13093053/barfmachine/products/portfolio/mail_holt.jpg

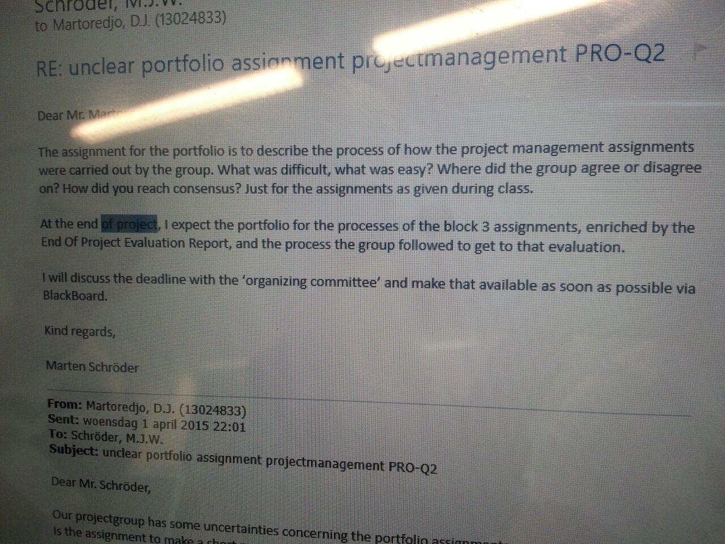
products/portfolio/mail_holt.jpg
