13093053/barfmachine/README.md

# Project PRO-Q2
Speaker amplifier system - Project HHS 2015
