13093053/barfmachine/products/final_design_report/Final Design Report PRO-Q2 team 1 (version1).pdf

## PRO-Q2 Final Design Report

Daan Conijn, 13023217
Andrew Lau, 13058339
Kevin Oei,13090062
Koen van Vliet, 13093053
Group 1

EQ2.a
EQ2.c

June 12th, 2015

## Contents

5 | 1 Summary | 4
| 2 Introduction | 5
| 3 The project problem, specifications and preconditions | 6
4 Design overview | 10
5 Preamplifier analysis | 19

2

6 Power supply design | 31
7 DCU design | 34

7.1 The DCU, related components, and its connection to the rest of

45 | 8 Test procedures and test results | 39
50 | 9 Total costs of system | 42
10 Conclusions and recommendations | 44

3

## 1 Summary

Section 2 gives an introduction of the project PRO-Q2 of team 1.

Section 3 explains the problem description regarding the design of the active
55 | loudspeaker in detail. The specifications and the preconditions are also pre-
| sented in section 3.
| Section 4 shows the design overview of the active loudspeaker. Schematics of
| the preamplifier, power supply, power amplifier and the DCU are presented in
| this section. The values of the components are also presented in the schematics.
60 | Section 5 gives an in-depth analysis of the preamplifiers regarding the calcula-
| tions, simulations and measurements.
| Section 6 explains the design of the power supply in detail. It explains what
| choices were made in the design of the power supply
| Section 7 explains what choices were made in designing the DCU, what code
65 | the DCU consists of and how the DCU functions.
| Section 8 gives the results of the test procedure and how the tests were done.
| Section 9 gives the total cost of the system. The prices and the types of the
| components are presentend in this section.
| Section 10 gives the conclusion and recommendations of the project as a whole.

4

70 | 2 | Introduction

In the second year of the Electrical Engineering course at The Hague University of Applied Science, project PRO-Q2 marks the end of the primary programme. All the specific knowledge and skills needed in previous projects come together in this one project with a duration of one semester. Students are presented with
75 | the challenge of designing a complete speaker system with digital enhancements.
| This report will offer the reader a detailed look into all of the design aspects
| realized by team 1 of PRO-Q2, as well as test results and an overview of the
| total costs of the required materials. After reading this report, one should be
| able to assemble the functional product as described in the report.

5

80 | 3 | The project problem, specifications and pre- conditions

The project problem introduces the fictional company BARK, a small yet wellknown manufacturer of loudspeakers [1]. For some time, BARK has contemplated the development of a series of active speakers using built-in power am-85 plifiers. The market price of these types of speakers have shown a significant reduction in the recent years, thus making it an interesting move for the company. Speakers with this setup offer a range of great advantages, including the avoidance of large speaker cables, the possibility of using cheaper electronic crossover circuits and a straight-forward design of the circuits.

90 It is likely that buyers of these active speakers also have the intention of buying a high-end stereo preamplifier. These types of preamplifiers are known to be expensive and uncommon. For this reason, BARK developed a new preamplifier to be built into the speaker system. The specifications of the preamplifier have already been established by a previous team.

95 | 3.1 | The problem

In light of the recent digitization of every electronic product, BARK decided that it also wants the speaker and its electronics to be controlled by a digital system of some sorts. However, being a loudspeaker manufacturer, their knowledge of analogue and digital electronic systems is somewhat limited. A series of 100 researches are to be conducted in order to gain the required knowledge and skills in these fields. The project team is to design an active loudspeaker system and realise a demonstration model according to the specifications and preconditions given. By the end of the project, the live demonstration should prove the correct operation. Documentation and a cost calculation are also to be provided.

105 | 3.2 | Specifications and preconditions

The specifications and preconditions given by BARK encompass both the analogue as well as the digital part of the to-be-designed system. The following components are described:

- Preamplifier

110 • Power amplifier

- Power supply
- Digital part

6

### 3.2.1 Preamplifier

The configuration of the preamplifier has already been partially determined.
115 | The values of the components have to be calculated and additional components
| have to be implemented in order to make the design of the preamplifier meet
| the required specifications.
| The specifications are as follows:

Overall specifications preamplifier Balance control in flat position, tone 120 (bass and treble) control switched off, volume control at maximum.

1. Input impedance: minimum 100 kΩ
2. Output impedance: maximum 100 Ω
3. Sensitivity : 2 V output voltage in RL = 20 kΩ at 200 mV input
4. Frequency range: 2 Hz to 400 kHz (-3 dB) at Vout = 500 mV, RL = 20
125 | kΩ
5. Output voltage: at least 7 V sinusoidal with RL = 20 kΩ , f = 1 kHz

Balance control specifications

1. Range ±6 dB (within ±0.5 dB) difference between right and left channels
2. In flat position +2 dB (within ±0.5 dB)

130 3. Approximate logarithmic control function

4. No DC current through the potentiometer nor the wiper

Bass and treble control specifications

1. Treble: Cut-off frequency adjustable between 2.5 and 10 kHz. Maximum boost or attenuation 10 dB (±1 dB) at 2.5 kHz. From 100 kHz and up
135 | the transfer function must approach value 1 (0 dB).
2. Bass: Cut-off frequency adjustable between 100 Hz and 400 Hz. Maximum
| boost or attenuation 10 dB (±1 dB) at 400 Hz. From 10 Hz and below
| the transfer function must approach value 1 (0 dB).

7

3. Approximate logarithmic control functions for cut-off frequencies and boost
140 | / attenuation adjustments
4. No DC currents through potentiometers nor wipers
5. Option: tone controls are switched on and off without any clicking noises
| from the speakers

Volume control specifications

145 1. Approximately logarithmic control function

2. No DC current through the potentiometer nor the wiper

The preconditions are as follows:

1. The potentiometers for balance, bass, treble and volume control are 10 kΩ linear.

150 2. The potentiometers for the adjustment of the bass / treble cut-off frequen- cies are 10 kΩ logarithmic.

3. All the preamplifier’s opamps are low noise NE5532 type. The NE5532 is
| a dual opamp version of the NE5534. Both Multisim and Pspice contain suitable models for the NE5532 and the NE5534.
155 | 4. The simulation results of the sub circuits and the preamplifier are rep- resented by the transfer function (amplitude and phase characteristics). These simulation results must be compared with the transfer function gained by measurement. Draw your conclusions.

### 3.2.2 Power amplifier specifications

160 1. Input impedance of at least 50 kΩ

2. Output power: 15 W sine in Rload = 8 Ω at 1 kHz
3. Frequency range: 10 Hz to 100 kHz (−3 dB) at Pload = 0.5 W in 8 Ω

For simplicity of design, the power amplifier should be a monolithic component.

8

### 3.2.3 Power supply

165 The power supply must supply all rated voltages and current in the system as to be determined by the project team. The power supply should be constructed using linear regulators. The projected efficiency should be 80% or better.

### 3.2.4 Digital part

The project team is to determine and develop the functionality of the digital part
170 | of the system. BARK mainly deals with analogue electronics, and so the project
| team is asked to help develop attractive features that are to be implemented
| within the project’s duration. The features should be discussed with the project
| coach beforehand. The system will consist of at least:
- An ATmega32 microcontroller or similar;

175 • Some kind of interaction with the analogue part of the system.

9

## 4 Design overview

As already hinted, the system primarily consists of four subsystems. They are the preamplifier, power amplfier, power supply and the digital component (referred to as ’DCU’ from here on, short for ’Digital Control Unit’). While the
180 | design for the preamplifier is already predetermined for the most part, all other parts have to be designed from scratch. An overview of the system’s design will be presented in this section, with minor to no additional clarifications on the design itself. The sections that follow will offer a detailed look into the analysis/design of the parts.
185 | 4.1 | Preamplifier

The design of the preamplifier can be divided in the following parts:

- Balance control
- Tone (bass and treble) control
- Volume control

190 These parts will be looked at in greater detail separately, figure 1 shows a schematic overview of the entire preamplifier to show the connection between the different parts.

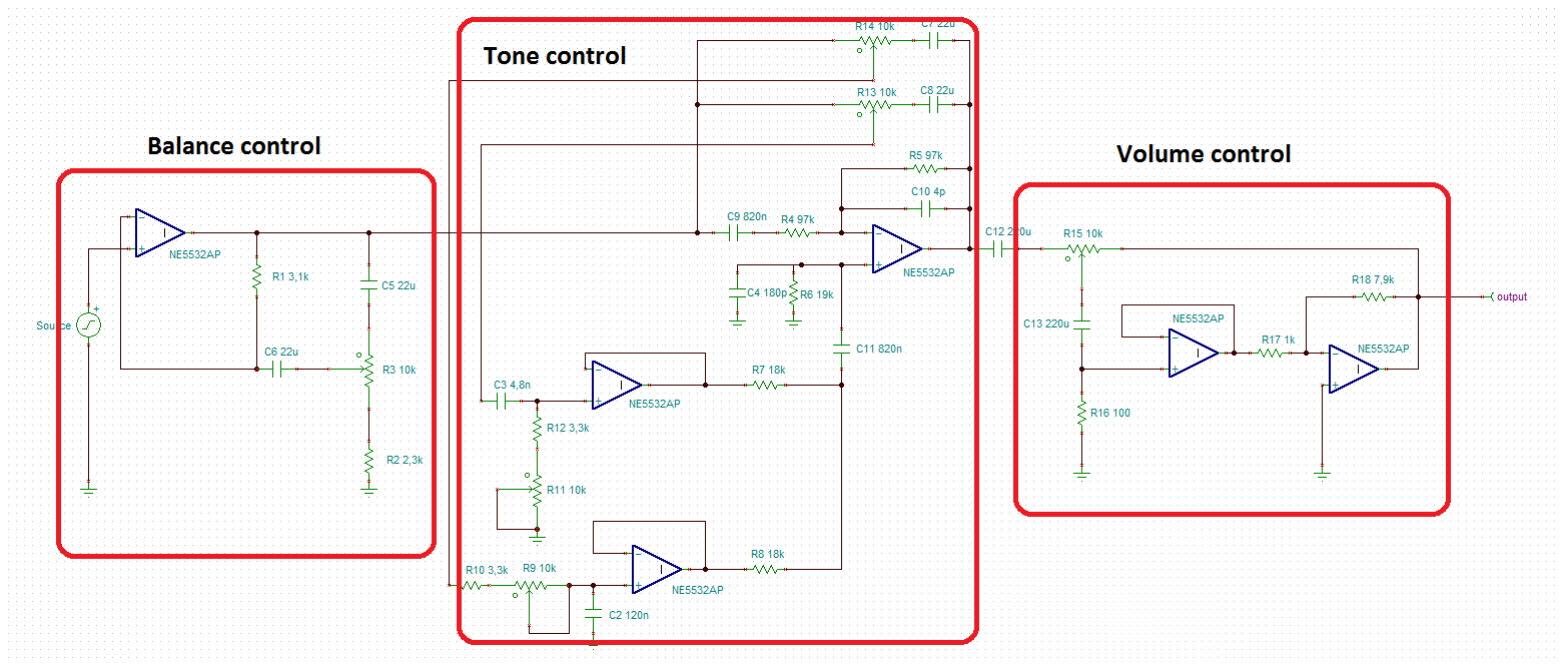
[picture p3: figure]

Figure 1: Schematic preamplifier

All parts of the preamplifier have been realized on prototyping boards.

10

A capacitor that filters out the AC signal removing the noise and provides a
195 | DC signal is known as a bypass capacitor. The capacitors connected at Vcc and
| Vee in figure 2 is a bypass capacitor bypassing AC noise and allowing pure DC
| signal to pass through the component.

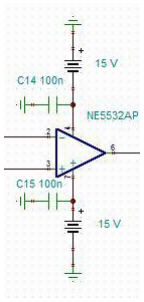
[picture p4: figure]

Figure 2: Schematic preamplifier

### 4.1.1 Balance control

The schematic of the balance control is as shown in figure 3. It function is to be
200 | able change the difference between the right an left channels. Thus if a stereo
| configuration is used then the balance of the output can be adjusted. Since
| there is only one channel in our configuration the balance control will function
| as an volume control with a range of 0 to 6dB. The digital potentiometer on the
| balance control is adjustable by using the DCU.

11

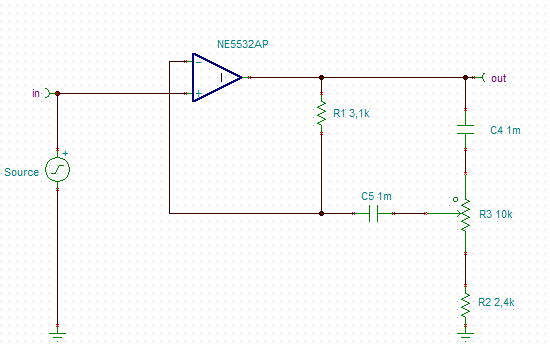
[picture p5: figure]

Figure 3: Schematic of balance control

205 | 4.1.2 | Tone control

The schematic of the Tone control is as shown in figure 4. The tone control will filter out the frequencies who are not in a 2Hz-400kHz range. Between this range there are two potentiometers who are used to adjust the Bandwidth of the Bass and Treble. Bass has a range from 10Hz through an adjustable Cut-off 210 frequency between 100Hz-400Hz. Treble has a range from an adjustable Cut-off frequency between 2.5kHz-10kHz through 100kHz. Within these ranges the signal can be boosted or attenuated by 10dB. All the potentiometers can be controlled using the DCU.

12

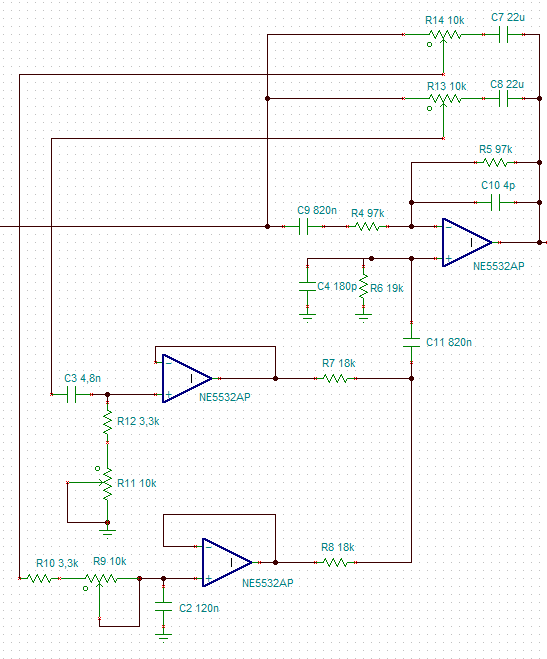
[picture p6: figure]

Figure 4: Schematic of tone control

### 4.1.3 Volume control

215 The schematic of the Volume control is as shown in figure 5. The volume control is used to boost or attenuat the signal as a whole. By adjusting the digital potetiometer the signal can be boosted or attenuated within an range of -24dB through 18dB.

13

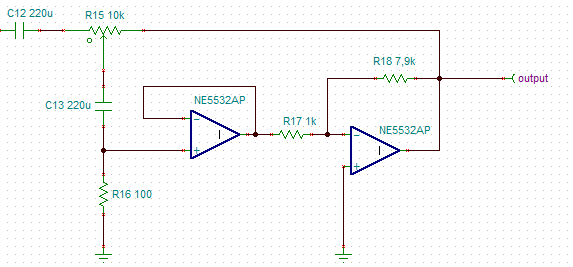
[picture p7: figure]

Figure 5: Schematic of volume control

### 4.2 Power amplifier

220 The schematic of the power amplifier design is as shown in figure 6.

14

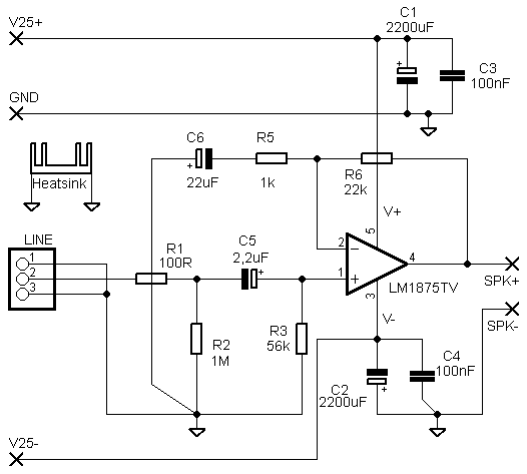
[picture p8: figure]

Figure 6: Schematic of power amplifier

Note that pins 1 and 3 of the line-in (named ’LINE’ in the schematic) are both connected to ground. This allows for plugging of the mating connector without having to worry about the connector being plugged in the wrong way around. It is also worth noting that a 100 Ω resistance is connected in series with the
225 | input to protect the amplifier against overvoltage. The added resistance allows
| the clamping diodes inside the amplifier to deal with any excess voltage.
| The PCB design of the power amplifier is as shown in figure 7.

15

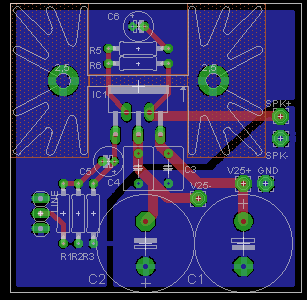
[picture p9: figure]

Figure 7: PCB board design of power amplifier

### 4.3 Power supply

The schematic of the power supply is as shown in figure 8.

16

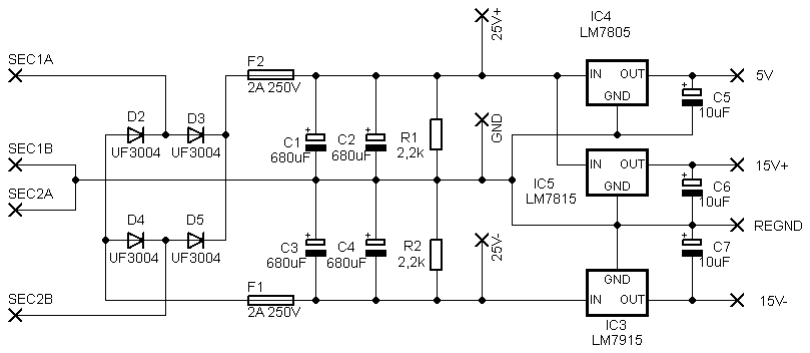
[picture p10: figure]

Figure 8: Schematic of power supply

230 The PCB design of the power supply is as shown in figure 9.

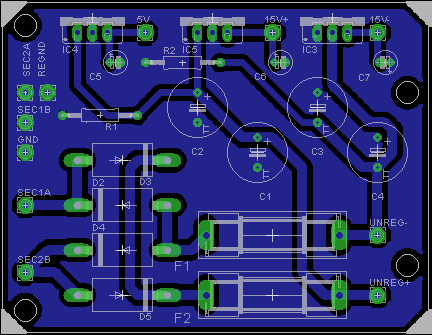
[picture p11: figure]

Figure 9: PCB board design of power supply

17

### 4.4 DCU

The following features and choices have been chosen/made for the implementation of the DCU:

- For the microcontroller, an ATmega328 will be used since it bears a lot of
235 | similarity with the ATmega32 which the team is most familiar with.
| • The DCU will allow digital control of the balance, tone, bass, treble and
| volume controls through the use of digital potentiometers.
| • MIDI messages will be used to pass commands to the DCU

Figure 10 shows a very basic schematic of the DCU’s place within the speaker 240 system.

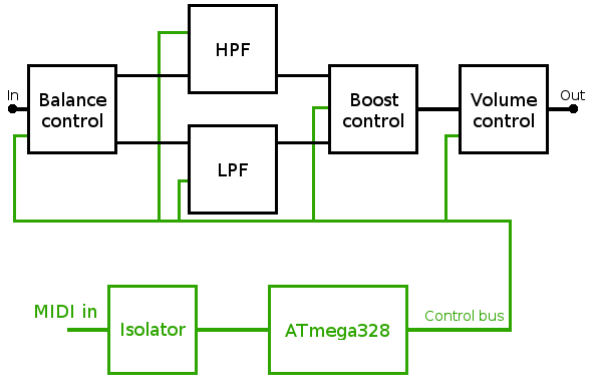
[picture p12: figure]

Figure 10: Block diagram of DCU

18

## 5 Preamplifier analysis

The in-depth analysis of the preamplifier consists of calculations, simulations and measurements. The calculations of the balance control, tone control and the volume control were already calculated in the measurement reports but the 245 calculations will again be discussed in this chapter.

### 5.1 Calculations

### 5.1.1 Balance control

In this section, the calculations of the components of the balance control are presented.

250 Figure11 shows the position of RH and RL.

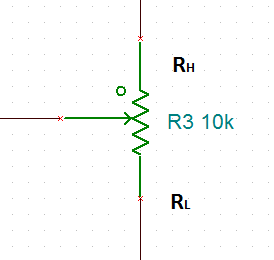
[picture p13: figure]

Figure 11: Positions of RH and RL of the potentiometer in the balance control

The formula for the gain of the balance control is equal to:

Gain =

R1//RH + RL + R2
RL + R2

= 1 +

R1//RH
RL + R2

(1)

In the manual it is stated that the gain must be +2 dB in flat position. Therefore the gain can be derived:

20 · log(Af lat−position) = 2 dB

19

log(Af lat−position) = 1
10

Af lat−position = 10

1
10 ≈ 1, 26 | (2)

In the manual it is stated that the gain must be +6 dB if the balance control is 255 in maximum position. Therefore the gain can be derived with the potentiometer in maximum position:

20 · log(Ahigh) = 6 dB

log(Ahigh) = 3
10

Ahigh = 10

3
10 ≈ 2 | (3)

equation (2) can be substituted in equation (1) and RH and RL are 5,000 Ω.

1, 26 =

5, 000 · R1
(R1 + 5, 000) · (R2 + 5, 000)

R2 + 5000 =

5, 000 · R1
1.26 · (R1 + 5, 000)

R2 =

3, 700 · R1 − 6.5 · 10⁶
1.26 · R1 + 1, 300) | (4)

equation (3) can be substituted in equation (1), RH = 10,000 Ω and RL = 0 Ω. The value of RLis actually very small (±0.5 Ω) but because the value is very 260 small, RL can be omitted.

2 = 1 +

10, 000 · R1
(R1 + 10, 000) · R2

R2 =

10, 000 · R1
(R1 + 10, 000) | (5)

20 equation (5) can be substituted in equation (4) and therefore the value of R1 can be calculated.

3, 700 · R1 − 6.5 · 10⁶
1.26 · R1 + 1, 300) =

10, 000 · R1
(R1 + 10, 000)

2, 600R

2

1 + 13 · 10⁶
- R1 = 3, 700 · R

2

1 + 30.5 · 10⁶

- R1 − 6.5 · 10¹⁰

1, 100R

2

1 + 17.5 · 10⁶

- R1 − 6.5 · 10¹⁰ = 0

R1R1 =

17.5 · 10⁶ ± 24, 336, 187
2, 200
R1 = 3, 107.35 ≈ 3, 107 Ω | (6)
R1 = −19, 016 Ω | (7)

A resistor can never have a negative value so therefore R1 is equal to 3,107 Ω. To calculate R2 , equation (6) can be filled in in equation (4) or equation (5).

R2 =

10, 000 · 3, 107
(3, 107 + 10, 000) = 2, 370 Ω | (8)
265 | 5.1.2 | Tone control

The tone control is divided into five sections. The tone control contains two low-pass filters, two high-pass filters and a band-pass filters as seen in figure 12.

21

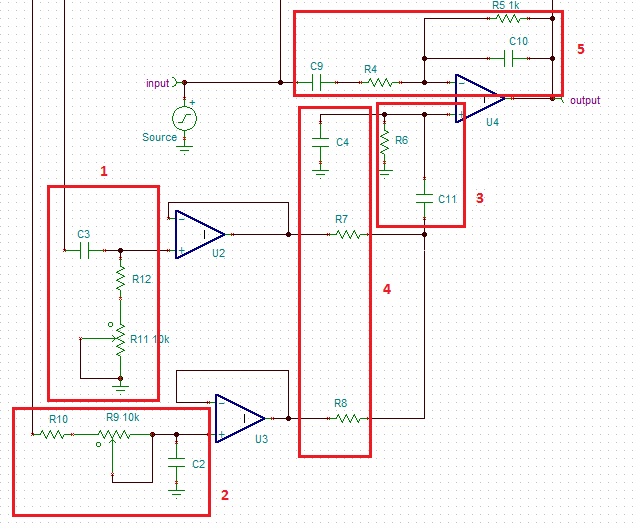
[picture p14: figure]

Figure 12: Tone control divided in sections

Section 1: A high-pass filter with a cut-off frequency adjustable between 2,5 kHz and 10 kHz

270 | Section 2: A low-pass filter with a cut-off frequency adjustable between 100 Hz and 400 Hz
| Section 3: A high-pass filter with a cut-off frequency of 10 Hz
| Section 4: A low-pass filter with a cut-off frequency of 100 kHz
| Section 5: A band-pass filter with a cut-off frequency of 2 Hz and 400 kHz
275 | Section 1 The HPF
| At a frequency of 10 kHz

10000 =

1
2π · R12 · C3

C3 =

1
2π · R12 · 10000

(9)

22

At a frequency of 2.5 kHz

2500 =

1
2π · (R12 + 10000) · C3

C3 =

1
2π · (R12 + 10000) · 2500

(10)

Substitute equation (9) in equations (??) and (??) to calculate resistor

1
2π · R12 · 10000

=

1
2π · (R12 + 10000) · C
R12 = 3333.33 Ω | (11)

Substitute equation (11) in equations (??) and (??) or equation (9) to calculate 280 the capacitor

C3 =

1
2π · (3333.33 + 10000) · 2500
= 4, 8 nF | (12)

Section 2 The LPF

At a frequency of 400 Hz

400 = | 1 2π · R10 · C2

C2 =

1
2π · R10 · 400

(13)

At a frequency of 100 Hz

100 =

1
2π · (R10 + 10000) · C2

C2 =

1
2π · (R10 + 10000) · 100

(14)

23

Substitute equation (13) in equation (14) to calculate resistor

1
2π · R10 · 400

=

1
2π · (R10 + 10000) · 100
R10 = 3333, 33 Ω | (15)
285 | Substitute equation (15) in equation (13) or equation (14) to calculate the ca-
pacitor

C2 =

1
2π · (3333, 33 + 10000) · 2500
= 119 nF | (16)

Section 3 The HPF

The maximum value of a ceramic capacitor available in the lab at the Hague University is 820 nF.

290 Capacitor C11 is chosen for 820 nF and with a cut-off frequency of 10 Hz for the HPF, the resistor R6 can be calculated with the formula:

R6 =

1
2π · C11 · 10
R6 = 19, 409 Ω | (17)

Section 4 The LPF

The maximum boost or attenuation of the bass must be 10 dB at 400 Hz and the maximum boost or attenuation of the treble must be 10 dB at 2.5 kHz.

295 The gain of the boost is equal to:

GainBoost =

R7//R8 + R6
R7//R8

20 · log(

R7|//R + R6
R7|//R ) = 10 dB

24

R7//R8 + R6
R7//R = 10

1
2 | (18)

The gain of the attenuation is equal to:

GainAttenuation =

R7//R
R7//R8 + R6

20 · log(

R7//R8
R7//R8 + R6

) = −10 dB

R7//R8
R7//R8 + R6

= 10⁻ ¹
2 | (19)

The resistors R6, R7 and R8 can be any values, as long as the values of the resistors meet the requirement for the boost to be 10dB with the potentiometer in maximum position.

300 | It is best if R7 is equal to R8 because the boost and attenuation of the bass and treble will differ. R7 and R8can be calculated by substituting the value of R6 in equation (18) or equation (19)
| R7//R8 + 19, 409 R7//R8 = 10
| 1
| 2

R7//R8 + 19409 = 3, 16 · R7//R8

R7//R8 = 8, 900 Ω

R7 = R8 = 17, 800 Ω | (20)

With a cut-off frequency of 100 kHz for the LPF in section 4, the capacitor C4 can be calculated with the formula:

C4 =

1
2π · (R7//R8) · 100 · 10³
C4 = 180 pF | (21)

25

305 | Section 5 The BPF
| The frequency range must be between 2 Hz and 400 kHz and the gain at these frequencies must be -3 dB. Therefore the resistors and capacitors can be calcu- lated for the band-pass filter with the formula:

fcut−of f =

1
2π · R · C

(22)

For the design of the band-pass filter, a value of 820 nF is chosen for capacitor
310 | C9. The resistors can now be calculated.
| For the HPF part of the band-pass filter is the resistor R4 equal to:

R4 =

1
2π · 2 · 820 · 10⁻⁹
= 97, 045 Ω | (23)

The balance control and the volume control regulate the gain of the preamplifier. Therefore the band-pass filter does not need to amplify the signal. Thus it is neccessary for R4 to be equal to R5to attain a gain of 1 (0 dB).

315 For the LPF part of the band-pass filter, the capacitor is equal to:

C10 =

1
2π · 400 · 10³ · 97, 045
= 4.1 pF | (24)

### 5.1.3 Volume control

With an input voltage of 200mV, an output voltage of 2V must be acquired with the balance control in flat position, tone (bass and treble) control switched off and the volume control at maximum. With a gain of approximately 1.26 in the
320 | balance control and a gain of 1 in the tone control, the voltage at the input of
| the volume control is approximately equal to:
Uinput−volume−control = 1.26 · 1 · 200mV = 252 mV | (25)

The input voltage of the volume control is now known and because the volume control is at maximum, the voltage at the output of U5 is equal to the input voltage of the volume control. The values of R17 and R18 can be calculated.

26

R18

R17

- Uinput−volume−control = 2 V

R18

R17

- 0.252V = 2 V

325
R18

R17

= 7.94 | (26)

The ratio between R18 and R17 is 7.94. The values of R18 and R17 can be determined. The following values have been chosen for R18 and R17:

R18 = 7, 940 Ω | (27)
R17 = 1, 000 Ω | (28)

With the volume control at minimum, the gain should be very low (-∞ dB) but that is impossible in practice. Therefore simulations are required to determine 330 what the gain can be if the volume control is almost set to the minimum (99%). The gain with the volume control set almost to the minimum is approximately -50 dB. The gain with the potentiometer in middle position (50%) is equal to:

17.95dB − (

17.95dB − −50dB
2

) = −16 dB

Resistor R16 can be calculated to acquire an approximate logarithmic control function:

20 · log|

R16
5, 000 + R16

·

7, 940
1, 000

| = −16 dB

335
log(

R16
5, 000 + R16

·

7, 940
1, 000

) = −

16
20

R16
5, 000 + R16

·

7, 940
1, 000

= 10⁻ ¹⁶
20
R16 = 100 Ω | (29)

27

### 5.2 Simulations

Figure 13 shows a simulation of the bode plot of the preamplifier with the bass and treble both at maximum boost, the volume control in mid position, the
340 | balance control in mid position, the bass corner frequency at 400 Hz and the
| treble corner frequency at 2.5 kHz.

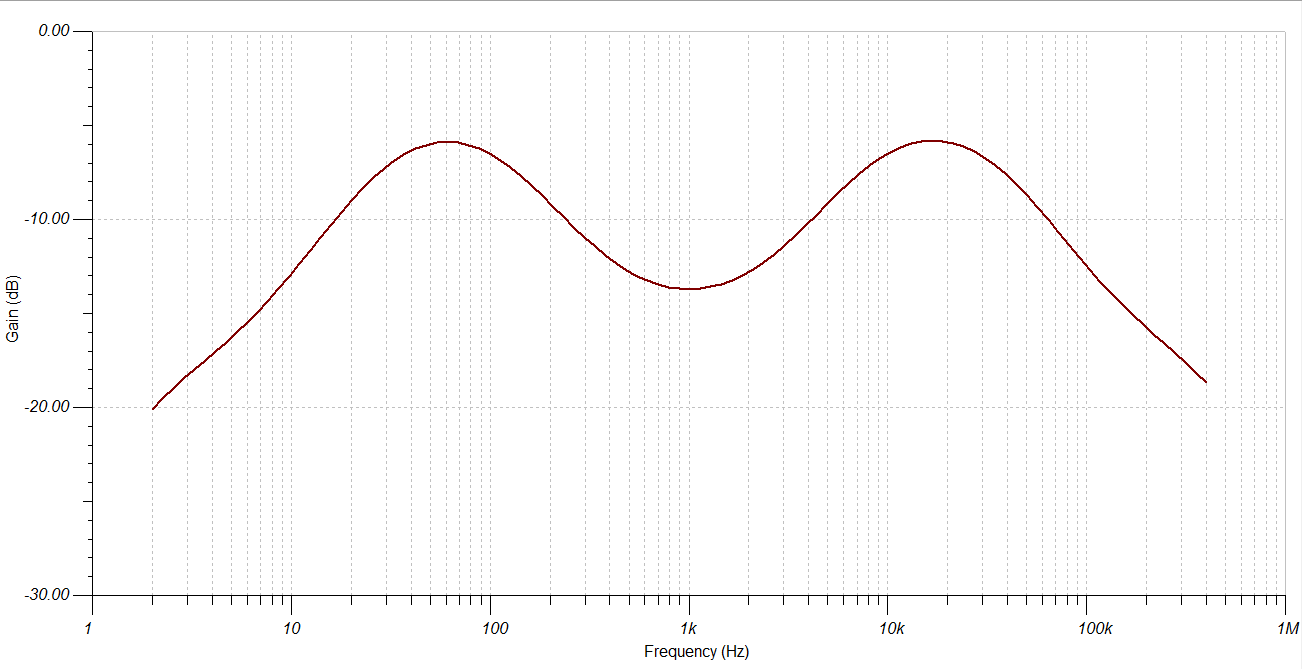
[picture p15: figure]

Figure 13: Bode plot of the preamplifier in maximum boost

Figure 14 shows the simulation of the bode plot of the preamplifier with the bass and treble both at maximum attenuation, the volume control in mid position, the balance control in mid position, the bass corner frequency at 400 Hz and 345 the treble corner frequency at 2.5 kHz.

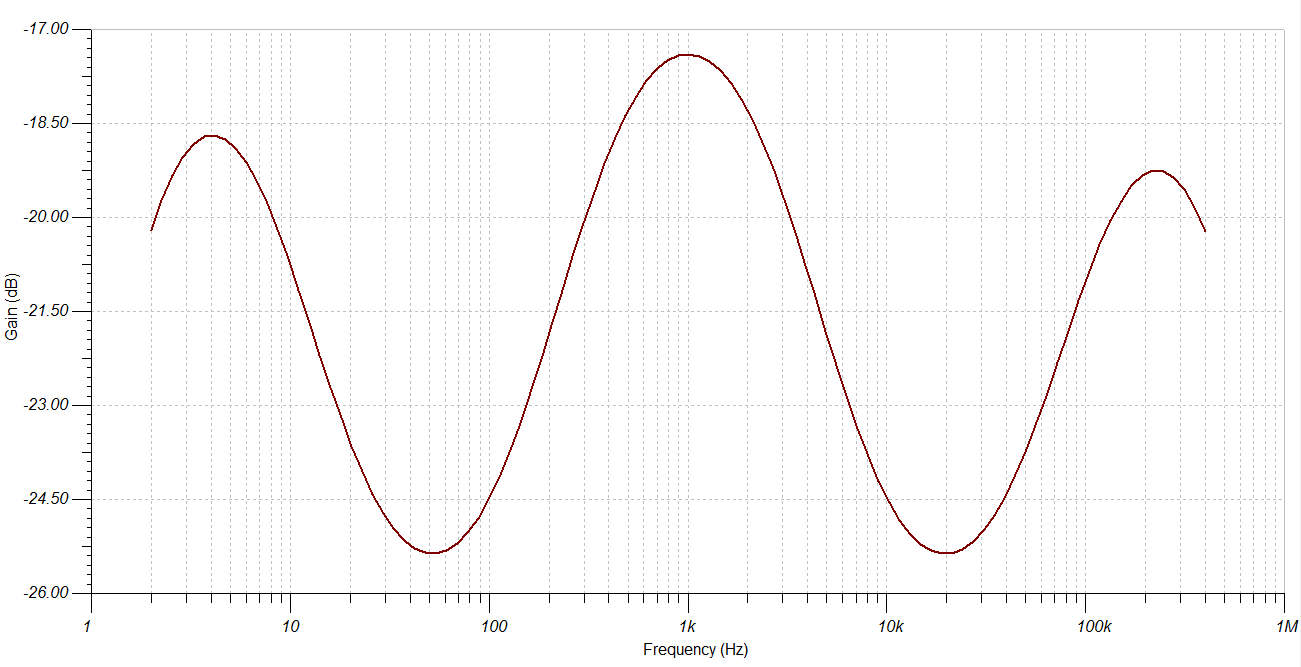
[picture p16: figure]

Figure 14: Bode plot of the preamplifier in maximum attenuation

28

### 5.3 Measurements

Figure 15 shows a bode plot of the preamplifier with the bass and treble both at maximum boost, the volume control in mid position, the balance control in mid position, the bass corner frequency at 400 Hz and the treble corner frequency 350 at 2.5 kHz. The measurements for determining the bode plot in figure 15 are in table 4 in Appendix A.

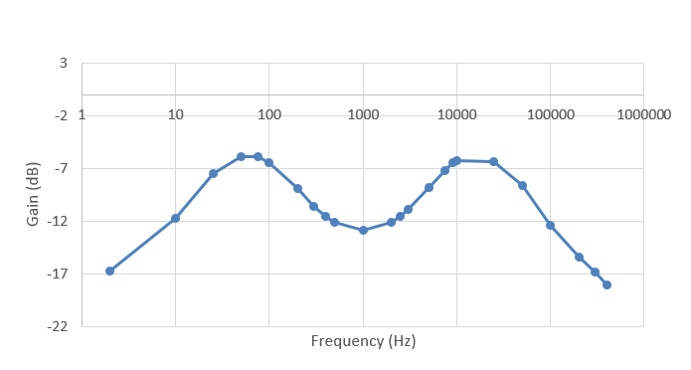
[picture p17: figure]

Figure 15: Bode plot of the preamplifier in maximum boost

Figure 16 shows a bode plot of the preamplifier with the bass and treble both at maximum attenuation, the volume control in mid position, the balance control in mid position, the bass corner frequency at 400 Hz and the treble corner 355 frequency at 2.5 kHz. The measurements for determining the bode plot in figure 16 are in table 3 in Appendix A.

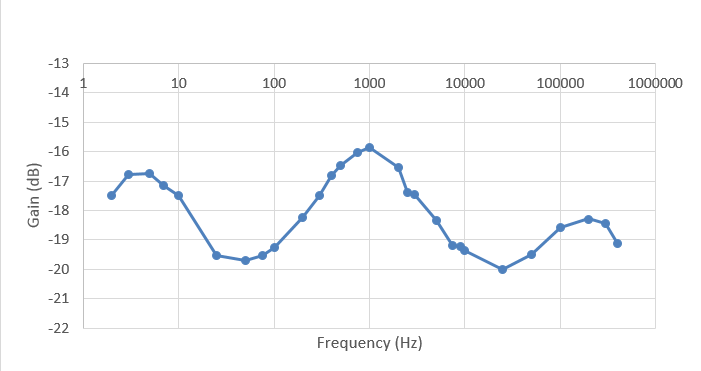
[picture p18: figure]

Figure 16: Bode plot of the preamplifier in maximum attenuation

29

The bode plots of the measurements correspond with the bode plots of the simulations.

30

## 6 Power supply design

360 The power supply takes 230V mains and converts it to lower voltages to power the various modules in the speaker system. First a quick design overview is given and the schematic is explained. Then the individual stages of the supply are discussed and finally the energy efficiency and board layout are explained.

### 6.1 Design overview

365 | The power supply is a linear non-switching supply, which uses a toroidal trans- former to take 230V mains down to 36V. The power amplifier and the pream-
| plifier require a split supply by design, so a transformer with two secondary windings is used. After the transformer comes a bridge rectifier which converts
| the AC signal to DC. Then finally the signal will pass through several filter
370 | capacitors to smooth out the voltage.

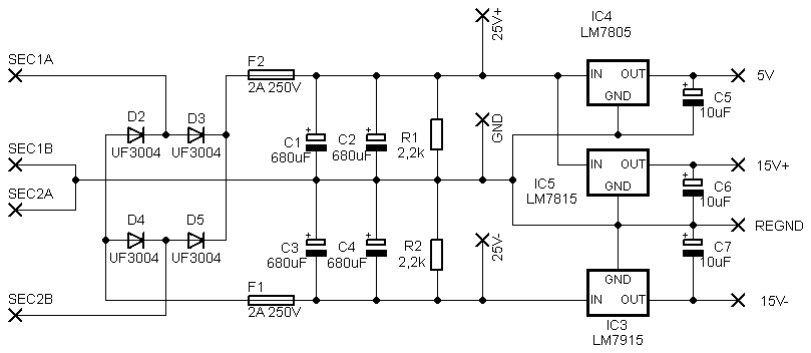
[picture p19: figure]

Figure 17: Power supply schematic

### 6.2 Filter section

Per rail two filter capacitors are used in order to reduce the ripple voltage caused by the equivalent series resistance. A bypass resistor is put in parallel with the capacitors, so they discharge safely when the power supply is switched off even
375 | with no load on the output.
| The nominal voltage can be calculated as follows:

31

Vin,pk−pk = Vin ∗

√
2 = 36 ∗

√
2 = 51V

V out = Vin,pk−pk − 2Vd(on) = 51 − 1.4 = 50V

At full power output the ripple voltage on the positive and negative supply can 380 be calculated:

Ton =

1
2f =

1
100

∆V out =

I∗Ton
C =

0.7∗0.01
2∗680∗10⁻⁶ = 5V

According to the power amplifier’s specifications this is an acceptable ripple voltage. Additional filter capacitors were added close to the power amplifier to 385 reduce the loop size and increase stability. With these additional capacitors in place the ripple voltage becomes:

∆V out =

I∗Ton
C =

0.7∗0.01
(2∗680+2200)∗10⁻⁶ = 2V

### 6.3 Protection

The power supply is fused on both secondary windings to protect the transformer
390 | against high currents. The nominal current of the secondary windings of the
| transformer is 0.420A while the power amplifier takes 0.694A from the supply
| at max power . The capacitors in the power supply will smooth out the load
| on the transformer, so it does not exceed the nominal current. The fuses on
| the secondary windings are rated 2A, so they only blow on a short circuit. The
395 | primary winding could be fused optionally.

### 6.4 Regulator section

The preamplifier and DCU require lower voltages, so linear voltage regulators are used to step down the voltage. For the power amplifier, however an unregulated supply is used. The regulators require small capacitors between the output 400 terminals to stabilize the output voltage, so a few 10uF capacitors were added.

### 6.5 Efficiency

As said before, the power amplifier’s power rails are unregulated. This is required to meet the 80% energy efficiency requirement. If linear regulators were used to regulate 25 down to 20V at 0.5A this would result in a 2.5W loss in the

32

405 regulator. In this case the energy efficiency would be 80% for the regulator stage alone. The power dissipated in the linear regulators for the preamp and dcu is neglectable, because these parts take very little current compared to the power amplifier. The overall efficiency of the power supply is equal to the efficiency of the transformer multiplied by that of the diode bridge rectifier.

ηdiode =

Vin,pk−pk−2Vd(on)

Vin,pk−pk

=

51−1.4
410 | 51 | = 0.97

ηtransformer = 0.87

ηtotal = ηdiode ∗ ntransformer = 0.85

Therefore the overall efficiency is 85%.

### 6.6 Board layout

415 The power supply can be constructed on a single sided board to reduce manufac- turing cost. The components are all through-hole, because small surface mount parts cannot handle the high voltages and currents. It also makes soldering a prototype by hand easier.

Figure 18: Power supply board layout

33

## 7 DCU design

420 | The DCU’s entire functionality was to be determined by the project team. The only requirements given by BARK were the use of an ATmega32 microcontroller or similar controllers, and some kind of interaction with the analogue part of the system. In team 1’s case, the DCU allows control of all audio controls (potentiometers) in the analogue circuits using MIDI messages. The DCU then
425 | adjusts the values of digital potentiometers placed in the circuits based on the incoming MIDI message. First, the physical design of the DCU and related components are discussed. After that, the code used for the DCU will be looked
| at.

### 7.1 The DCU, related components, and its connection to

430 | the rest of the system

The choice to use MIDI messages as input for the DCU was made with the idea that MIDI hardware is generally designed for use with music and/or audio. On top of that, professional mixing devices can be controlled using computer software, allowing preset settings to be loaded in a matter of a few clicks. Many
435 | MIDI devices include twisting knobs which act as potentiometers, and thus being
| able to use a MIDI device to control the various controls in the circuitry allows for an intuitive and easily expandable/customizable user interface. The type of
| digital potentiometers used in combination with the DCU are the MCP4251- 103E/P (see figure 19).

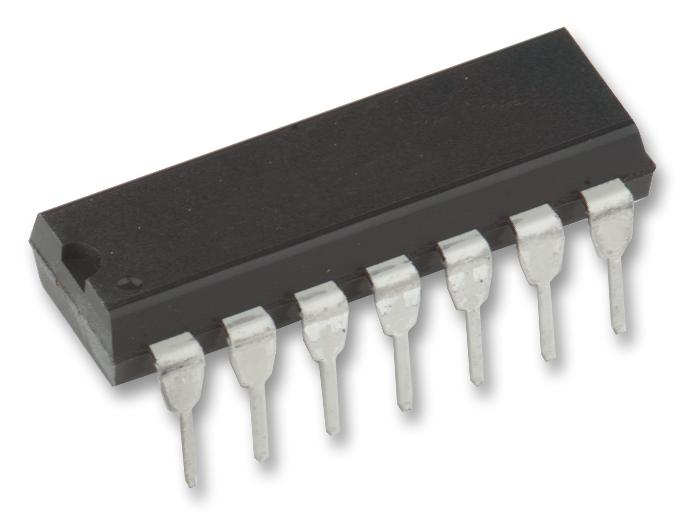
[picture p20: figure]

Figure 19: The MCP4251-103E/P

34

440 | These models hold two potentiometers per package, and expect incoming com-
| mands through SPI which makes them easily usable with the ATmega328 which
| supports a direct SPI connection. As illustrated in figure 20, the digital poten-
| tiometers allow the DCU to take over control of the balance control, bass cut-
| off control, treble cut-off control, bass boost control, treble boost control and
445 | volume control. In its current state, the code only handles so-called ’Control
| Change’ MIDI messages which indicate the change of a physical control, such as
| a knob. These messages include a value indicating the position of the knob as
| well as an identifier indicating which specific knob was changed. The message is
| processed in the DCU and the correct command is passed on to the appropriate
450 | potentiometer over the SPI connection. Only when a new ’Control Change’ message is received, will the digital potentiometer(s) be adjusted accordingly.

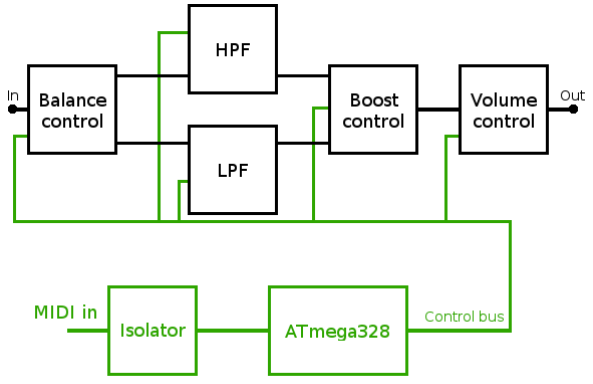
[picture p21: figure]

Figure 20: Block diagram of DCU

As seen in figure 20, the control bus (ATmega328 SPI output) is connected to all parts of the preamplifier. The control bus consists of seven signal lines: six CS (chip select) lines and one data line (carrying the value to be read by
455 | the digital potentiometer. The MIDI input and the USART of the ATmega328
| are electrically isolated using an optocoupler. This protects both devices from
| overvoltage and static discharges. It also makes it possible to swap out midi cables while the speaker system is powered on. Figure 21 shows the schematic of the DCU part.

35

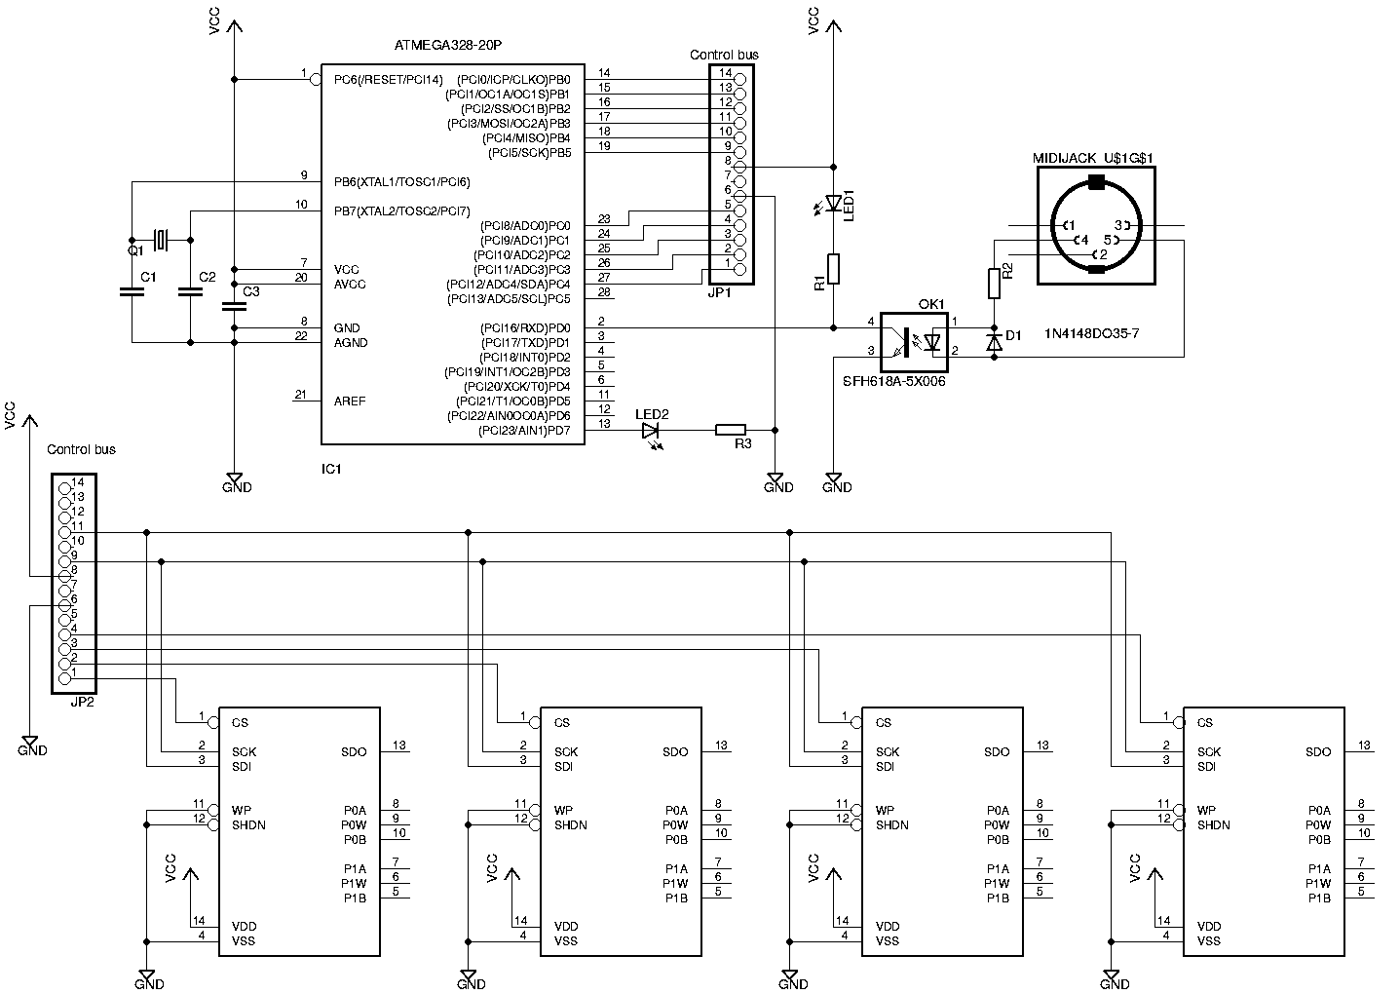
[picture p22: figure]

Figure 21: Schematic of DCU

460 | 7.2 | C code

The C code can be divided into the following subsections:

- Headers for digital potentiometers and MIDI
- Initialization
- Main program loop
465 | • MIDI input functions
| • Digital potentiometer output functions

The individual blocks of code will be discussed and explained. In order to see how the different parts of the code are connected to each other, the complete C code can be found in Appendix B. When addressing specific pieces of code, 470 references will be made to the line numbers as seen in these appendices.

36

### 7.2.1 digipots.h and midi.h

The two custom header files used in the code contain all the constants asssociated with the ports (and pins) connected to the peripheral devices. As seen in Appendix B, digipots.h contains the correct values to set the DDR and PORT
475 | registers associated with the potentiometers. The *_CS_PIN constants define the
| correct value to be written to the PORT register that drive the CS pins of the
| digital potentiometers. Since there is only one data line for all of the controls,
| when writing a value to the digital potentiometers, only the appropriate CS
| pins are to be driven. This will become more clear when the output functions
480 | are discussed. midi.h contains all the constants associated with the incoming
| MIDI data. MIDI messages consist of at least one byte. In case of MIDI Control
| Change messages which we are concerned with, a full message consist of three
| bytes: a command byte 1011nnnn, and Controller Number byte 0ccccccc and
| a Controller Value byte 0vvvvvvv respectively where nnnn denotes the MIDI
485 | channel, ccccccc denotes the controller number and vvvvvvv denotes the value
| of the controller. CTRL_CH is the byte value in the MIDI message that denotes the type of MIDI command (in our case, Control Change). The *_CTRL constants
| are used to define what controller number (in the 0ccccccc byte) correspond
| to what control. This way the program will be able to determine which CS pin
490 | should be driven when the received controller value is passsed on to the digital
| potentiometers.

### 7.2.2 Initialization

The initializations are made in dcu.c, from the beginning to line number 66. The global variables are declared, appropriate DDR registers are set, the USART
495 | registers are set, and the SPI registers are set. Finally, all controls are reset by
| initializing the digital potentiometers to maximum position. The appropriate
| values to be loaded into the UBRRH and UBRRL registers of the USART have
| been calculated based on the values defined in line numbers 20 to 24. The for-
| loop on lines 61 to 63 set the digital potentiometers to the maximum value one
500 | by one.

### 7.2.3 Main program loop

The main program loop, an infinitely looping while-loop from lines 69 to 106, calls the appropriate functions to control the digital potentiometers whenever new data is received from the MIDI device through the USART. The program
505 | will wait at the while (rxcnt == 0); lines for a new byte to arrive through the
| USART. On line 73, a command byte will be expected. If a new byte is received,
| it is stored into cmd. On line 74, the command byte is checked for validity.
| 37

If valid, the program continues and the error LED is turned off. Otherwise, the program will end up waiting at line 72 again for a valid command byte.
510 | After passing the command validity check, the same process is repeated for the
| Controller Number and Contorller Value bytes. If either of these checks fail, the
| else-statement is executed and a LED is switched on using toggleErrorLED(). When all received bytes are valid (making up a complete valid three-byte Control
| Change message), a switch case at lines 83 to 95 will select the appropriate
515 | action. There is only one case in this case (excluding the default case), but the
| system can be expanded in the future to include more functionality using this
| switch case.

### 7.2.4 MIDI input functions

There are two blocks of code dealing with the incoming MIDI messages. They
520 | are the interrupt service routine (ISR) USART_RXC_vect (lines 151 to 169) and
| the function ugetc() (lines 185 to 192). Whenever a MIDI device sends a byte
| to the ATmega328, the ISR is executed and the incoming data is checked. If the
| USART deems the data valid, the UDR is unloaded into variable c and stored
| into the buffer sb if it is not full yet. Finally, rxcnt is incremented. One can
525 | now see that in the main loop, the program will only pass the ’waiting’ lines
| when rxcnt is not equal to zero, which means one or more unread bytes are
| stored in the buffer.
| When a message byte needs to be stored into the variables in the main loop,
| ugetc() is called. This function selects the correct byte in the buffer and stores
530 | it in local variable c. It then decrements rxcnt and returns c.

### 7.2.5 Digital potentiometer output functions

There are two functions related to the output controlling the digital potentiometers. They are spiSend() (lines 112 to 117) and setPot() (lines 119 to 139). When setPot() is called, a switch case chooses the appropriate case based on
535 | the parameter potno. Inside each case, the appropriate CS pin is driven and
| spiSend() is called with the appropriate parameters.
| spiSend() takes two arguments, the memory address value memcom and the
| control value val. This function does nothing more but transmitting the two
| bytes over SPI one by one. The while statements force the program to wait with
540 | continuing untill the SPI is finished with he transmission.

38

## 8 Test procedures and test results

Figure 22 shows the complete loudspeaker system. This active loudspeaker system was tested using the procedures below.

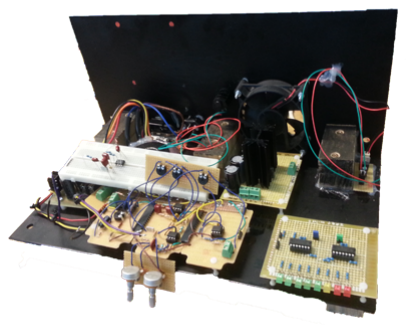
[picture p23: figure]

Figure 22: The built active loudspeaker system

### 8.1 Equipment

545 | The following equipment was used to test the active loudspeaker system:
| • Audio source (e.g. phone)

39

- Audio cable
- Power cable
- ’TEKTRONIX DPO2004B’ oscilloscope

550 • 8Ohm speaker

### 8.2 Setup

- Remove all power and audio cables from the speaker system and make sure the power switch is turned off before proceeding.
- Connect the speaker to the output of the power amplifier.
555 | • Connect the audio source to the input of of the preamplifier.
| • Connect the power cable to the input of the power supply.
| • Make sure that everything is connected before switching the power on.
| • Switch the power on.

40

### 8.3 Results

Table 1: The result of the test
# | Procedure | Expected Results | Pass / Fail / Not Tested

| Play music from the audio source | Hear music coming from the speaker regardless the performance of the sound. | Pass
1 | Test the volume of the preamplifier. | No audible sound when the volume control adjust is turned down to the minimum. The sound will get louder as the volume control is turned up to the maximum
Pass
2 | Is the sound clear? | No distortion, no clipping, little mains hum
Pass
3 | Test the bass of the preamplifier | Low frequencies will be heard when the bass is in maximum boost.
Pass
4 | Test the treble of the preamplifier | High frequencies will be heard when the treble is in maximum boost
Pass
| Switch off the unit and remove the heatsink.
5 | Turn up the volume. Does the thermal shutdown feature of the amplifier work? | The amplifier should shut down when it reaches 170°C
Pass

6 | Test the DCU system | Not Tested
560 | 8.4 | Notes on the test

There were some problems with test number 2 in table 1. The sound coming from the speaker temporarily shuts down (approximately two seconds) and turns back on. This problem happens in an interval between 10 to 15 seconds. This problem is solved by measuring the outputs of the power amplifier and
565 | the preamplifier and comparing the signals during the shutdown of the sound.
| During shutdown there is no signal at the power amplifier but there is a signal
| at the preamplifier. This means that the problem lies within the power ampli-
| fier. After examining the power amplifier, it was discovered that the transistor
| wasn’t attached well to the heatsink, so it would become too hot and shut itself
570 | down. After tightening the bolt that clamps the heatsink to the power amplifier
| there have been no more thermal shutdowns.

41

## 9 Total costs of system

The following components are required to build the power amplifier, preamplifier, power supply and digital control unit. Please note that these prices are
575 | only an indication. Prices may change over time.
Name | Amt | Farnell No, Price Each | Price
Power supply
Power switch | 1 | 1839427 | 4,45 | 4,45
Transformer | 1 | 9530380 | 24,98 | 24,98
D2/D3/D4/D5: | 4 | 1861507 | 0,0638 | 0,2552
Power connector | 1 | 2080459 | 0,95 | 0,95
Fuse holder | 3 | 1162740 | 0,563 | 1,689
C1/C2/C3/C4 : 680u | 4 | 1800669 | 0,26 | 1,04
C5/C6/C7: 10u | 3 | | 0,1 | 0,3
R1/R2: 2.2k | 2 | | 0,02 | 0,04
IC4:LM7805CT | 1 | 1102157 | 0,84 | 0,84
IC5:LM7815CT | 1 | 2296025 | 0,71 | 0,71
IC3:LM7915CT | 1 | 2296026 | 1,22 | 1,22
HEATSINK | 3 | 1710627 | 0,506 | 1,518
Fuse 2A,250V | 3 | 1123175 | 0,183 | 0,549
Power amplifier
LM1875T | 1 | 1468913 | 3,36 | 3,36
HEATSINK | 1 | 1319813 | 5,29 | 5,29
R1: 100 | 1 | | 0,02 | 0,02
R2: 1M | 1 | | 0,02 | 0,02
R3: 56k | 1 | | 0,02 | 0,02
R5: 1k | 1 | | 0,02 | 0,02
R6: 22k | 1 | | 0,02 | 0,02
C1/C2: 2200uF | 2 | 2346523 | 1,63 | 3,26
C3/C4: 100nF | 2 | | 0,1 | 0,2
C5: 2.2uF | 1 | | 0,1 | 0,1
C6: 22uF | 1 | | 0,1 | 0,1
Preamplifier
Phono Jack | 1 | 148266 | 2,38 | 2,38
NE5532P | 4 | 1106092 | 0,79 | 3,16
R1: 3.1k | 1 | | 0,02 | 0,02
R2: 2.4k | 1 | | 0,02 | 0,02
R4/R5: 97k | 2 | | 0,02 | 0,04
R6: 19k | 1 | | 0,02 | 0,02

42

R7/R8: 18k | 2 | | 0,02 | 0,04
R10/R12: 3.33k | 2 | | 0,02 | 0,04
R16: 100 | 1 | | 0,02 | 0,02
R17: 1k | 1 | | 0,02 | 0,02
R18: 7.9k | 1 | | 0,02 | 0,02
C2: 120n | 1 | | 0,1 | 0,1
C3: 4.8n | 1 | | 0,1 | 0,1
C4: 180p | 1 | | 0,1 | 0,1
C5/C6/C7/C8: 22u | 4 | | 0,1 | 0,4
C9/C11: 820n | 2 | | 0,1 | 0,2
C10: 4p | 1 | | 0,1 | 0,1
C12/C13: 220u | 2 | | 0,1 | 0,2
C14...C22: 100nF | 8 | | 0,1 | 0,8
IC socket DIP8 | 4 | 2445620 | 0,195 | 0,78
Digital control unit
IC1: ATMEGA328-PU | 1 | 1972087 | 2,36 | 2,36
MCP4251-103E/P | 4 | 1578442 | 0,921 | 3,684
IC socket DIP28 | 1 | 2445626 | 0,44 | 0,44
IC socket DIP14 | 4 | 2445621 | 0,198 | 0,792
Crystal 16MHz | 1 | 1611761 | 0,378 | 0,378
C1/C2: 22pF | 2 | | 0,1 | 0,2
LED1/LED2: red led | 2 | 2112100 | 0,214 | 0,428
D1:1N4148 | 1 | 9565124 | 0,0203 | 0,0203
R1/R2/R3: 150 | 3 | | 0,02 | 0,06
VO617A-2 | 1 | 2251550 | 0,187 | 0,187
DIN5 jack | 1 | 1280804 | 1,45 | 1,45
C3: 100n | 1 | | 0,1 | 0,1
IC socket DIP6 | 1 | 2445619 | 0,204 | 0,204
Misc
TERMINAL
BLOCK | 10 | 3041440 | 0,819 | 8,19
Pin headers m20 | 2 | 671990 | 1,6 | 3,2
Pin headers f20 | 1 | 1577768 | 2 | 2
PCB single sided | 1 | 149056 | 13,46 | 13,46
Misc wire ass. | 1 | | 2 | 2
| | Total (ex vat): | | ?98, 66
| | Total: | | ?119, 38

43

## 10 Conclusions and recommendations

After approximately 2 months of working on PRO-Q2, the active loudspeaker was finally finished by connecting the power supply, the power amplifier and the preamplifier. After testing the active loudspeaker as a whole, the team
580 | concluded that the active loudspeaker works. The sound may not be perfect
| but at the very least the speaker is able to reproduce sound without excessive
| distortions. Unfortunately the DCU was not tested.
| The bass and treble also works well when turning the bass and treble on and off.
| The volume control works well when turning the volume off and on. The balance
585 | control works when turning the balance control on and off. The preamplifier was
| simulated and measured and the bode plots of the simulations and measurements
| correspond with each other as seen in section 5. The conclusion can be made
| that the calculations of the components of the preamplifier are correct and that
| the preamplifier meets the specifications.
590 | The power supply meets all specifications and it supplies all voltages required
| to make the system work.
| The power amplifier meets all specifications, its temperature stays within the
| accepted range and it produces clean audio.
| As the source code in the appendices already notes, at the time of writing the
595 | DCU had not been connected and tested yet. Building the code resulted in
| the expected errors associated with the yet-to-be-defined values in the header
| files, but all other errors that were previously present have been succesfully
| ironed out. In short, source-code-wise the DCU is fully finished, although its
| functionality is yet to be proven.

44

## 600 References

[1] J. op den Brouw, M. Can. (2015, May). "Project Manual PRO-Q2 (ver-
| sion 1.3)" [Online]. Available: https://blackboard.hhs.nl/bbcswebdav/pid- 1650195-dt-content-rid-3258337_2/xid-3258337_2 [June 12, 2015]
[2] Multicomp. (2014, June). "Toroidal Transformers, General Purpose" [on-605 line]. Available: http://www.farnell.com/datasheets/182927 8.pdf [June 15, 2015]

45

## Appendix A

46

Table 3: Measurements of the preamplifier maximum attenuation
f (Hz) | Vin (mV) | Vout (mV) | Gain (dB)
2 | 90 | 12 | -17.50122527
3 | 89.8 | 13 | -16.78665969
5 | 90 | 13.1 | -16.73942428
7 | 90 | 12.5 | -17.14664993
10 | 90 | 12 | -17.50122527
25 | 90 | 9.5 | -19.53037808
50 | 90 | 9.3 | -19.71519122
75 | 90 | 9.5 | -19.53037808
100 | 90 | 9.8 | -19.26032867
200 | 90 | 11 | -18.25699649
300 | 90 | 12 | -17.50122527
400 | 90 | 13 | -16.80598314
500 | 90 | 13.5 | -16.47817482
750 | 90 | 14.2 | -16.0390833
1000 | 90 | 14.5 | -15.85749014
2000 | 90 | 13.4 | -16.54275422
2500 | 91 | 12.3 | -17.38272562
3000 | 91 | 12.2 | -17.45363123
5000 | 91 | 11 | -18.35297414
7500 | 91 | 10 | -19.18082785
9000 | 90.4 | 9.9 | -19.21066472
10000 | 91 | 9.8 | -19.35630633
25000 | 92 | 9.2 | -20
50000 | 91.5 | 9.7 | -19.4929872
100000 | 91.8 | 10.8 | -18.58837851
200000 | 92 | 11.2 | -18.29139609
300000 | 92 | 11 | -18.44790284
400000 | 92.2 | 10.2 | -19.12261499

47

Table 4: Measurements of the preamplifier maximum boost
f (Hz) | Vin (V) | Vout (V) | Gain (dB)
2 | 90 | 13.1 | -16.73942428
10 | 90 | 23.4 | -11.70053304
25 | 90 | 38.1 | -7.466350675
50 | 90 | 45.9 | -5.848596478
75 | 90 | 45.9 | -5.848596478
100 | 90 | 42.9 | -6.435704345
200 | 90 | 32.5 | -8.847182969
300 | 90 | 26.7 | -10.55462496
400 | 90 | 23.8 | -11.55331105
500 | 90 | 22.3 | -12.11875293
1000 | 90 | 20.4 | -12.89224684
2000 | 90 | 22.3 | -12.11875293
2500 | 90.5 | 24 | -11.52874675
3000 | 90.6 | 25.9 | -10.87656867
5000 | 91 | 33 | -8.810549049
7500 | 91 | 39.9 | -7.161369933
9000 | 90 | 43.1 | -6.395304786
10000 | 91 | 44.2 | -6.272382459
25000 | 92 | 44.3 | -6.347682022
50000 | 91.7 | 33.9 | -8.643392749
100000 | 92 | 22 | -12.42730293
200000 | 92 | 15.6 | -15.41326458
300000 | 92 | 13.2 | -16.86427792
400000 | 92.2 | 11.5 | -18.08066161

48

## Appendix B

The following pages show all C code involved used in the ATmega328 micro-
610 | controller to make the DCU function. The first two pages show the two .h files
| where several constants such as ports, pins, and MIDI-related values. Then, the
| main program file follows showing the main program loop and all used functions.

49

digipots.h
1 | /* TO-DO: fill in all correct values for everything. Also consider whether PORTs are
active high/low. */
2 | #ifndef DIGIPOTS_H
3 | | #define DDRDIGIPOTS DDRx | /* Data Direction Register for DigiPots */
4 | | #define PORTDIGIPOTS PORTx | /* Port for DigiPots */
5
6 | | #define DDRLEDS DDRx | /* Data Direction Register for LED(s) */
7 | | #define PORTLEDS PORTx | /* Port for LED(s) */
8
9 | | #define VOLUME_CS_PIN 0x00 | /* Pin for volume control CS */
10 | | #define BALANCE_CS_PIN 0x00 | /* Pin for balance control CS */
11 | | #define BASS_CUT_CS_PIN 0x00 | /* Pin for bass cut control CS */
12 | | #define TREBLE_CUT_CS_PIN 0x00 | /* Pin for treble cut control CS */
13 | | #define BASS_BOOST_CS_PIN 0x00 | /* Pin for bass boost control CS */
14 | | #define TREBLE_BOOST_CS_PIN 0x00 | /* Pin for treble boost control CS */
15
16 | | #define DIGIPOTVAL_PIN 0x00 | /* Pin for the value to be loaded into the
| DigiPot */
17 | #endif
18

-1-

midi.h
1 | /* TO-DO: fill in all correct values for CTRL numbers */
2 | #ifndef MIDI_H
3 | | #define CTRL_CH 0xB0 | /* Midi controller value change */
4
5 | | #define BALANCE_CTRL 0x00 | /* Control number of knob used for balance
| control */
6 | | #define BASS_CUT_CTRL 0x00 | /* Control number of knob used for bass cut
| control */
7 | | #define TREBLE_CUT_CTRL 0x00 | /* Control number of knob used for treble cut
| control */
8 | | #define BASS_BOOST_CTRL 0x00 | /* Control number of knob used for bass boost
| control */
9 | | #define TREBLE_BOOST_CTRL 0x00 | /* Control number of knob used for treble boost
| control */
10 | | #define VOLUME_CTRL 0x00 | /* Control number of knob used for volume
| control */
11 | #endif
12

-1-

dcu.c
1 | /* Filename: dcu.c
2 | * Authors: Kevin Oei, Koen van Vliet
3 | * For Pro-Q2
4 | * Description: Digital control unit firmware for speaker system
5 | * Status: -
6 | * Notes: | | - Check for MSB in parameters. If high: error condition
7 | * | | | | - Implement status LEDs
8 | */
9 | | 615
10 | | /* TO-DO: Set the DDRs correctly (optional), put the right memory address values in
| setPot(), use the right value in toggleErrorLED() */
11
12 | #include <avr/io.h>
13 | #include <stdio.h>
14 | #include <avr/interrupt.h>
15 | #include "midi.h"
16 | #include "digipots.h"
17 | #include "uart.c"
18
19
20 | #define SYSFREQ 16000000
21 | #define BAUDRATE 31250
22 | #define RATE SYSFREQ / (2*BAUDRATE) - 1
23 | #define RATE_L RATE%256
24 | #define RATE_H RATE/256
25
26
27 | char | | sb[64]; | | | | | | | | /* The buffer for the USART input. Incoming MIDI
messages are stored in here. */
28 | volatile | | char | | rxcnt | | = | | 0; | | | /* rxcnt is used when determining the offset, which is
used to pick the right index when reading sb */
29 | volatile | | char | | rxp | | = | | 0; | | | | /* rxp will loop from (decimal) 0 to 63, used in
determining the index of sb that needs to be approached */
30
31
32 | void | | uputc(char | | | | c);
33 | void | | uputs(char | | | | str[]);
34 | char | | ugetc();
35 | void | | spiSend(uint8_t | | | | memcom, | | | uint8_t | | data);
36 | void | | setPot(int | | | | potno, | | | uint8_t | | val);
37 | void | | toggleErrorLED(int | | | | onoff);
38
39
40 | int | | main(void) | | | | | {
41 | | int | | i;
42
43 | | /* Debug LEDs */
44 | | DDRB | | = | | 0xFF;
45 | | DDRDIGIPOTS | | = | | 0xFF;
46 | | DDRLEDS | | = | | 0xFF;
47 | | /* Setup serial comms (31250-8-n-1) NOTE: THIS IS FOR PC ONLY, HAVE TO FIX FOR
| ATmega */
48 | | UCSRA | | = | | 0x00;
49 | | UCSRB | | = | | 0x18 | | | | | (1<<7); | | | | /* Enable receiver & transmitter and RX complete
| interrupt enable */
50 | | UCSRC | | = | | 0x86; | | | /* STILL NEEDS TO BE ADJUSTED WHEN TO-BE-USED DEVICE IS
| KNOWN */

-1-

dcu.c
51 | | UBRRH | | = | | RATE_H;
52 | | UBRRL | | = | | RATE_L;
53
54 | | /* Setup SPI bus (f/2, mode0.0) */
55 | | SPSR | | = | | (1<<0); | | | | | | /* Double SPI speed enabled */
56 | | SPCR | | = | | (1<<7) | | | | | | | | | (1<<6) | | | | | | | | (1<<4); | | /* Enable SPI and interrupt, select master
| mode */
57
58 | | /* Reset digital potentiometers (255 is the max position) */
59 | | static | | uint8_t | | potpos[6] | | | | | = | | {255};
60 | | /* Connect terminals */
61 | | for | | (i | | | = | | 0; | | | i | | < | | sizeof(potpos); | | | | i++) | | {
62 | | | setPot(i,potpos[i]);
63 | | }
64
65
66 | | sei();
67
68 | | /* Main program loop */
69 | | while | | (1) | | | | {
70 | | | uint8_t | | cmd, | | | cc, | | | vv;
71 | | | char | | s[50]; | | | | | /* Is still being used anywhere? */
72 | | | while | | (rxcnt | | | == | | 0); | | | /* Wait for buffer to be empty */
73 | | | cmd | | = | | (uint8_t)ugetc();
74 | | | if | | (cmd | | | & | | 0x80) | | | { | | /* Check if 0b1xxxxxxx (valid MIDI command) */
75 | | | | toggleErrorLED(0); | | | | | /* Turn off error LED */
76 | | | | while | | (rxcnt | | | == | | 0);
77 | | | | cc | | = | | ugetc(); | | | /* Acquire controller number */
78 | | | | if | | (~cc | | | & | | 0x80) | | | { | | /* Check if 0b0xxxxxxx (valid controller number value)
| */
79 | | | | | while | | (rxcnt | | | == | | 0);
80 | | | | | vv | | = | | ugetc(); | | | /* Acquire controller value */
81 | | | | | if | | (~vv | | | & | | 0x80) | | | { | | /* Check if 0b0xxxxxxx (valid controller value) */
82 | | | | | | /* Check command type */
83 | | | | | | switch | | (cmd) | | | | {
84 | | | | | | | case | | CTRL_CH: | | | snprintf(s, | | | | | sizeof(s), | | | | "Controller %d = %d",
| cc, | | | vv);
85 | | | | | | | | | | | uputs(s);
86 | | | | | | | | | | | potpos[cc] | | | | | = | | vv;
87 | | | | | | | | | | | setPot(cc,potpos[cc]);
88 | | | | | | | | | | | break;
89 | | | | | | | /*case 'r': | | | for (i = 0; i < sizeof(potpos); i++) {
90 | | | | | | | | | | | | potpos[i] = 127;
91 | | | | | | | | | | | | setPot(i,potpos[i]);
92 | | | | | | | | | | | }
93 | | | | | | | | | | | break; */
94 | | | | | | | default: | | | | uputs("What?");
95 | | | | | | }
96 | | | | | }
97 | | | | | else | | {
98 | | | | | | toggleErrorLED(1); | | | | | /* Turn on error LED */
99 | | | | | } | | | | }
100 | | | | else | | {
101 | | | | | toggleErrorLED(1); | | | | | /* Turn on error LED */
102 | | | | }
103 | | | }
104 | | }

-2-

dcu.c
105 | | return | | 0;
106 | }
107
108 | /* The messages that are sent out are 16-bit long. SPI can only send 8-bit at one
time */
109 | /* Thus, two SPI transmissions are required for a full message to be sent */
110 | /* The message is as follows: AAAA.CCDD.DDDD.DDDD where A is memory address, C is
command and D is data. */
111 | /* See pg.47 of DigiPot datasheet */
112 | void | | spiSend(uint8_t | | | | memcom, | | | uint8_t | data) | | {
113 | | SPDR | | = | | memcom; | | | /* Transmit memory address and command */
114 | | while | | ((SPSR | | | & | | (1<<7)) | | | | == | | 0); | /* Wait for SPI transfer to finish. */
115 | | SPDR | | = | | data; | | | /* Transmit data (the value to be written to the
| DigiPot) */
116 | | while | | ((SPSR | | | & | | (1<<7)) | | | | == | | 0); | /* Wait for SPI transfer to finish. */
117 | }
118
119 | void | | setPot(int | | | | potno, | | | uint8_t | val) | | {
120 | | /* Select the CS of the correct IC. Note that a low signal will 'activate' the
| IC. */
121 | | /* ADDRESS MEMORY STILL NEEDS TO BE FILLED IN */
122 | | switch | | (potno) | | | | {
123 | | | case | | 0: | | | PORTDIGIPOTS | | = | VOLUME_CS_PIN;
124 | | | | | spiSend(0x00, | | | | | val);
125 | | | case | | 1: | | | PORTDIGIPOTS | | = | BALANCE_CS_PIN;
126 | | | | | spiSend(0x00, | | | | | val);
127 | | | case | | 2: | | | PORTDIGIPOTS | | = | BASS_CUT_CS_PIN;
128 | | | | | spiSend(0x00, | | | | | val);
129 | | | case | | 3: | | | PORTDIGIPOTS | | = | TREBLE_CUT_CS_PIN;
130 | | | | | spiSend(0x00, | | | | | val);
131 | | | case | | 4: | | | PORTDIGIPOTS | | = | BASS_BOOST_CS_PIN;
132 | | | | | spiSend(0x00, | | | | | val);
133 | | | case | | 5: | | | PORTDIGIPOTS | | = | TREBLE_BOOST_CS_PIN;
134 | | | | | spiSend(0x00, | | | | | val);
135 | | | default: | | | uputs("Invalid potmeter ID selected.");
136 | | }
137 | | PORTB | | = | | ~(1<<potno);
138
139 | }
140
141 | void | | toggleErrorLED(int | | | | onoff) | | | {
142 | | if | | (onoff | | | = | | 0) | | {
143 | | | PORTLEDS | | = | | 0x00; | | | /* Toggle error LED. CORRECT VALUE TO-BE-FILLED-IN */
144 | | }
145 | | else | | {
146 | | | PORTLEDS | | = | | 0xFF; | | | /* Toggle error LED. CORRECT VALUE TO-BE-FILLED-IN */
147 | | }
148
149 | }
150
151 | ISR | | (USART_RXC_vect) | | | | {
152 | | char | | c;
153 | | if | | (UCSRA | | | & | | (1<<FE | | | | | | 1<<DOR | | | | 1<<PE)) | {
154 | | | c | | = | | UDR;
155 | | | uputc('?');
156 | | }
157 | | else | | {

-3-

dcu.c
158 | | | c | | = | | UDR;
159 | | | /*PORTB = ~c;*/
160 | | | if | | (rxcnt | | | < | | 64) | | | {
161 | | | | sb[rxp | | | | & | | 63] | | | = | | c;
162 | | | | rxp | | = | | (rxp | | | + | | 1) | | | & | | 63;
163 | | | | rxcnt++;
164 | | | }
165 | | | else | | {
166 | | | | uputc('!');
167 | | | }
168 | | }
169 | }
170
171 | /* Temporary function for PC debugging */
172 | void | | uputc(char | | | | c) | | | {
173 | | while | | (~UCSRA | | | & | | 1<<UDRE);
174 | | UDR | | = | | c;
175 | }
176
177 | /* Temporary function for PC debugging */
178 | void | | uputs(char | | | | str[]) | | | {
179 | | int | | i;
180 | | for | | (i | | | = | | 0; | | | str[i] | | | | | != | | '\0'; | i++) | {
181 | | | uputc(str[i] | | | | | | | | | | 0x80); | | | | /* | 0x80 is debug code*/
182 | | }
183 | }
184
185 | char | | ugetc() | | | {
186 | | char | | c;
187 | | int | | offset;
188 | | offset | | = | | (rxp | | | - | | rxcnt) | | | & | | 63;
189 | | c | | = | | sb[offset];
190 | | rxcnt--;
191 | | return | | c;
192 | }
193
194
195

-4-
