13093053/barfmachine/products/calculation_report/1_monolithic_power_amplifier/monolithic_power_amplifier.pdf

## Calculation Report: Monolithic Power Amplifier PRO-Q2

Daan Conijn, 13023217
Andrew Lau, 13058339
Kevin Oei,13090062
Koen van Vliet, 13093053
Group 1

EQ2.a
EQ2.c

April 23rd, 2015

5 | 1 | Introduction

In this calculation report, the monolithic power amplifier is determined and calculated.

2

## 2 Monolithic Power Amplifier

### 2.1 Requirements

10 | The power amplifier has the following specifications:
| • Input impedance of at least 50kΩ • Output power: 15W sine in Rload = 8Ω at 1kHz • Frequency range: 10Hz to 100kHz (−3 dB) at Pload = 0.5W in 8Ω

### 2.2 Chosen Power Amplifier

15 | For the power amplifier, the LM1875 (Farnell-code: 1468913) was chosen. This
| specific power amplifier has been chosen because the LM1875 meets the specified
| requirements. The amplifier is also designed to suppress low-frequency noise
| such as the 50Hz hum originating from the mains, as seen in figure 7 of the
| datasheet. This is an important property when it comes to the performance of
20 | audio amplifiers.

### 2.3 Calculations

Since the LM1875 is used as an inverting amplifier, the impedance Zin will be equal to R1 as depicted in the following diagram.

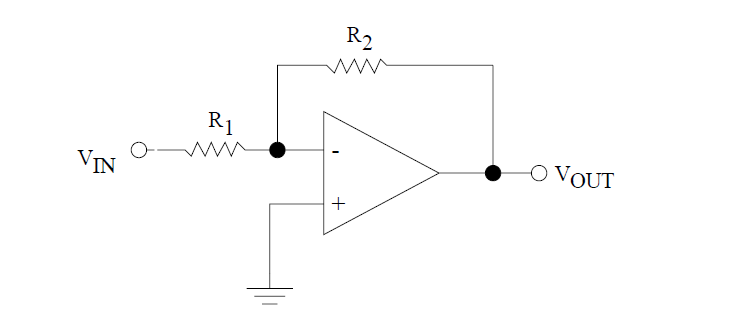
[picture p29: figure]

Figure 1: Inverting amplifier diagram

3

Zin is required to be at least 50kΩ. Thus, the chosen value of R1will have to be 25 at least 50kΩ in order to meet the specified requirement.

For determining the maximum output voltage and current, it is assumed the amplifier drives an 8Ω load at 15W.

The formula for the power equals to:

P = U · I | (1)

Therefore the following formulas can be derived:

UOUT,eff =

√
P · R =

√
15 · 8 = 11V | (2)

UOUT,max = UOUT,eff ·

√
2 = 15.556V | (3)

IOUT,eff =

r
P
R

=

r
15
8
= 1.37A | (4)

IOUT,max = IOUT,eff ·

√
2 = 1.94A | (5)
30 | The amplifier has a bandwidth of 70kHz at 20W output power. However, the
desired dynamic range of 10Hz to 100kHz can be easily achieved at lower power outputs. No additional calculations need to be done for the power amplifier in order to realize a frequency range of 10Hz to 100kHz. The dynamic range can be controlled through software since the filters on the preamplifier are controlled 35 by the digital control unit. According to the datasheet from LM1875 [1] the supply voltage needs to be approximately ±18V to accomodate to the 15W output power.

With this information, the voltage gain can be determined by using the following formula:

A =

Uout

Uin

(6)

40 | Since Uout = Uout,max = 15,556V and Uin = 18V (the voltage delivered by the supply), the gain will be 15,556 18 ≈ 0.864. Expressed in decibels, this is equal to 20 · log( ¹⁵,556 18 ) ≈ −1.27dB.
| 4

It is now possible to deduce the output impedance Zout by using the following equation:

Uout

Uin

=

Zout

Zin

(7)

45 Filling in the known values, Zout can be determined as follows:

15, 556
18

=

Zout
50 · 10³

=⇒ Zout = 50 · 10³
·

15, 556
18
≈ 43211Ω | (8)

5

## References

[1] Texas Instruments. (2004, May). “LM1875 20W Audio Power Amplifier” [online]. Available: http://www.farnell.com/datasheets/1703151.pdf [April 3, 2015].

6
