13093053/barfmachine/products/calculation_report/2_heat_sink_power_amplifier/heat_sink_power_amplifier_v2.pdf

## Calculation Report: Heat Sink Power Amplifier PRO-Q2

Daan Conijn, 13023217
Andrew Lau, 13058339
Kevin Oei,13090062
Koen van Vliet, 13093053
Group 1

EQ2.a
EQ2.c

April 23rd, 2015

5 | 1 | Introduction

In this calculation report the heat sink of the selected monolithic power amplifier is determined and calculated.

2

## 2 Calculation: Heat Sink Power Amplifier

The power amplifier that is chosen for the active loudspeaker is LM1875 (Farnell-10 code: 1468913).

Fig. 1 gives insight on how the heat sink and power amplifier will look like when
| connected with each other.

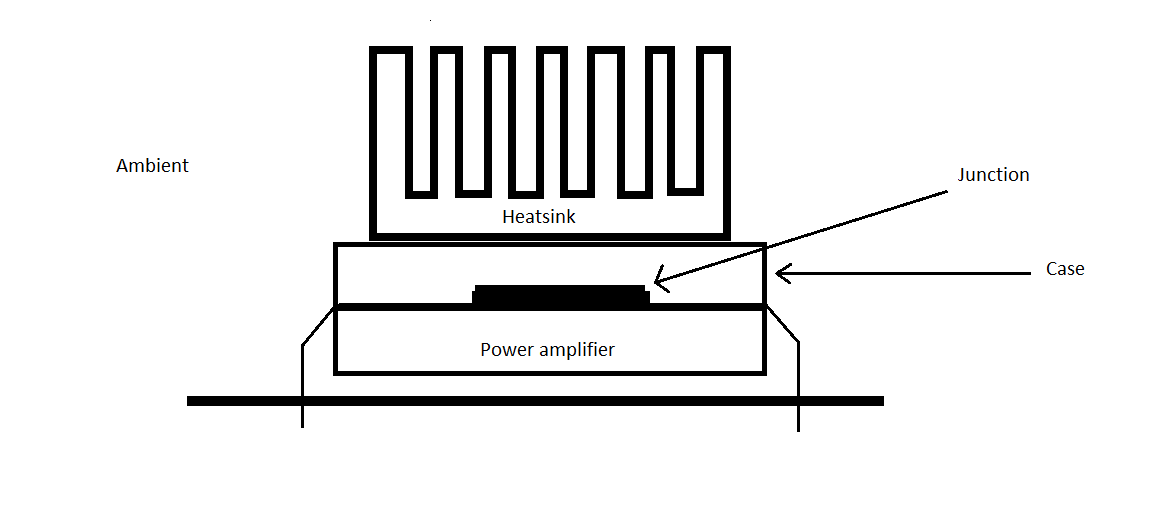
[picture p30: figure]

Figure 1: A sketch of the heat sink and power amplifier together

Imagine that the maximum junction temperature of the power amplifier can reach up to 150°C and that the ambient temperature goes up to 25°C. The 15 power dissipation for an 18V power supply and an output power of 15W is equal to 10W. The power dissipation can be found in a graph called “Power Dissipation vs Power Output” in the datasheet of LM1875. The total junction-to-ambient thermal resistance must be less than[1]:

θja =

TJMAX − TAMB
PQ

=

150 − 25
10
= 12, 5000ºC/W | (1)
- TJMAXis the maximum junction temperature that the power amplifier can
20 | handle before overheating and shutting down.
- TAMBis the ambient temperature of the power amplifier.
- PQ is the quiescent power dissipation of the power amplifier.

The thermal resistance of a metal-metal interface when dry is equal to:

θmetal−to−metal = 1, 2ºC/W | (2)

3

The thermal resistance of the heat sink is equal to:

θheatsink = θja − θmetal−to−metal = 12, 5ºC/W − 1, 2ºC/W = 11, 3ºC/W (3)

25 | To check whether the calculations are correct, the temperature of the junction
| is determined as a result of the thermal resistance.
| The formula used to calculate the maximum average power of the power ampli-
| fier, LM1875, is found in the datasheet. The maximum average power that the
| power amplifier will be required to dissipate before overheating is approximately
30 | [1]:

PdMAX =

V

2
S
2π

2RL

+ PQ =

18²
2π

2 · 8

+ 10 ≈ 12.05W | (4)
- VS is the total power supply voltage across the power amplifier.
- RL is the load resistance.
- PQ is the quiescent power dissipation of the amplifier. The power dissipation can be found in a graph called “Power Dissipation vs Power Output”
35 | in the datasheet of the LM1875.
PQ = 10W | (5)

The new maximum junction temperature is:

TJMAX = PdMAX · θja = 12, 05 · 12, 5 = 150, 625ºC | (6)

150.625°C is slightly higher than 150°C and therefore the new junction-to-ambient thermal resistance equals to:

θja =

150, 625 − 25
10
= 12, 5625ºC/W | (7)

The new θja (12.5625°C/W) is approximately equal to 12.5000°C/W, which
40 | means that the calculations of the heat sink meets the required specifications.
| Therefore the new thermal resistance of the heat sink is equal to:

θheatsink = θja − θmetal−to−metal = 12.5625ºC/W − 1, 2ºC/W = 11.3625ºC/W (8)

4

A heat sink with a thermal resistance lower than 11.3625ºC/W must be used in order for the power amplifier, LM1875, to function properly without overheating and shutting down. The heat sink that is chosen for the power amplifier is
45 | FISCHER ELEKTRONIK SK 129 50,8 STS (Farnell-code: 1319813). It is
| chosen for this heat sink because the thermal resistance of this heat sink is
| 5,3ºC/W, which is lower than 11.3625ºC/W.

5

## References

[1] Texas Instruments. (2004, May). “LM1875 20W Audio Power Amplifier” 50 [online]. Available: http://www.farnell.com/datasheets/1703151.pdf [April 3, 2015].

6
