13093053/barfmachine/products/calculation_report/3_power_supply_newest/power_supply.pdf

## Calculation Report: Power Supply PRO-Q2

Daan Conijn, 13023217
Andrew Lau, 13058339
Kevin Oei,13090062
Koen van Vliet, 13093053
Group 1

EQ2.a
EQ2.c

April 23rd, 2015

5 | 1 | Introduction

In this calculation report a transformer is selected and the efficiency of the power supply is determined.

2

## 2 Power supply

### 2.1 Requirements

10 | The power supply has the following specifications:
| • Input: 230V AC • Output: 2x 18V DC (25W), 2x 15V DC, 1x 5V DC • Regulator type: Linear • Energy efficiency: 80% or higher
15 | 2.2 | Power supply design

The power amplifier needs a supply of ±18V DC. To accomodate for this the power supply will consist of a power transformer with one primary winding and two secondary windings. After the transformer comes a bridge rectifier which converts the AC signal to DC. Then finally the signal will pass through several 20 filter capacitors to smooth out the voltage. Optionally an inductor can be used in-between the filter capacitors and the bridge rectifier to reduce the inrush current.

The preamplifier will run off ±15V DC which is provided by a regulator stage after the power supply. The same thing goes for the digital systems which will 25 run off 5V DC.

### 2.3 Calculations

### 2.3.1 Power transformer

The winding turn ratio between the primary and the secondary windings of the transformer is equal to the voltage ratio.

Up
Us

=

Np
Ns

(1)

30 The primary voltage is 230V and the secondary voltage is 18V.

3

Np
Ns

=

230
18

(2)

The transformer current per secondary winding is equal to:

I =

P
2U

=

25
36
= 0.694A | (3)

### 2.3.2 Power efficiency

The energy efficiency of the power supply needs to be 80% or more. The 0.7V voltage drop of the bridge rectifier makes the power supply about 4% less effi-35 cient.

η =

19 − 0.7
19
= 0.96 | (4)

There will also be energy loss in the power transformer. The power transformer we chose is 87% efficient[2].

The linear regulators used to power the preamplifier and the digital systems are very inefficient, but since these parts of the audio system consume very little 40 energy compared to the power amplifier, the loss is neglectable. The power amplifier’s power is not regulated.

ηtotal = 0.87 · 0.96 = 0.8352 | (5)

The overall efficiency of the power supply is about 84%.

### 2.4 Selection of power transformer

A toroidal power transformer was chosen because it is more efficient than tra-45 ditional transformers. The primary voltage is 230V and the secondary voltages are both 18V.

This transformer meets the specifications[2]:

- Multicomp MCTA050/18 (Farnell code: 9530380)

The nominal current of the secondary windings of this transformer is equal to 50 0.420A while the power amplifier drains 0.694A from the supply at max power. The capacitors in the power supply will smooth out the load on the transformer so it does not exceed the nominal current.

4

## References

[1] Texas Instruments. (2004, May). “LM1875 20W Audio Power Amplifier” 55 [online]. Available: http://www.farnell.com/datasheets/1703151.pdf [April 3, 2015].
[2] Multicomp. (2014, June). “Toroidal Transformers, General Purpose” [on-
| line]. Available: http://www.farnell.com/datasheets/1829278.pdf [April 15, 2015]

5
