13093053/barfmachine/products/calculation_report/CalcReportsAssessmentFeedback.pdf

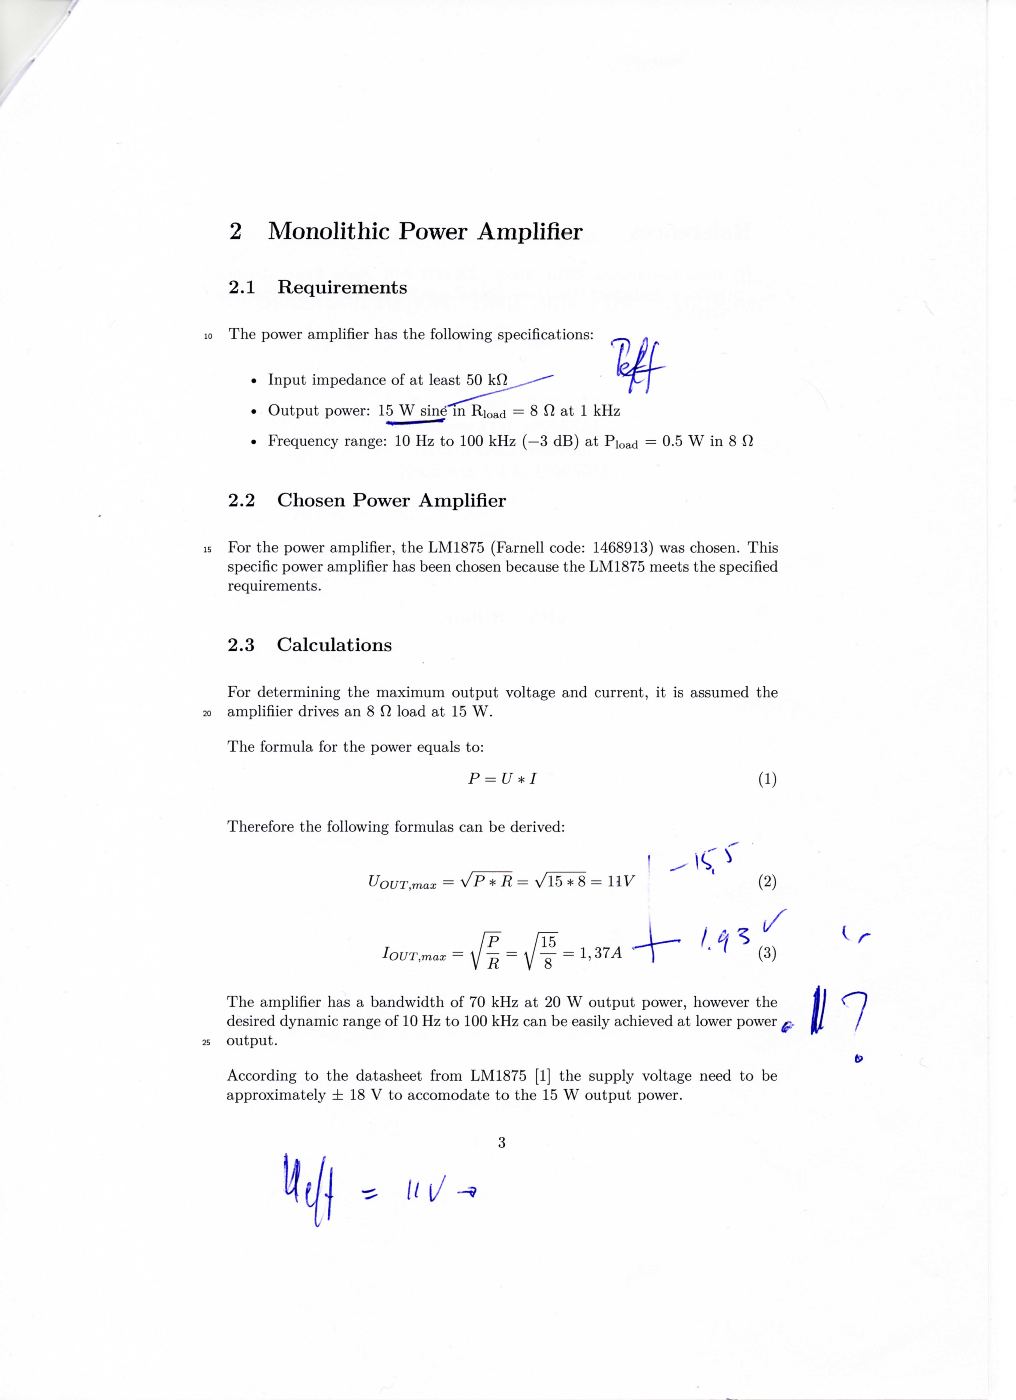
[picture p34: page 1]
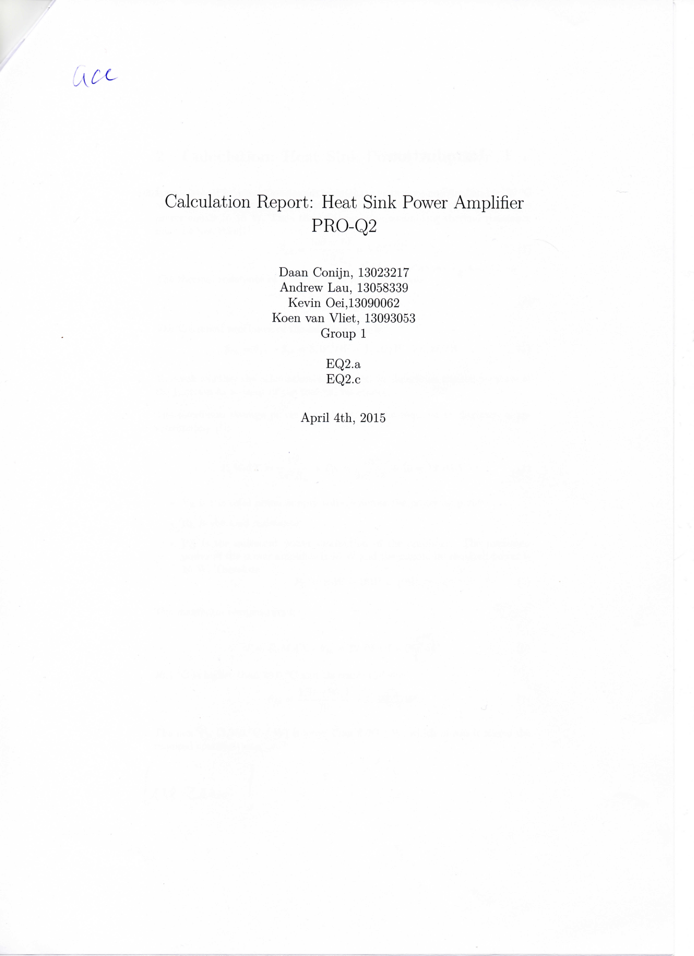
[picture p35: page 2]
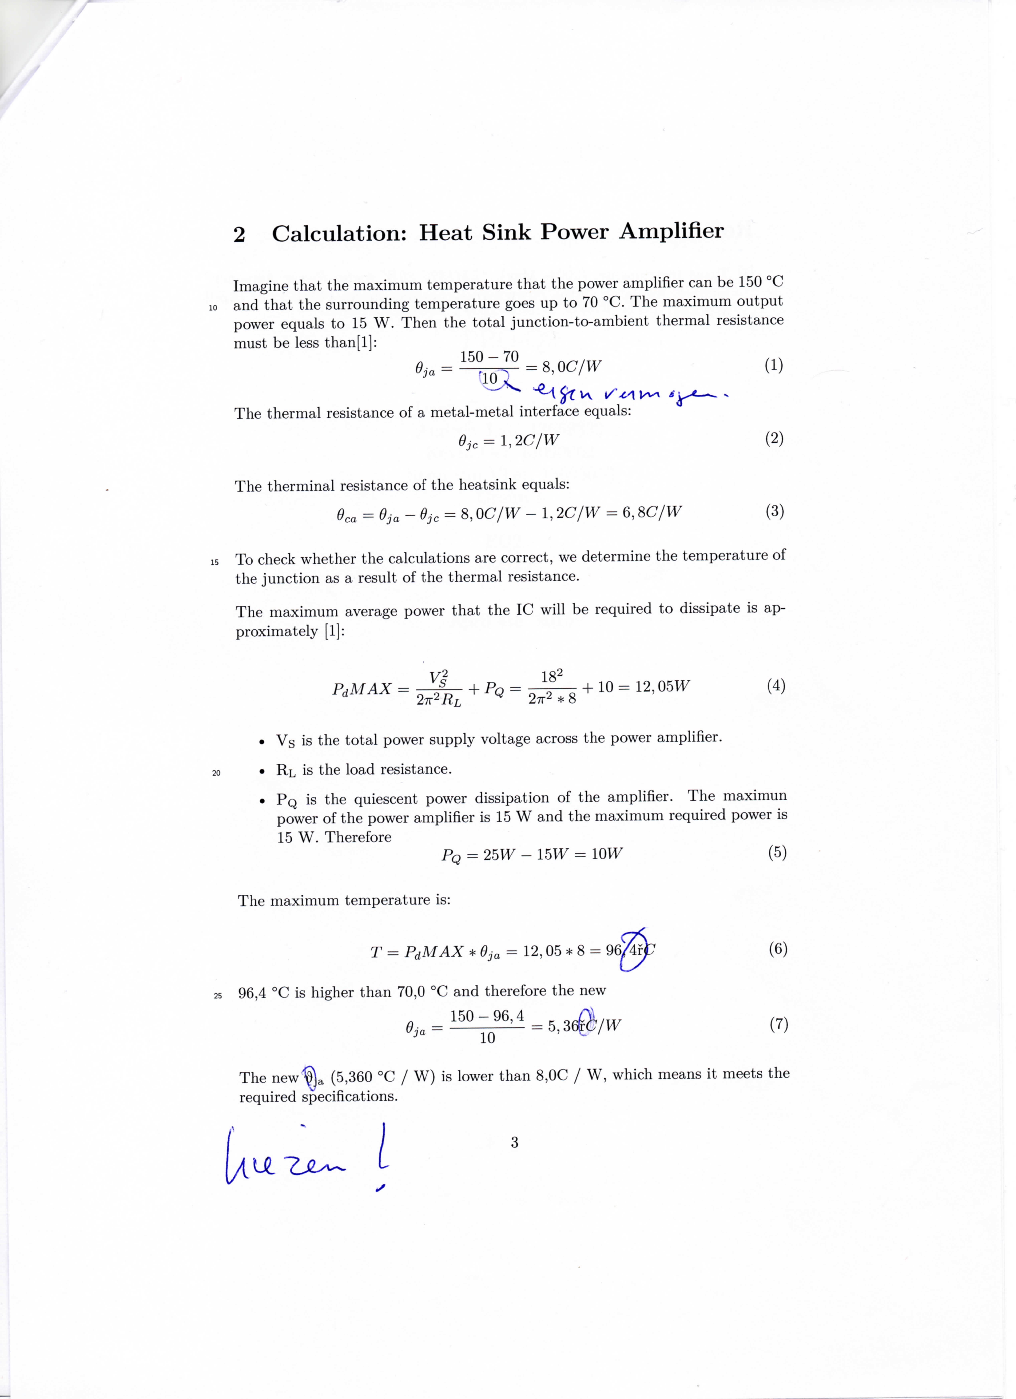
[picture p36: page 3]
