13093053/barfmachine/products/calculation_report/2_heat_sink_power_amplifier/heat_sink_power_amplifier.pdf

## Calculation Report: Heat Sink Power Amplifier PRO-Q2

Daan Conijn, 13023217
Andrew Lau, 13058339
Kevin Oei,13090062
Koen van Vliet, 13093053
Group 1

EQ2.a
EQ2.c

April 4th, 2015

5 | 1 | Introduction

In this calculation report the heat sink of the selected monolithic power amplifier is calculated.

2

## 2 Calculation: Heat Sink Power Amplifier

Imagine that the maximum temperature that the power amplifier can be 150 °C 10 and that the surrounding temperature goes up to 70 °C. The maximum output power equals to 15 W. Then the total junction-to-ambient thermal resistance must be less than[1]:

θja =

150 − 70
10
= 8, 0C/W | (1)

The thermal resistance of a metal-metal interface equals:

θjc = 1, 2C/W | (2)

The therminal resistance of the heatsink equals:

θca = θja − θjc = 8, 0C/W − 1, 2C/W = 6, 8C/W | (3)
15 | To check whether the calculations are correct, we determine the temperature of
the junction as a result of the thermal resistance.

The maximum average power that the IC will be required to dissipate is approximately [1]:

PdMAX =

V

2
S
2π

2RL

+ PQ =

18²
2π

2 ∗ 8

+ 10 = 12, 05W | (4)
- VS is the total power supply voltage across the power amplifier.

20 • RL is the load resistance.

- PQ is the quiescent power dissipation of the amplifier. The maximun power of the power amplifier is 15 W and the maximum required power is 15 W. Therefore
PQ = 25W − 15W = 10W | (5)

The maximum temperature is:

T = PdMAX ∗ θja = 12, 05 ∗ 8 = 96, 4řC | (6)
25 | 96,4 °C is higher than 70,0 °C and therefore the new

θja =

150 − 96, 4
10
= 5, 36řC/W | (7)

The new θja (5,360 °C / W) is lower than 8,0C / W, which means it meets the required specifications.

3

## References

[1] Texas Instruments. (2004, May). “LM1875 20W Audio Power Amplifier” 30 [online]. Available: http://www.farnell.com/datasheets/1703151.pdf [April 3, 2015].

4
