13093053/barfmachine/organisation/cooperation_agreement/coverimage.png

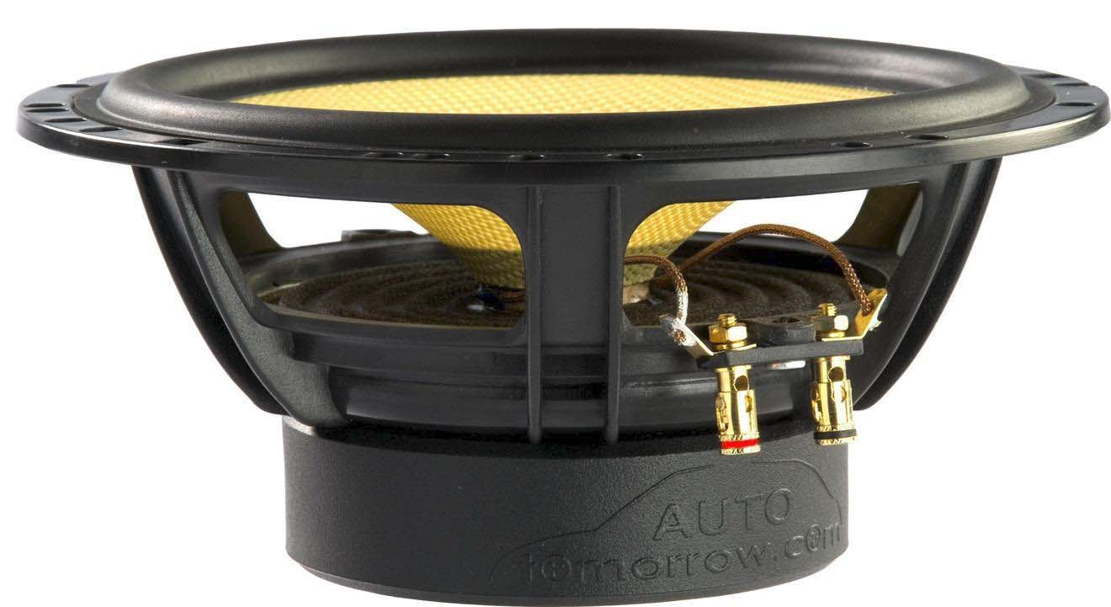
organisation/cooperation_agreement/coverimage.png
