13093053/barfmachine/products/assignments/project_management_week_2_PBS-documents.png

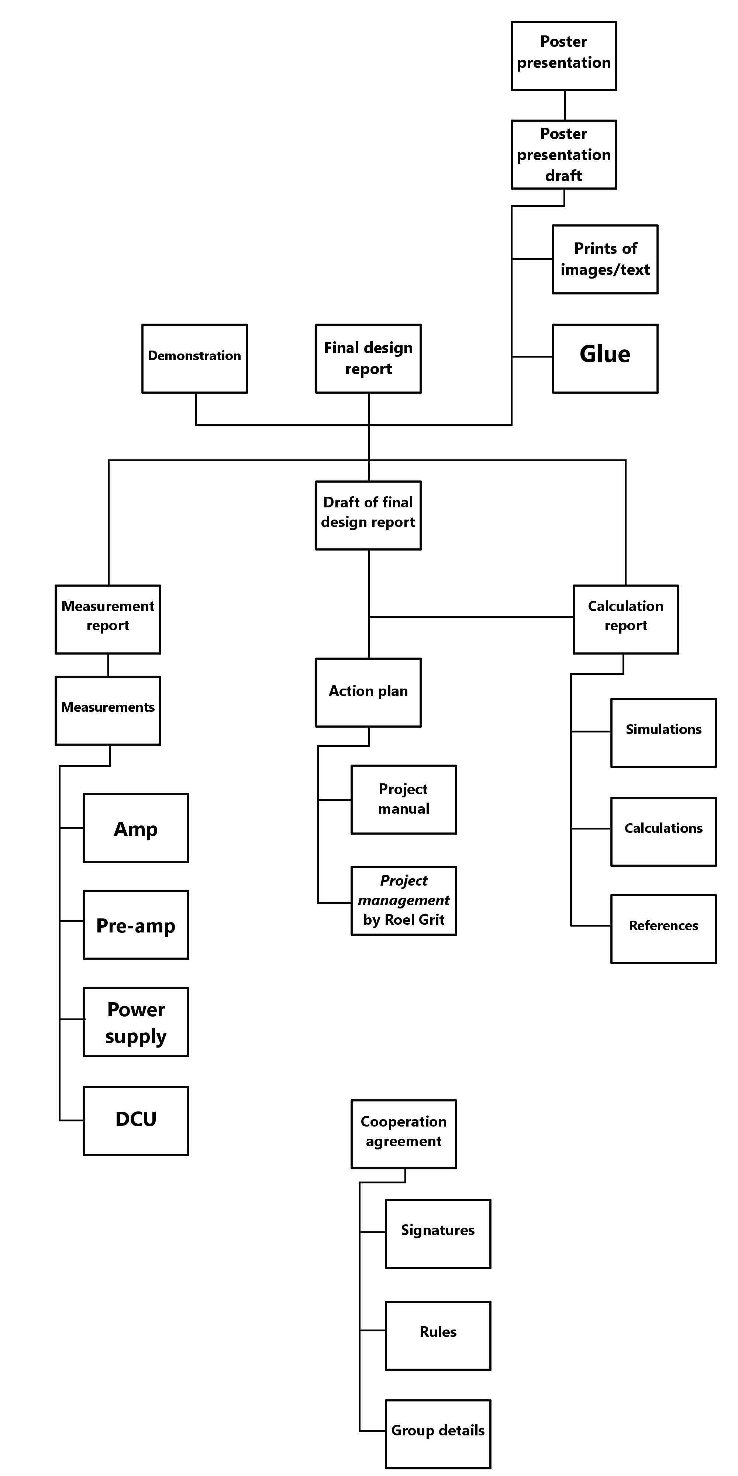
products/assignments/project_management_week_2_PBS-documents.png
