13093053/barfmachine/products/assignments/project_management_week_2_PBS-speaker.jpeg

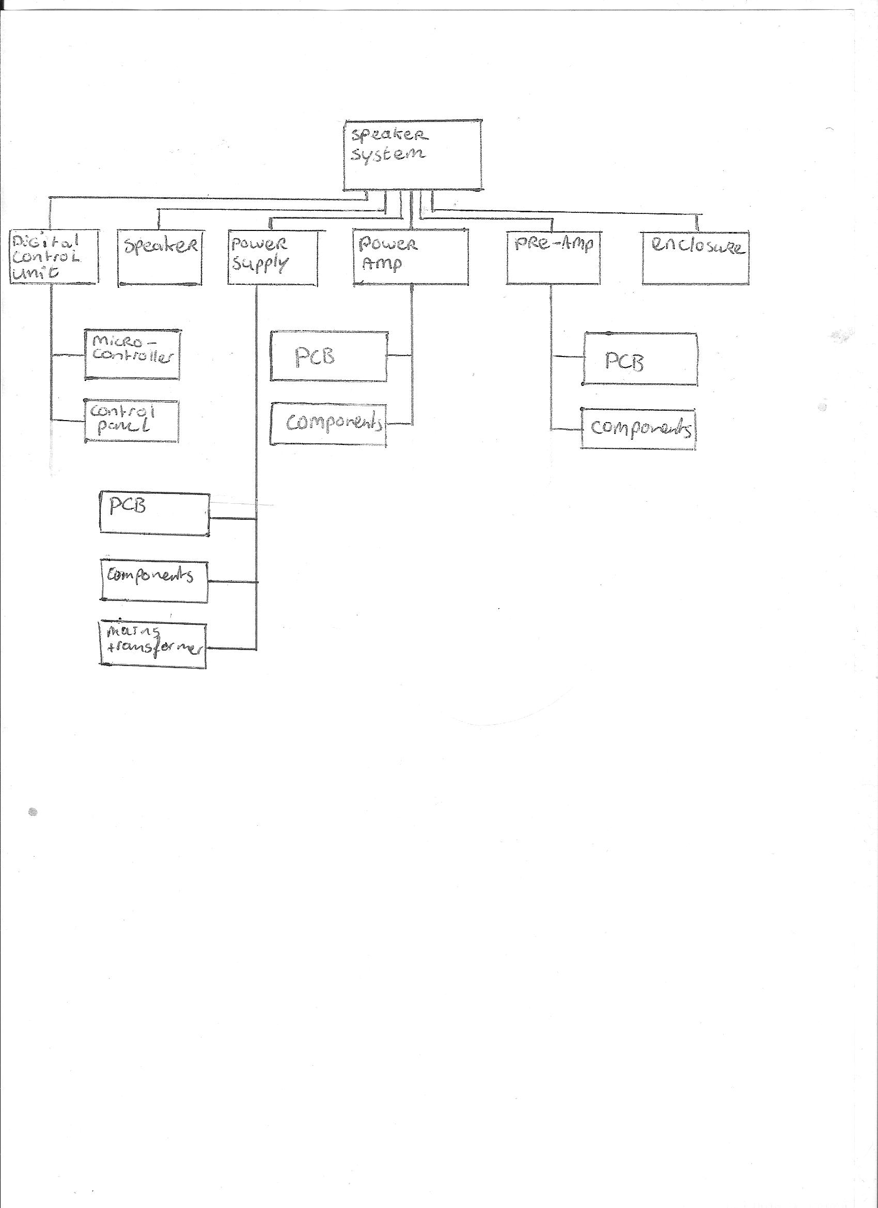
products/assignments/project_management_week_2_PBS-speaker.jpeg
