13093053/barfmachine/products/calculation_report/3_power_supply - Copy/psu.png

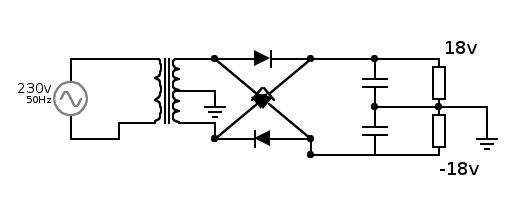
products/calculation_report/3_power_supply - Copy/psu.png
