13093053/barfmachine/products/final_design_report/block_diagram_DCU.png

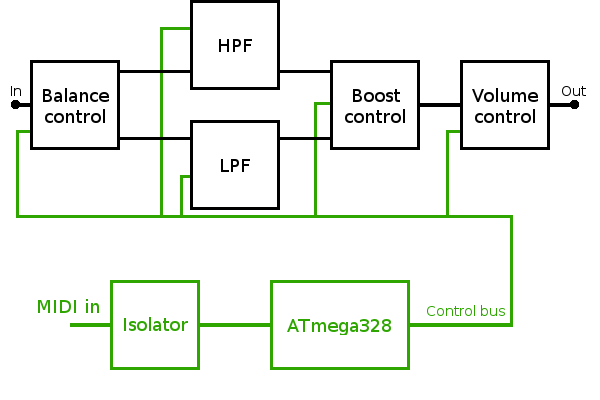
products/final_design_report/block_diagram_DCU.png
