13093053/barfmachine/products/final_design_report/design_preamplifier.png

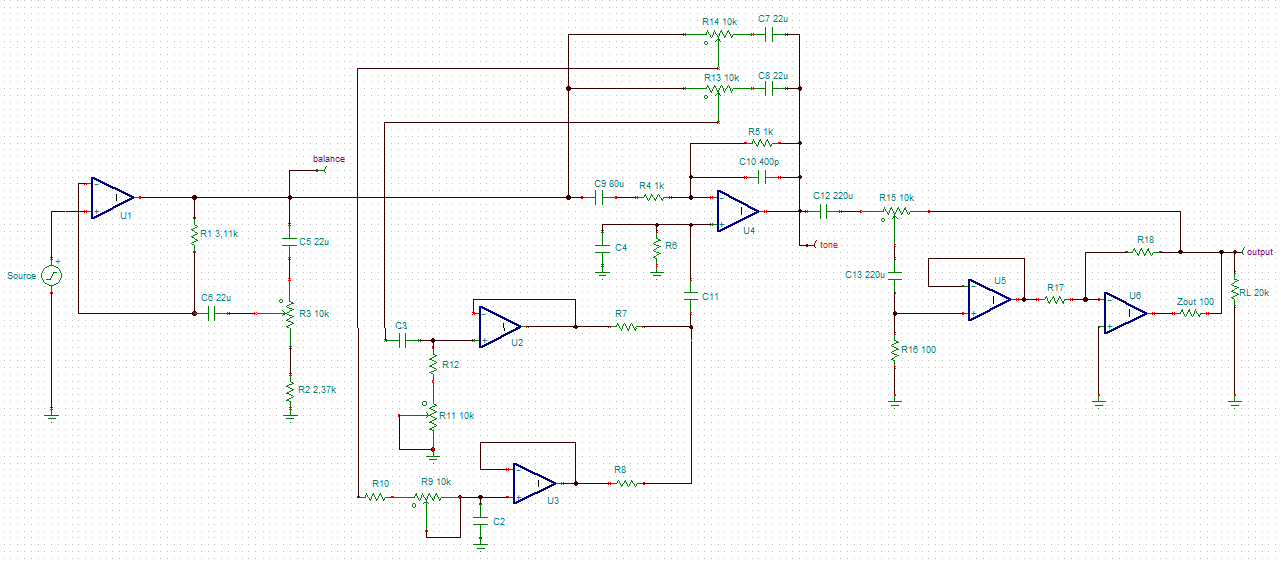
products/final_design_report/design_preamplifier.png
