13093053/barfmachine/products/final_design_report/example_bypass_capacitor.jpg

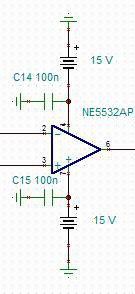
products/final_design_report/example_bypass_capacitor.jpg
