13093053/barfmachine/products/final_design_report/speaker_system.png

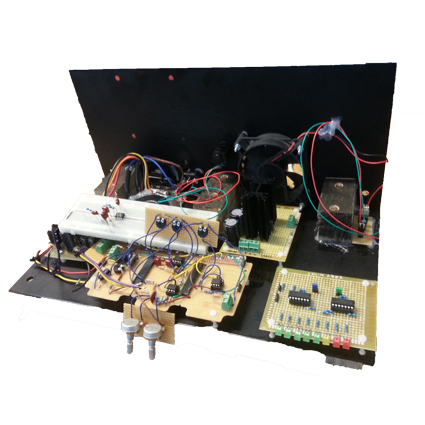
products/final_design_report/speaker_system.png
