13093053/barfmachine/products/measurement_reports/balance_control/design/balance_control_circuit_board.jpg

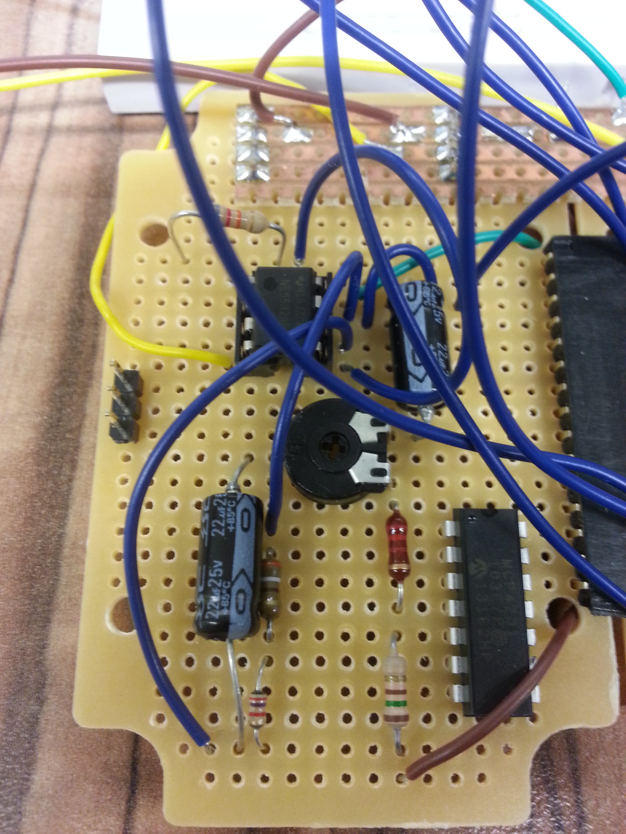
products/measurement_reports/balance_control/design/balance_control_circuit_board.jpg
