13093053/barfmachine/products/measurement_reports/power_amplifier/design/photo_2015-05-29_23-47-17.jpg

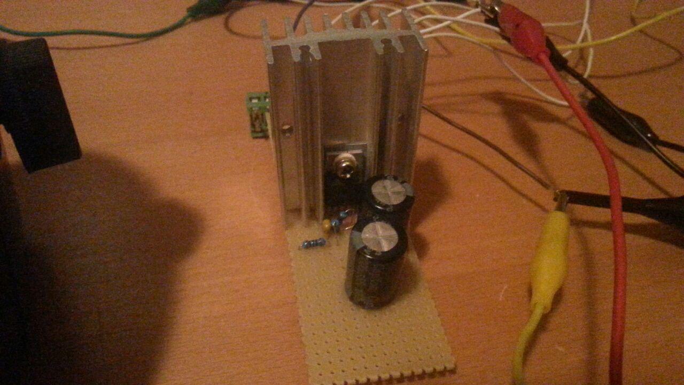
products/measurement_reports/power_amplifier/design/photo_2015-05-29_23-47-17.jpg
