13093053/barfmachine/products/measurement_reports/tone_control/design/bass_and_treble.png

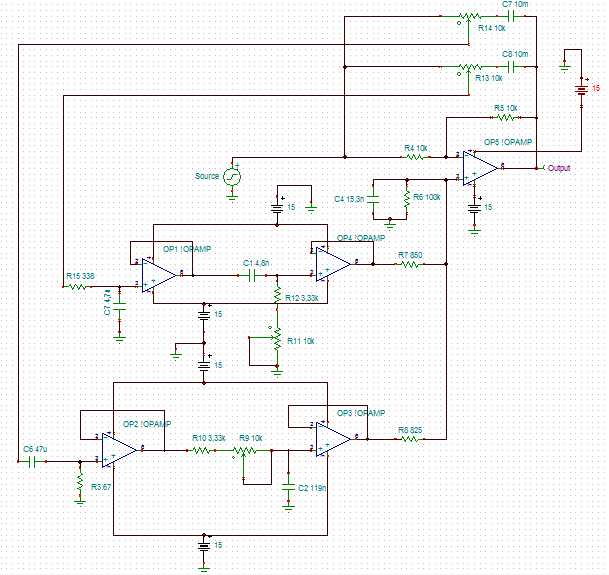
products/measurement_reports/tone_control/design/bass_and_treble.png
