13093053/barfmachine/products/measurement_reports/tone_control/design/design_bandpassfilter.png

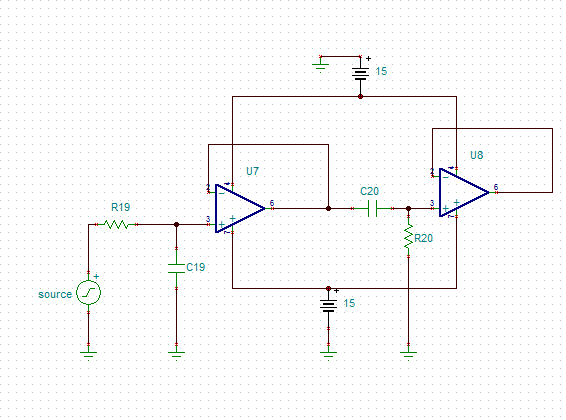
products/measurement_reports/tone_control/design/design_bandpassfilter.png
