13093053/barfmachine/products/measurement_reports/tone_control/design/tone_control_circuit_board.jpg

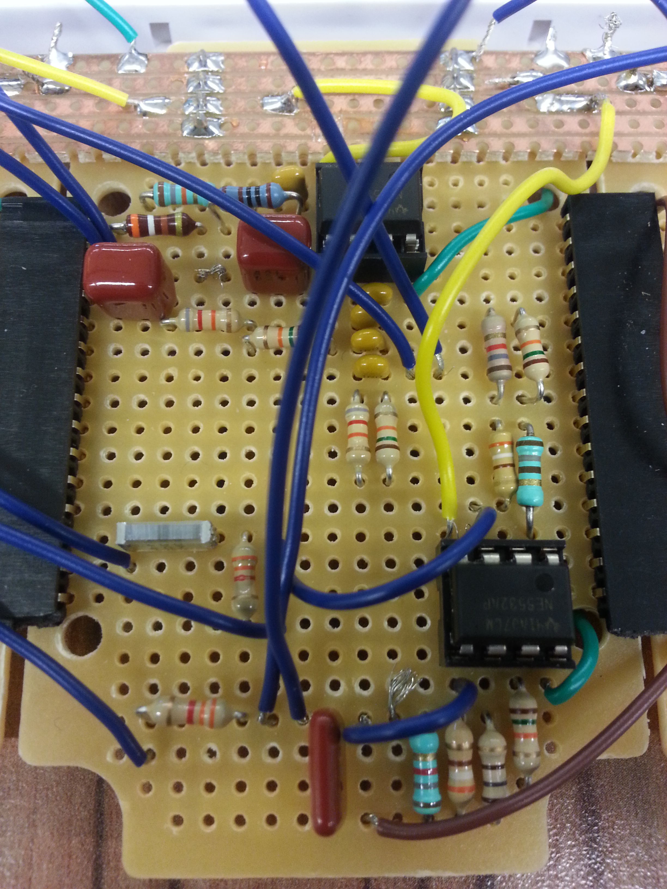
products/measurement_reports/tone_control/design/tone_control_circuit_board.jpg
