13093053/barfmachine/products/measurement_reports/volume_control/design/design_volume_control_circuit_board.jpg

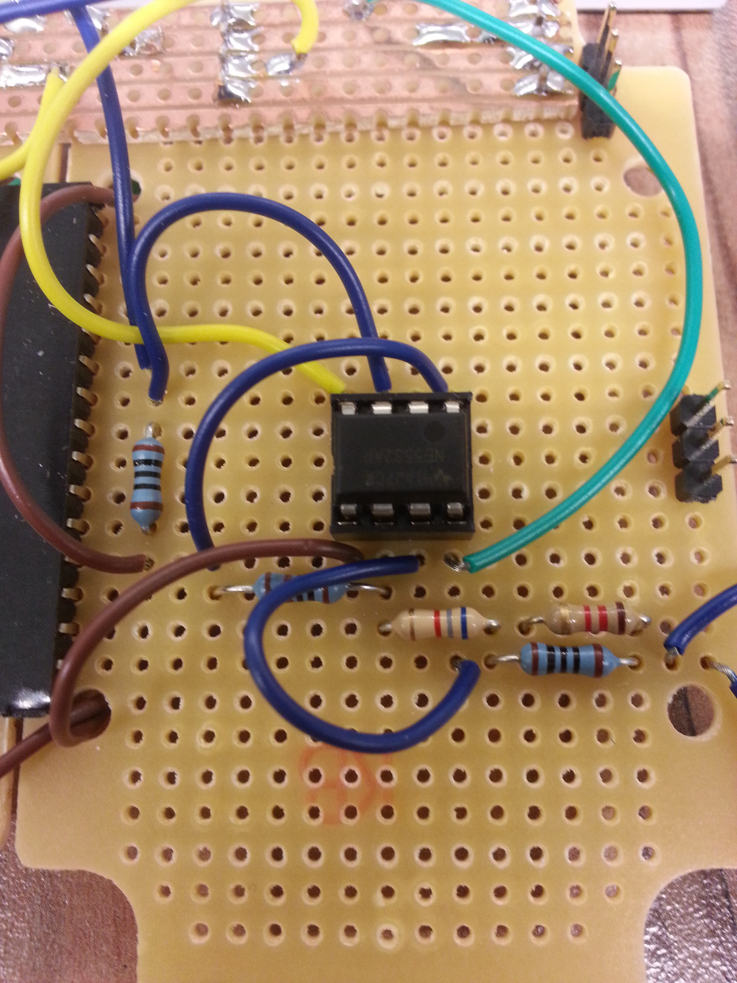
products/measurement_reports/volume_control/design/design_volume_control_circuit_board.jpg
