13093053/barfmachine/products/poster_presentation/20150604_133226.jpg

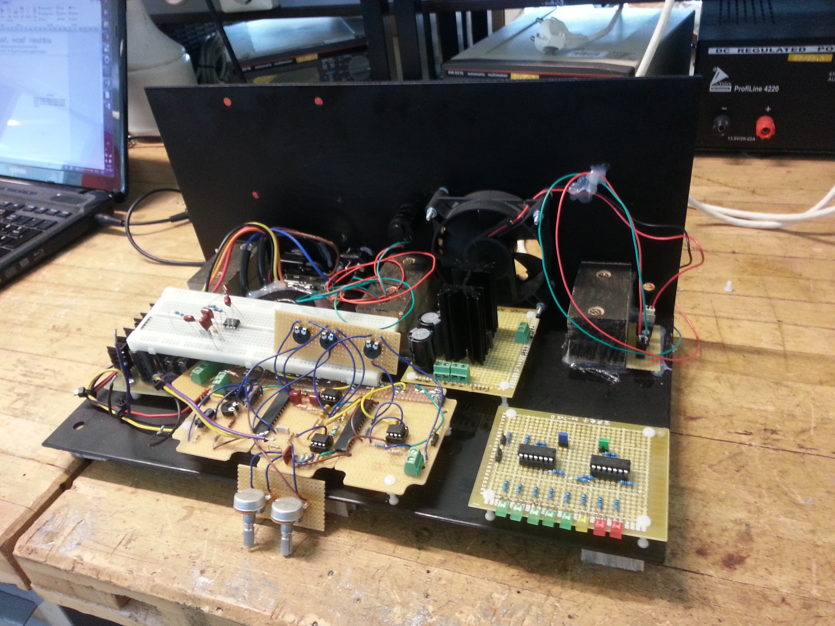
products/poster_presentation/20150604_133226.jpg
