13093053/barfmachine/products/poster_presentation/barkposter-idea-blanco.jpg

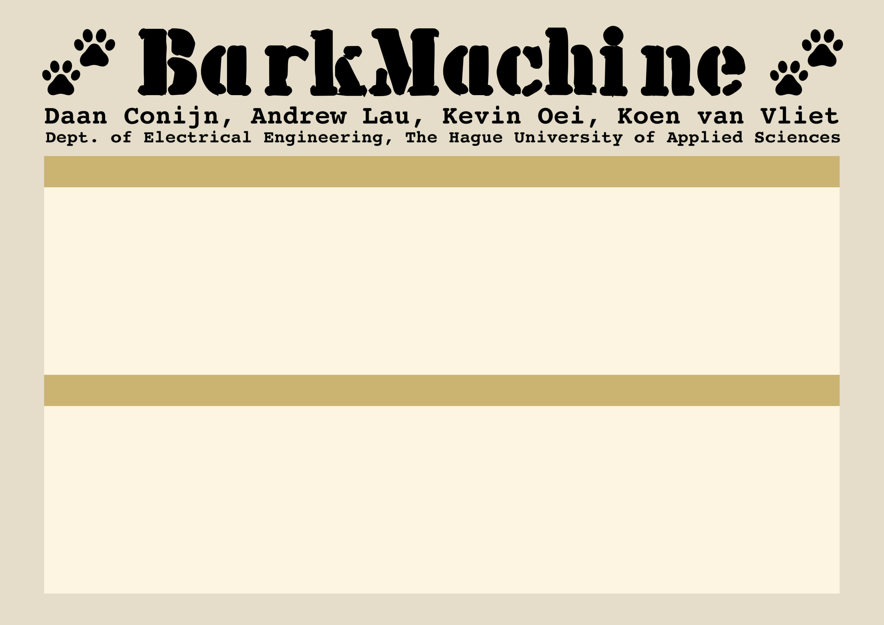
products/poster_presentation/barkposter-idea-blanco.jpg
