13093053/barfmachine/products/poster_presentation/barkposter-idea.jpg

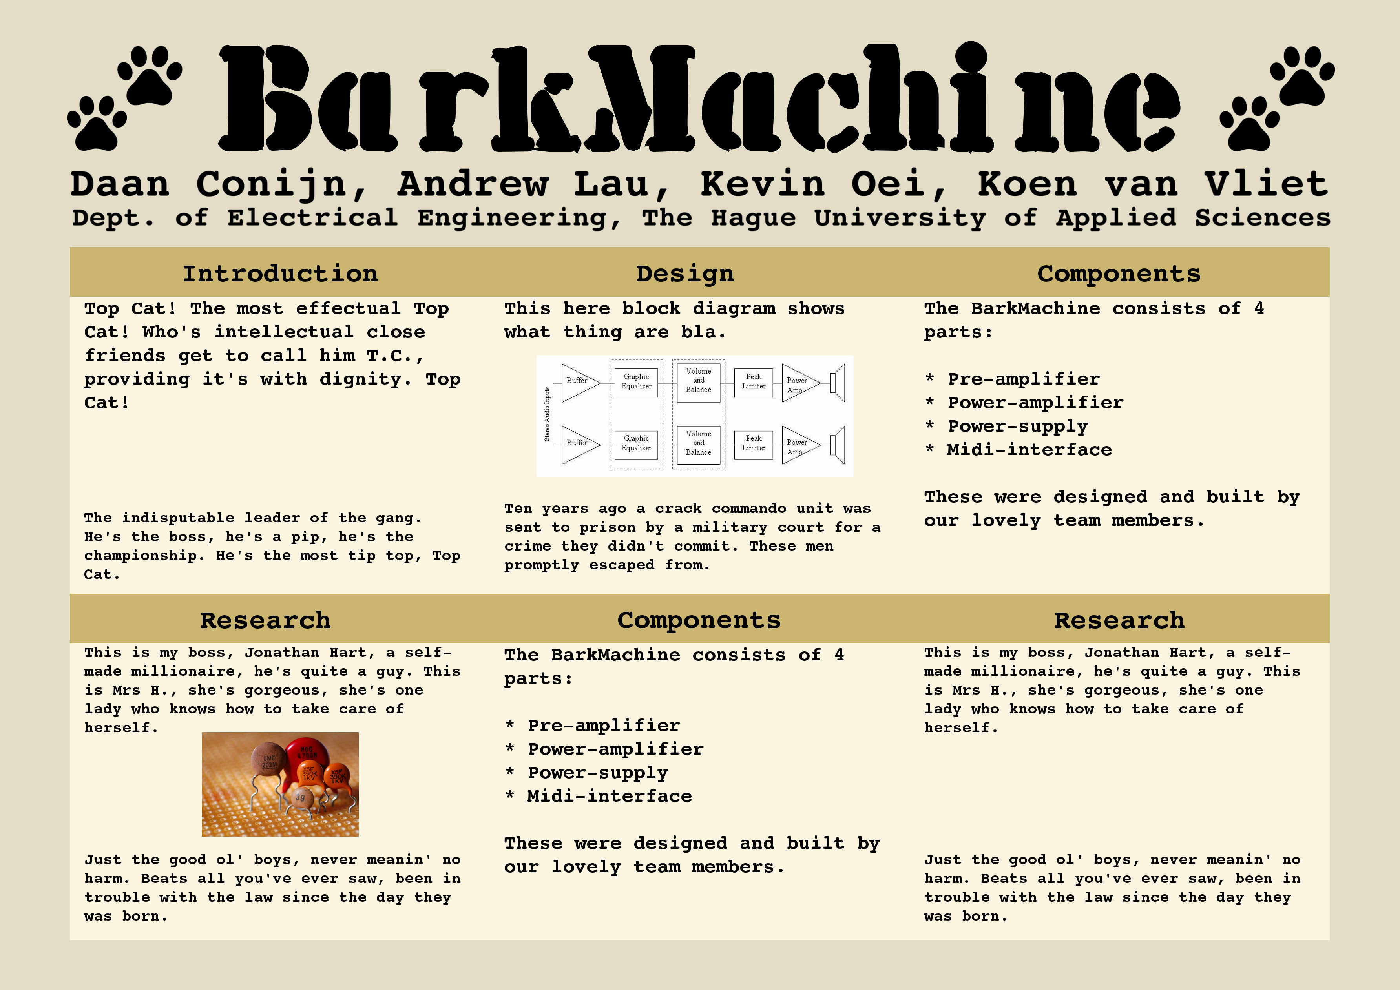
products/poster_presentation/barkposter-idea.jpg
