13093053/barfmachine/products/poster_presentation/barkposter-idea_version_2.png

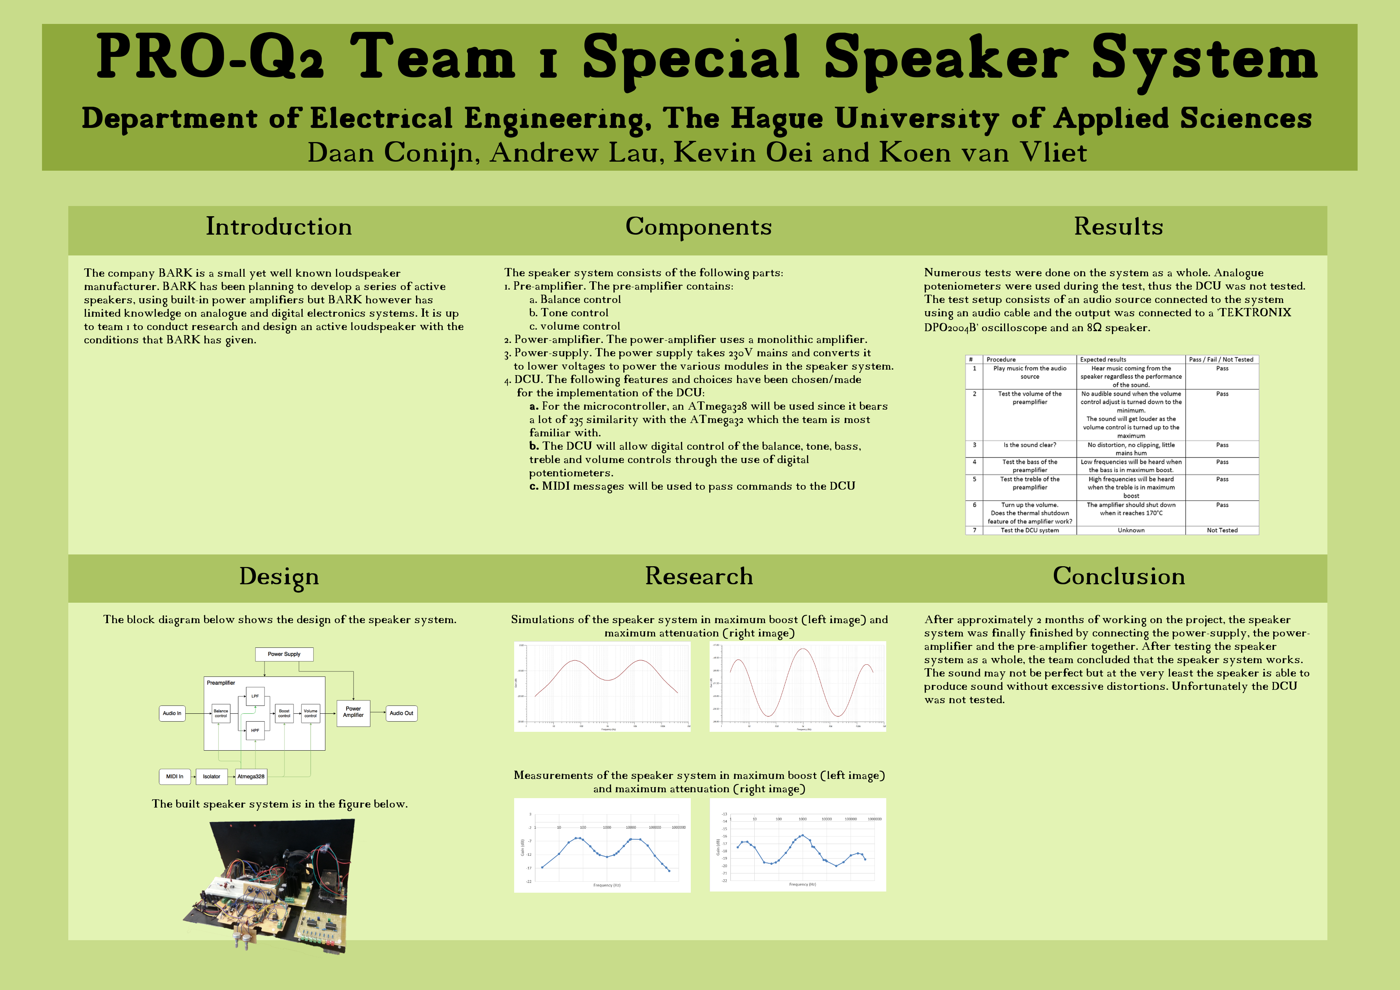
products/poster_presentation/barkposter-idea_version_2.png
