13093053/barfmachine/products/poster_presentation/barkposter-idea_version_3.png

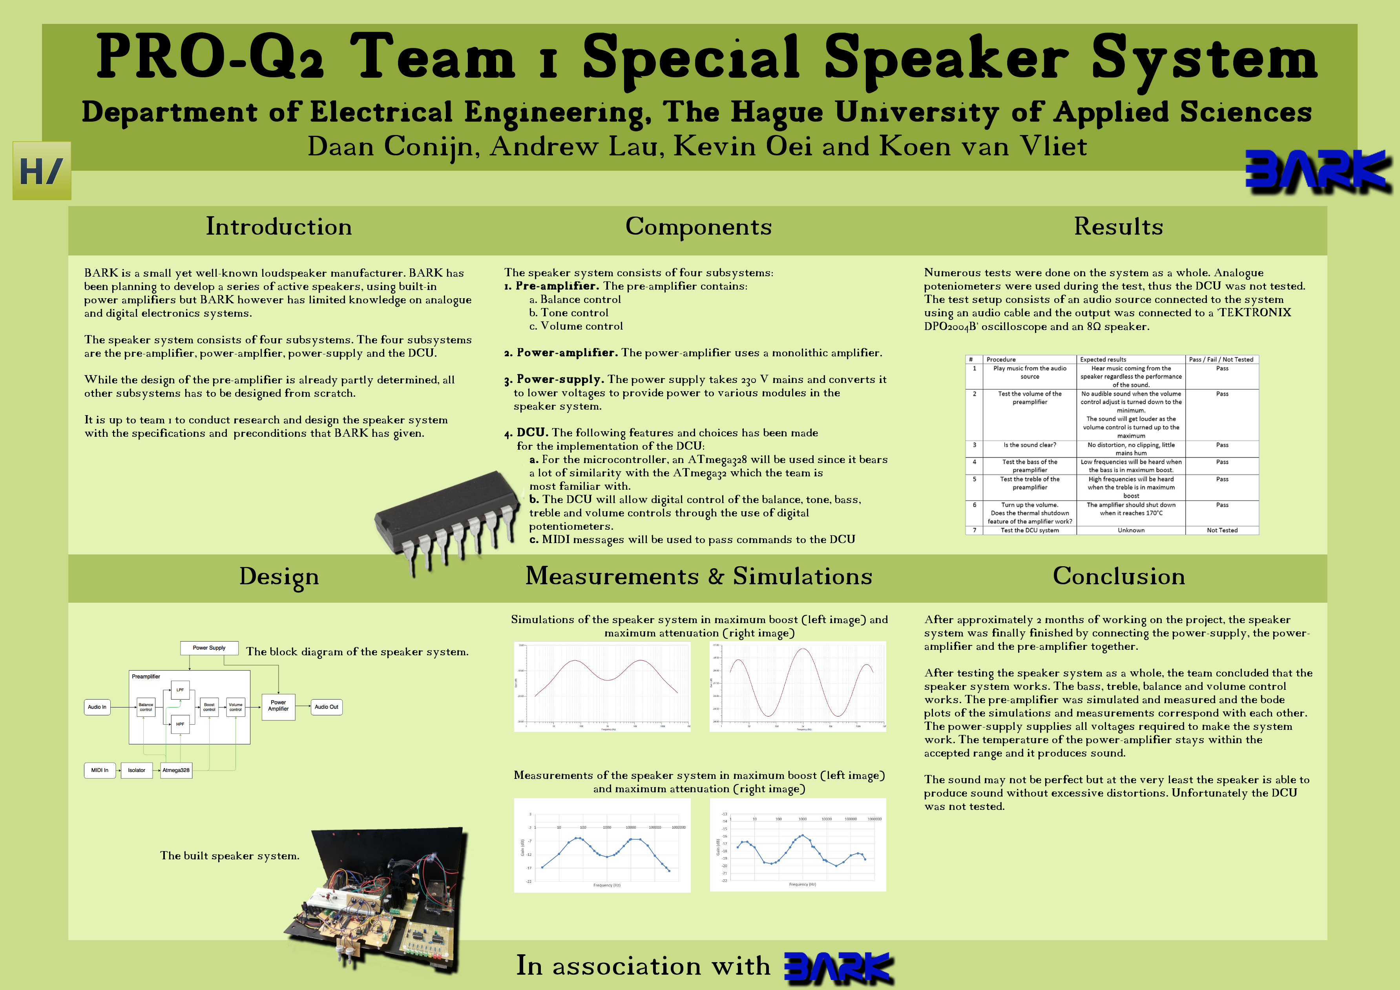
products/poster_presentation/barkposter-idea_version_3.png
