13093053/barfmachine/products/poster_presentation/barkposter-idea_version_5.png

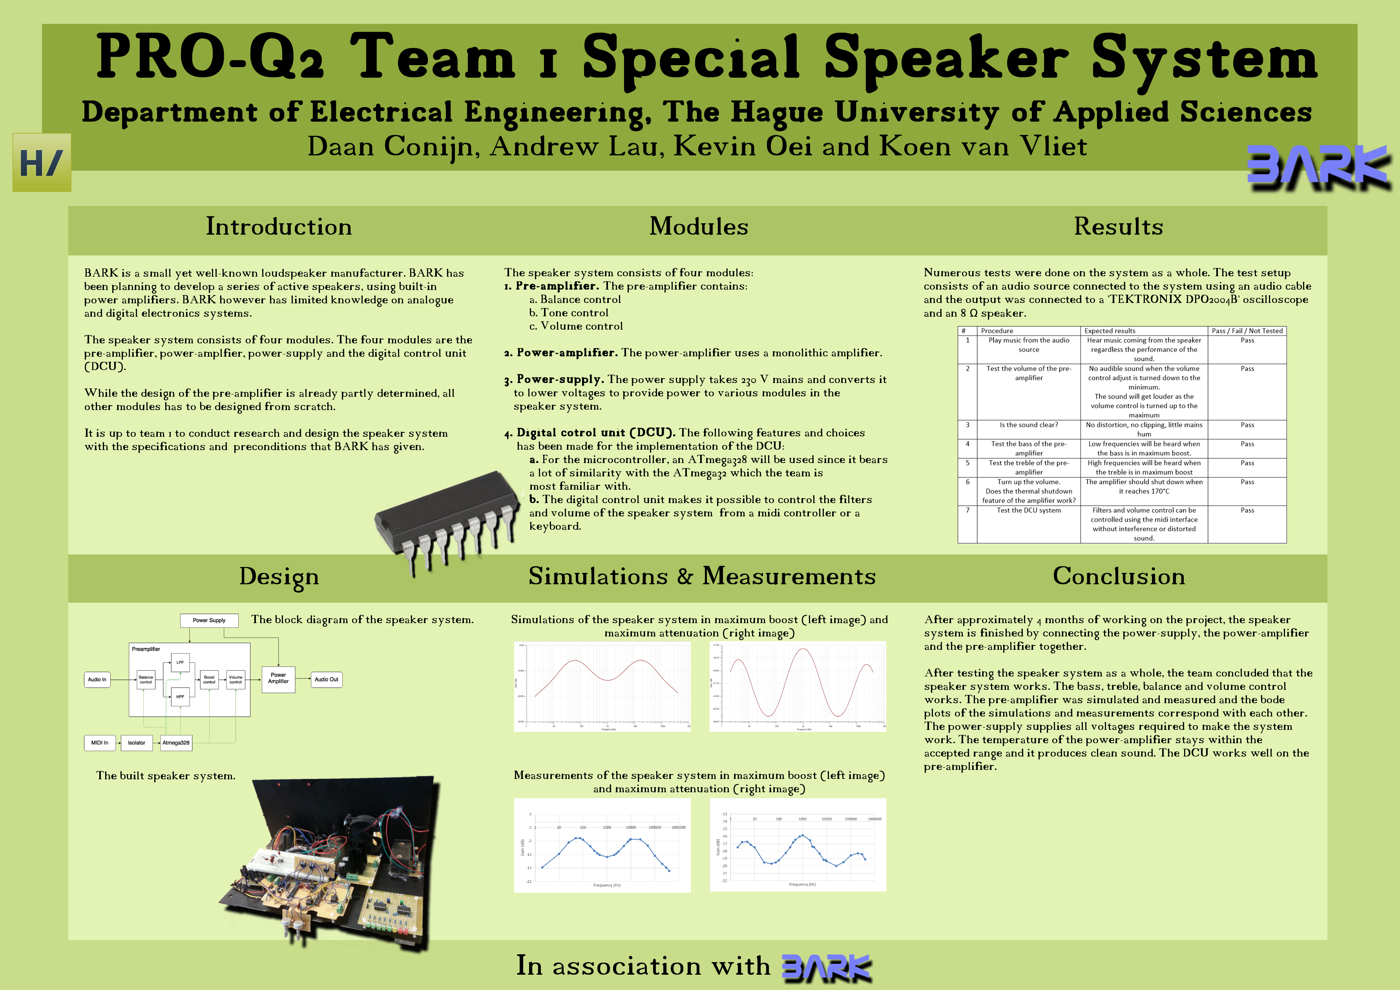
products/poster_presentation/barkposter-idea_version_5.png
