13093053/barfmachine/products/poster_presentation/block diagram speaker system.png

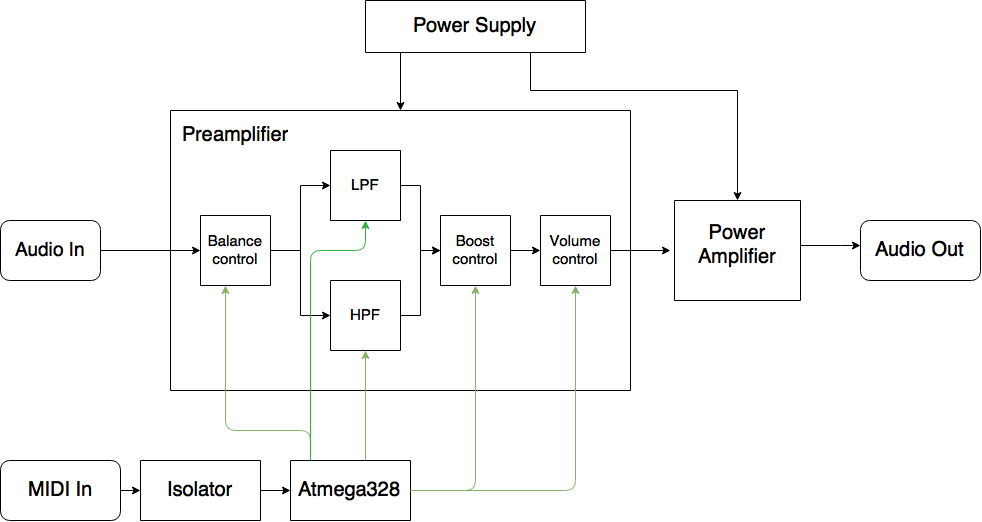
products/poster_presentation/block diagram speaker system.png
