13093053/barfmachine/products/poster_presentation/preview_poster.png

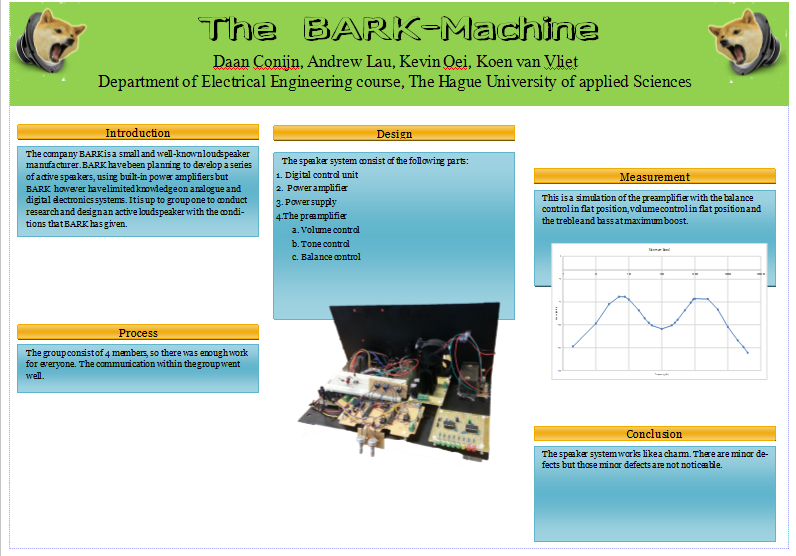
products/poster_presentation/preview_poster.png
