13093053/barfmachine/products/poster_presentation/symbol/545776_390559097630579_1311607519_n.jpg

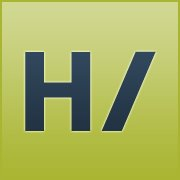
products/poster_presentation/symbol/545776_390559097630579_1311607519_n.jpg
