13093053/barfmachine/products/poster_presentation/symbol/BARK_machine_symbol.png

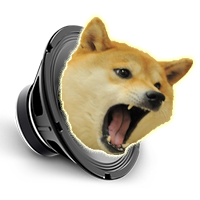
products/poster_presentation/symbol/BARK_machine_symbol.png
