13093053/barfmachine/research/Researchpaper_bridged/balanced_amplifier.jpg

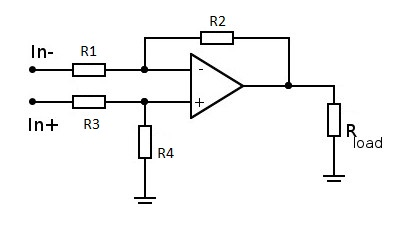
research/Researchpaper_bridged/balanced_amplifier.jpg
