13093053/barfmachine/research/Researchpaper_bridged/bridged_amp_basic.jpg

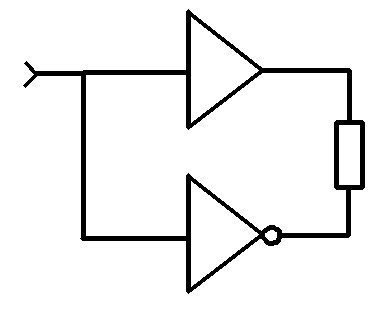
research/Researchpaper_bridged/bridged_amp_basic.jpg
