13093053/barfmachine/research/Researchpaper_bridged/feedback/Scan0001.jpg

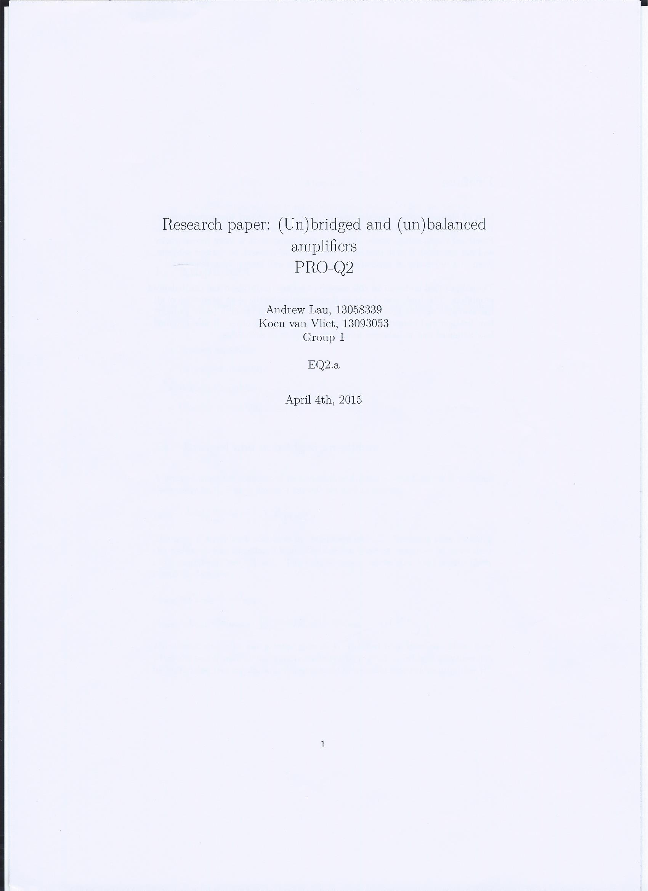
research/Researchpaper_bridged/feedback/Scan0001.jpg
