13093053/barfmachine/research/Researchpaper_bridged/feedback/Scan0002.jpg

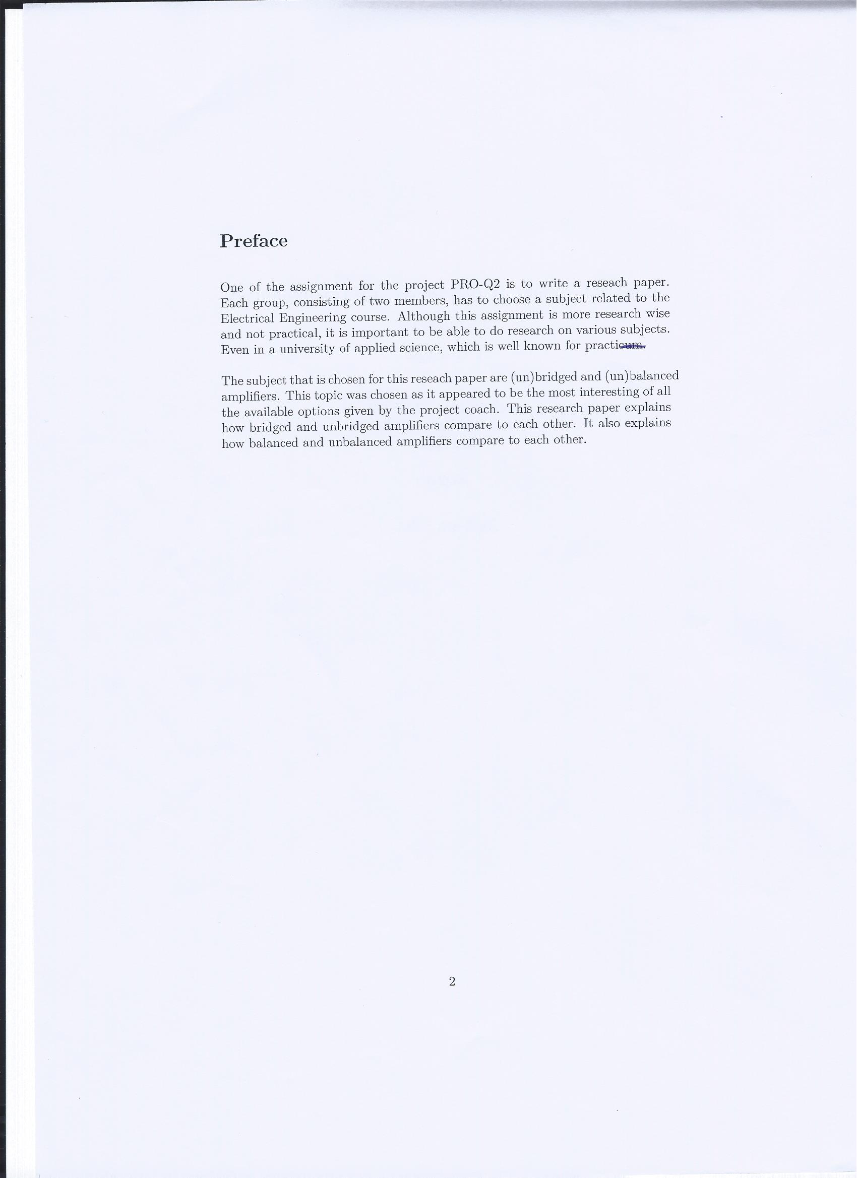
research/Researchpaper_bridged/feedback/Scan0002.jpg
