13093053/barfmachine/research/Researchpaper_bridged/feedback/Scan0003.jpg

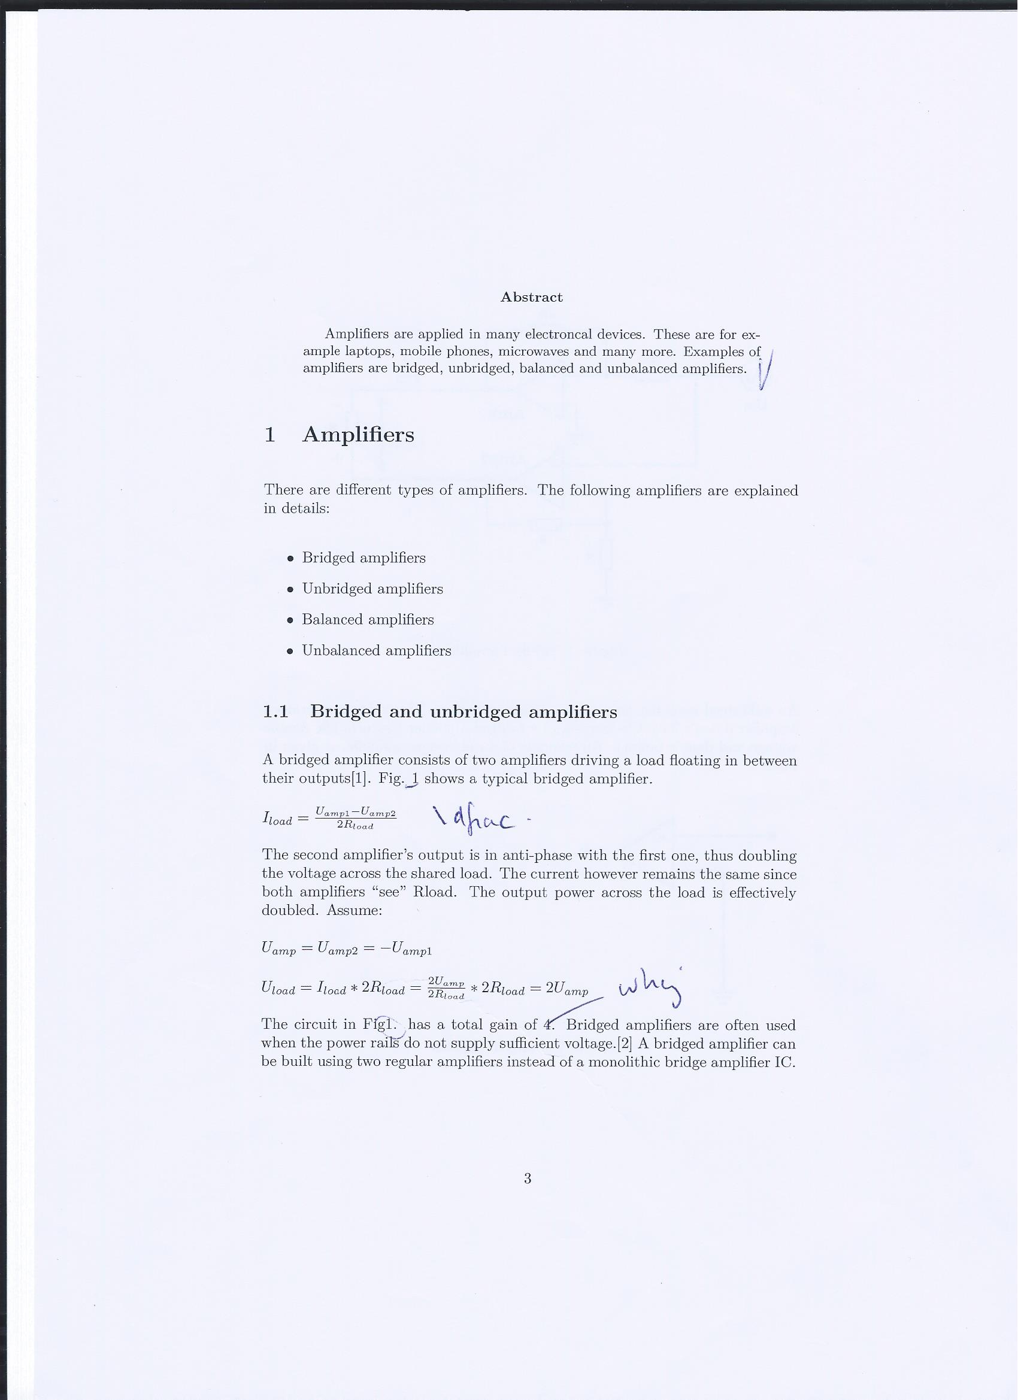
research/Researchpaper_bridged/feedback/Scan0003.jpg
