13093053/barfmachine/research/Researchpaper_bridged/feedback/Scan0004.jpg

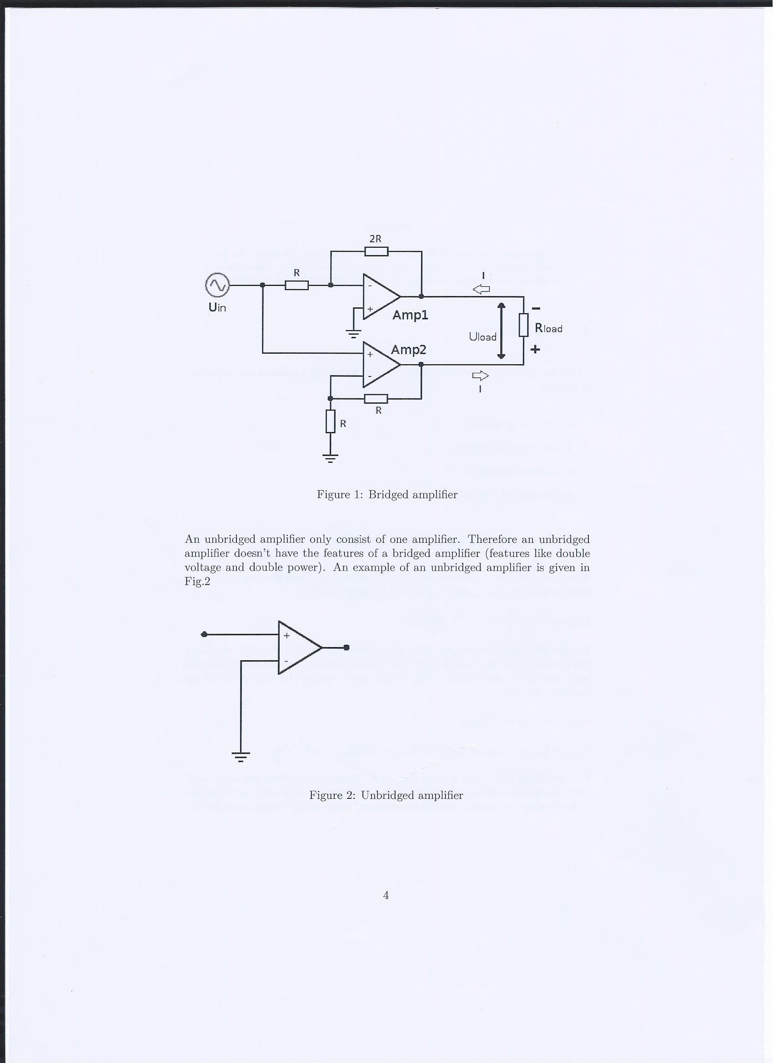
research/Researchpaper_bridged/feedback/Scan0004.jpg
