13093053/barfmachine/research/Researchpaper_bridged/feedback/Scan0005.jpg

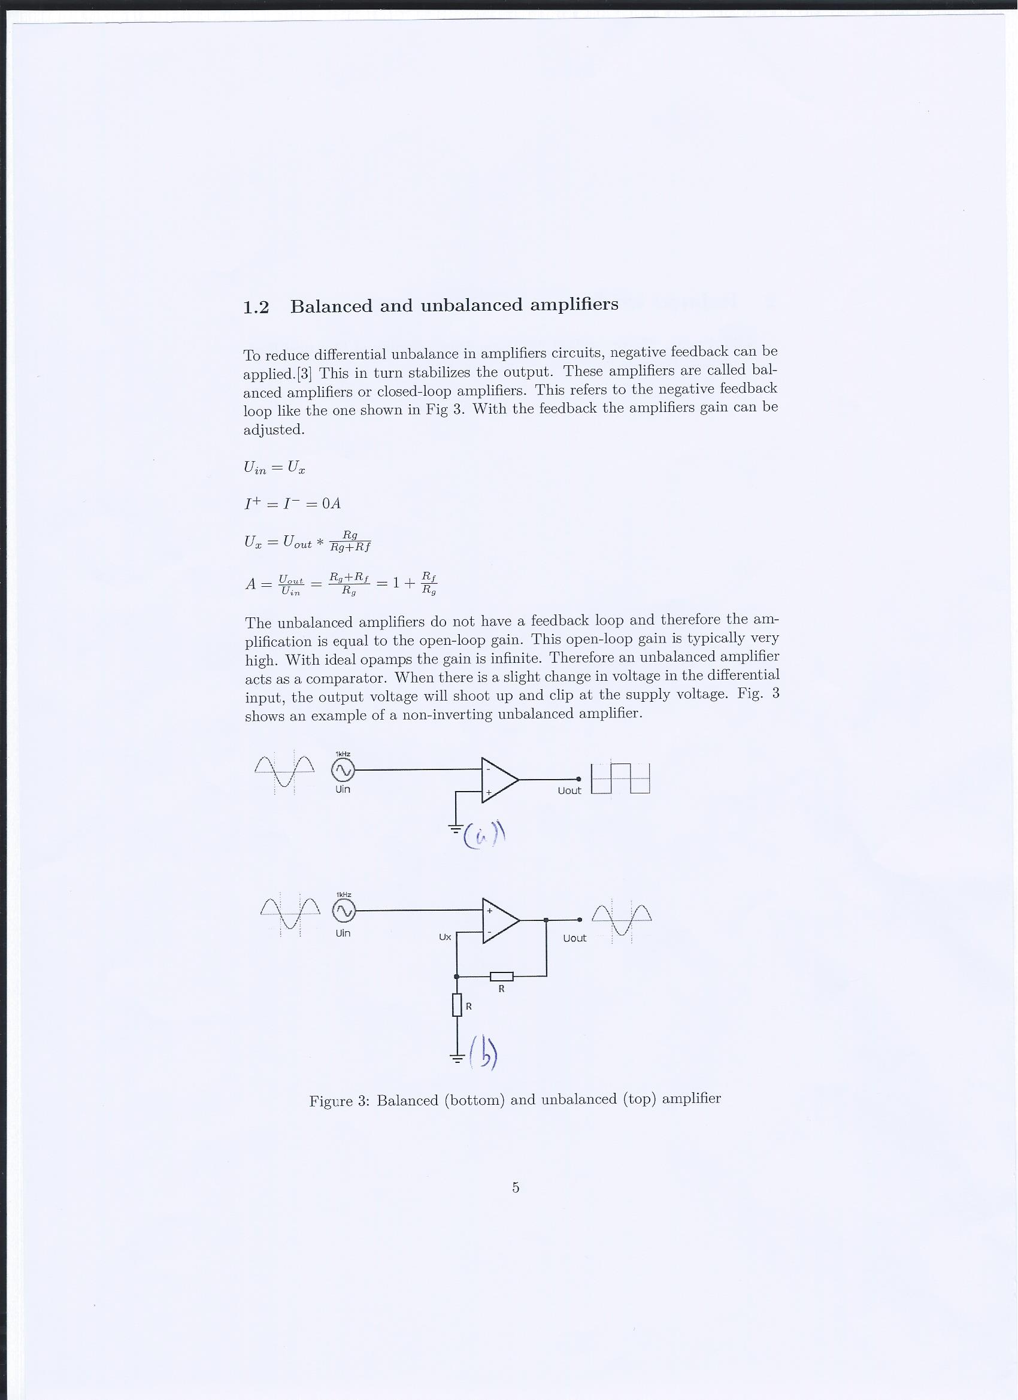
research/Researchpaper_bridged/feedback/Scan0005.jpg
