13093053/barfmachine/research/Researchpaper_bridged/pdf/bridged/Untitled.png

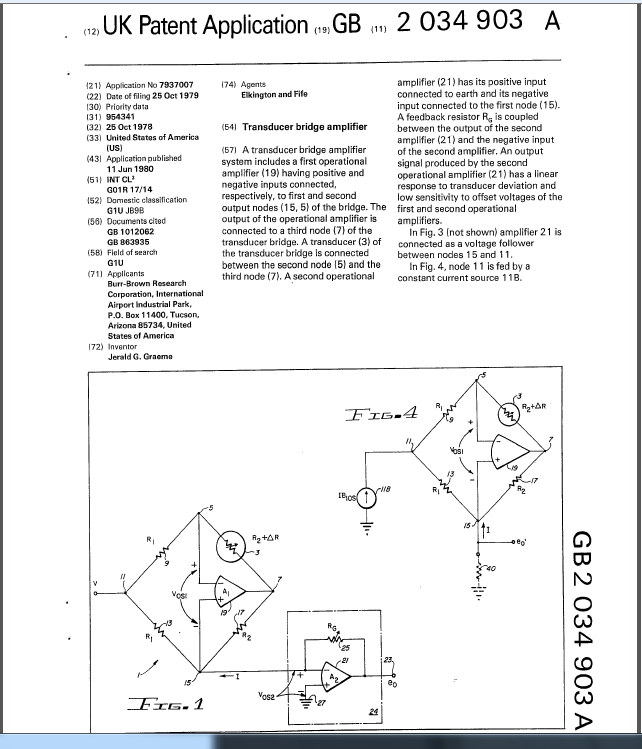
research/Researchpaper_bridged/pdf/bridged/Untitled.png
