13093053/barfmachine/research/Researchpaper_bridged/unbridged_amplifier.jpg

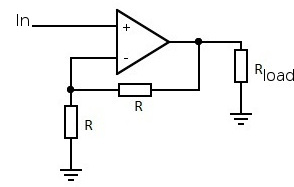
research/Researchpaper_bridged/unbridged_amplifier.jpg
