13093053/barfmachine/bom/bomFinal.txt

Amt.    Farnell No.
 1x     1839427
 1x     9530380
 8x     1861507
 1x     2080459
 5x     1162740
 4x     1800669
10x     2330089
 1x     2296026
 3x     1710627
 1x     1468913
 1x     148266 
 1x     1972087
 1x     1075277
 1x     1840806
 1x     1319813
 1x	149056
