13093053/barfmachine/products/measurement_reports/breadboard_with_components.jpg

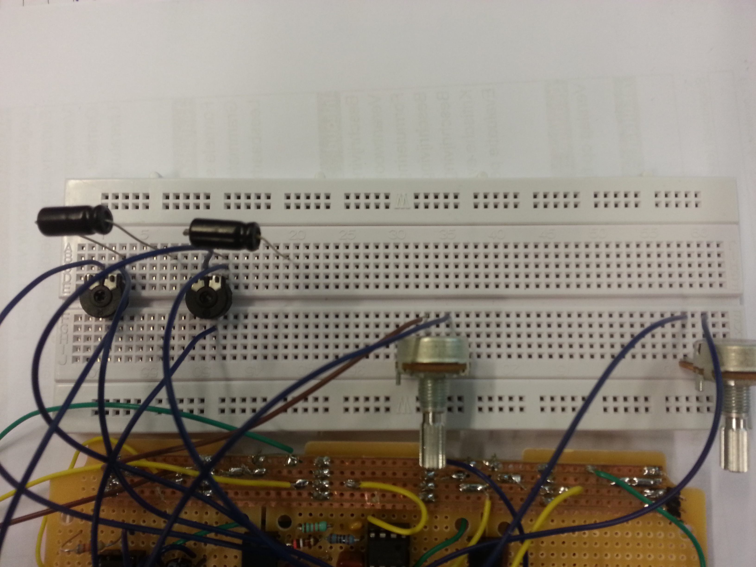
products/measurement_reports/breadboard_with_components.jpg
