13093053/barfmachine/research/research_paper-emi/sources_Daan/Design of an Operational Amplifier.pdf

834 | IEEE TRANSACTIONS ON ELECTROMAGNETIC COMPATIBILITY, VOL. 49, NO. 4, NOVEMBER 2007

# Design of an Operational Amplifier Input Stage Immune to EMI

Franco Fiori, Member, IEEE

Abstract—This paper presents a new analytical model to predict upsets, which are induced by electromagnetic interferences (EMI) in CMOS operational amplifiers (opamps). In particular, it is pointed out that the demodulation of EMI, which is experienced in feedback CMOS opamps, is related to the power spectral density of the interfering signals reaching the opamp input terminals. Furthermore, the new model is employed to design a differential stage immune to EMI.

Index Terms—Electromagnetic interference (EMI), electromagnetic susceptibility, integrated circuits, nonlinear model, operational amplifier.

I. INTRODUCTION

T HE ELECTROMAGNETIC emission delivered by modern electronic equipment has significantly increased the level of electromagnetic pollution, and the amplitude of radiofrequency interference (RFI), which is collected by electronic system harnesses, can be higher than that of nominal signals. Currently, the amplitude of RFI reaching ICs is kept under control by electromagnetic interference (EMI) filters and electromagnetic shields, which are usually employed at printed circuit board (PCB) or system level. The use of these components does not guarantee the compliance to electromagnetic compatibility (EMC) specifications, and sometimes, susceptibility issues come out just before production. In addition, EMI filters cannot be included into electronic modules, like automotive ones, where a seamless integration of microelectronic devices (like system-on-chip) and mechanical parts is required, and where PCBs are usually missing [1]. As a consequence, in the last few years, the interest to fulfill EMC specifications by a proper design of ICs has significantly increased, and although some design rules are already known [2], the subject of susceptibility of analog and digital ICs to EMI deserves further investigation. In this paper, the demodulation of EMI, which is operated by feedback operational amplifiers (opamps), is investigated, and unlike previous works [3], a new model that is valid for any kind of interfering signals is presented. In addition, such a model is employed in the design of a new opamp input stage to achieve the immunity to EMI.
The paper is organized as follows. In Section II, the distortion of EMI in a MOS differential pair is discussed, and a new analytical model is presented. In Section III, a new circuit topology, which is immune to EMI, is described, and its performance in terms of RFI demodulation is compared in Section IV with that

Manuscript received April 14, 2006; revised December 4, 2006.
The author is with the Dipartimento di Elettronica, Politecnico di Torino, Torino 10129, Italy (e-mail: franco.fiori@polito.it).
Digital Object Identifier 10.1109/TEMC.2007.908255

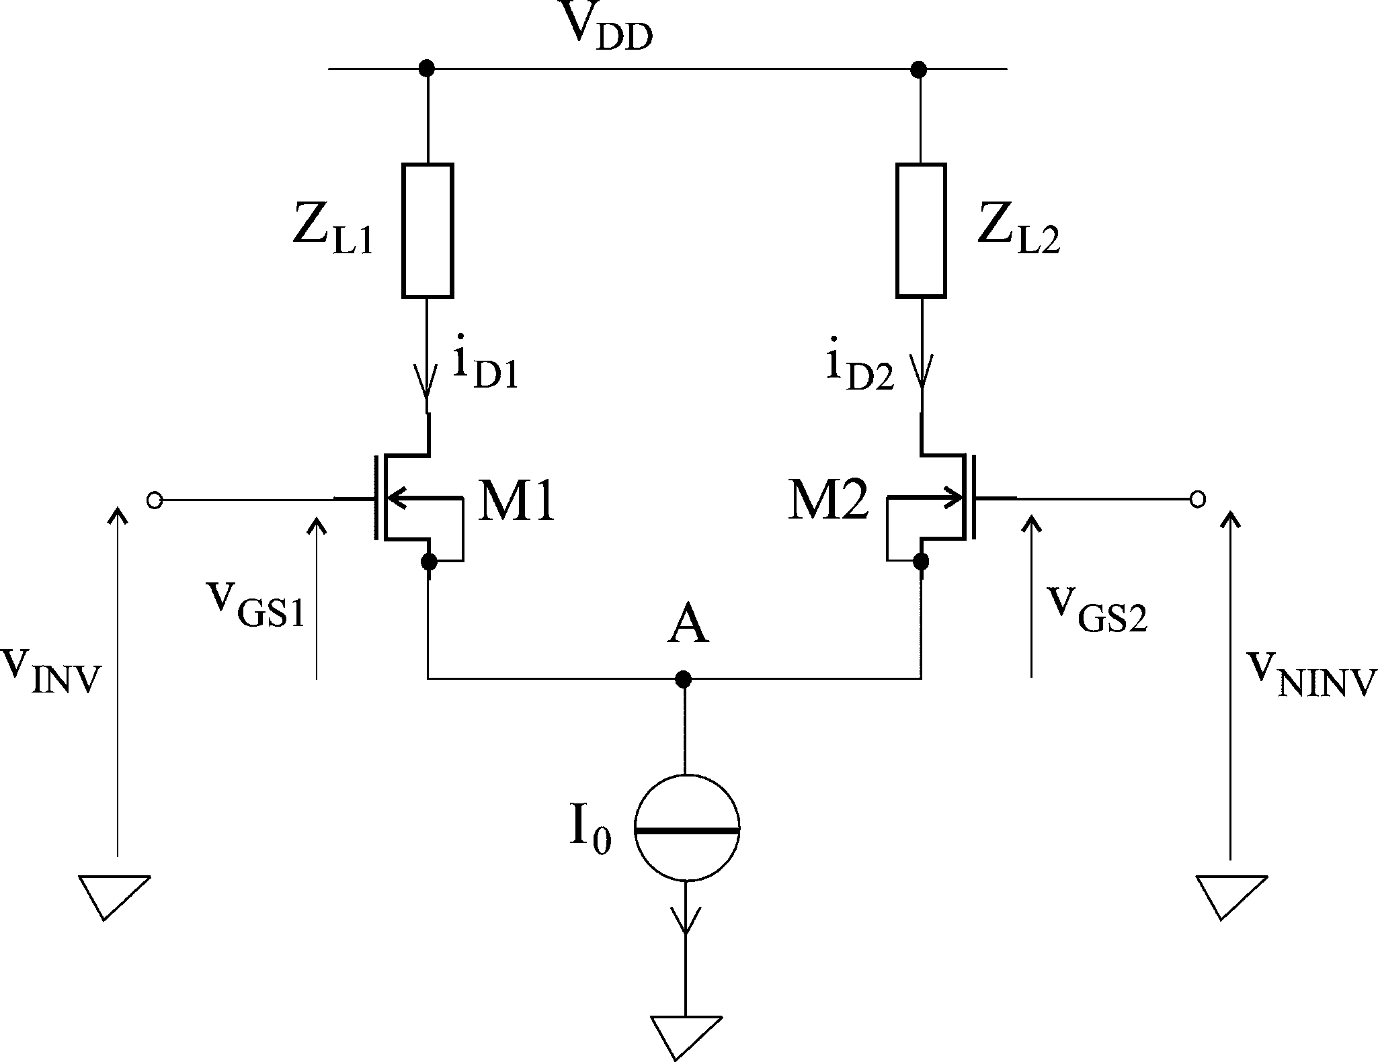
[picture p73: figure]

Fig. 1. Basic nMOS differential pair.

of other circuit topologies. Finally, in Section V, some concluding remarks are drawn.

II. SUSCEPTIBILITY TO EMI OF CMOS OPAMPS

As mentioned in the introduction, feedback opamps demodulate EMI, and in the case of sinusoidal interference of constant amplitude and frequency a dc output offset voltage is experienced [4], [5]. Furthermore, other works have shown that EMI is demodulated mostly in the opamp input differential pair, and some analytical models describing the interaction of transistor nonlinearities and parasitic elements have been presented [3], [6]. However, these models are valid only for sinusoidal interfering signals that do not describe all possible disturbances. To this purpose, the following sections show a new simple and effective model for the prediction of EMI-induced upset in a MOS differential stage, which is suitable for any kind of interfering signal waveform.

A. EMI Distortion in MOS Differential Pair

Common CMOS opamps are composed of cascaded amplifying stages, the first of which is usually a differential pair (see Fig. 1) that amplifies the difference of the input voltages vINV and vNINV

vD = vNINV − vINV | | (1)

while rejecting the common-mode voltage

vCM = vNINV + vINV
2 | . | (2)

0018-9375/$25.00 © 2007 IEEE

FIORI: DESIGN OF AN OPERATIONAL AMPLIFIER INPUT STAGE IMMUNE TO EMI | 835

Under the assumption of perfect matching of both transistors
(M1, M2) and loads (ZL1 , ZL2 ), and considering the input signal
spectra within the differential pair bandwidth, the output current
iD = iD1 − iD2 | | (3)

is not affected by the common-mode input signal. However, the simultaneous presence of out-of-band common- and differential-mode input signals cause this property to fail. To this purpose, under the assumption that the transistors M1 and M2 are always biased in the saturation region, their drain currents can be expressed as

iDi = β(vGSi − VTH )

2 , | i =1, 2 | (4)

in which
β = µnCox
2

W
L | | (5)

where µn is the mobility of electrons in nMOS devices, Cox is the capacitance of the gate oxide per unit area, W and L are, respectively, the width and the length of the gate area, VTH is the threshold voltage, while vGSi is the gate-source voltage. Such voltages are expressed in the following as:

vGSi = vGSi + vgsi(t), | i =1, 2 | (6)

where v¯GSi is the mean value of the gate-source voltage, and vgsi(t) is the time-variant term, whose mean value is zero. On the basis of (6), the mean value of the differential output current can be written as

iD = iD1 − iD2 | | (7)

where

iDi = β

(vGSi − VTH )

2 + v²
gsi
, | i =1, 2 | (8)

in which v²
gsi is the mean-square value of the gate-source voltage.
Assuming now that the input voltage sources vNINV and vINV have the same mean value (vD = 0), the gate-source voltages equal each other (vGS1 = vGS2 ), and the mean value of the differential output current takes the form

¯iD = β
v²

gs1 − v²

gs2 | (9)

while the bias current of the differential stage can be written as

I0 = β

2(vGS1 − VTH )

2 + v²
gs1 + v²
| gs2 -
| . | (10)

In these equations, vGS1 , v²

gs1 , and v²
gs2 are unknowns, and they are expressed in the following in terms of their power spectral density (PSD).
To this purpose, the mean-square value of the gate-source voltage (v²
gsi) can be written as

v²
gsi =

+∞

−∞

SVgsi(ω) dω | (11)

where SVgsi(ω) is the PSD of the gate-source that takes the form

SVgsi(ω)= VGSi(ω)V
GSi(ω), | i =1, 2 | (12)

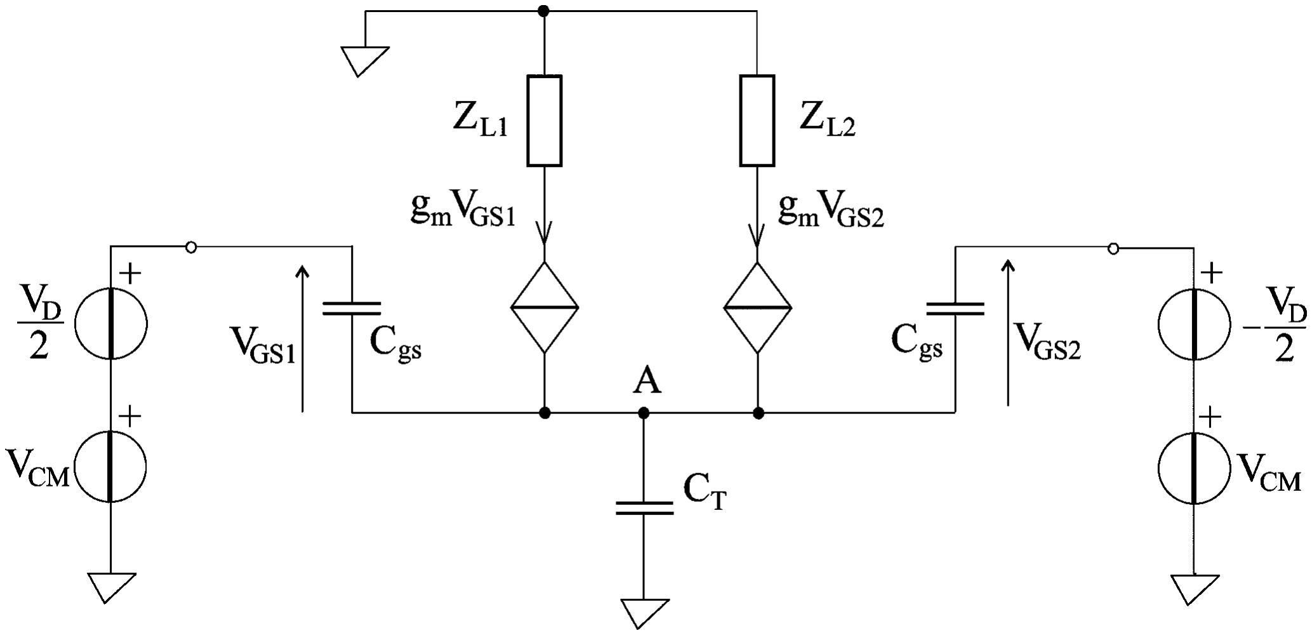
[picture p74: figure]

Fig. 2. | Small signal equivalent circuit of the differential pair.

where VGSi(ω) is the Fourier transform of the ith gate-source voltage, which can be derived from the analysis of the equivalent circuit of Fig. 2. In particular

VGS1 (ω)= H(ω)VCM (ω)+ VD (ω)
2 | (13)

VGS2 (ω)= H(ω)VCM (ω) − VD (ω)
2 | (14)

where

H(ω)= | jωCT
2gm + jω(CT +2Cgs)
. | (15)

In (15), gm is the transconductance of the transistors M1 and M2, which can be written as

gm =2β(vGS1 − VTH ) | (16)

while CT is the parasitic capacitance between the node A and the ground (see Fig. 2), and Cgs is the gate-source capacitance of the transistors M1 and M2.
The substitution of (11) and (13)–(15) in (10) and some algebraic passages gives

I0 − g²
m
2β =2β

+∞
−∞ | ω²C²
T
4g²

m + ω² (CT +2Cgs)² |VCM |

2

+ |VD |

2
4
dω (17)

that has to be solved in the unknown gm , the transistors’ transconductance.
Furthermore, the substitution of (11), (13), and (14) in (9) gives

id = β

+∞

−∞

{H(ω)VCM (ω)VD (ω)} dω (18)

which can be further simplified if cyclical input signals are considered. In fact, the Fourier transform of the common- and

836 | IEEE TRANSACTIONS ON ELECTROMAGNETIC COMPATIBILITY, VOL. 49, NO. 4, NOVEMBER 2007

differential-mode input signals can be written as

VCM (ω)= ∞

q=−∞

µcm δ(f − qf0 ) | (19)

VD (ω)= ∞

p=−∞

µd δ(f − pf0 ) | (20)

where µcm and µd are the coefficients of the Fourier series expansion of vCM (t) and vD (t), respectively, and f0 =1/T is the fundamental frequency. The substitution of (19) and (20) in
(17) and (18) gives

I0 − g²
m

2β =2β

+∞
n=−∞ | 2nπ
| T

2 C²
T
4g²
| m + 2nπ
| T 2 (CT +2Cgs)²

|µcm |

2

+ |µd |

2
4
(21)

id = β

+∞

n=−∞

H

2nπ
T
µcm µd
. | (22)

Finally, the input offset voltage of a feedback opamp, whose input nominal signals are corrupted by EMI, can be expressed as

voff = id
gm
| (23)

that requires the evaluation of (17) and (18).
In Sections II-A1 and II-A2, this new model is employed to predict the susceptibility of MOS differential pair to sinusoidal and trapezoidal interfering signals of constant amplitude and frequency.
1) Differential Stage Susceptibility to Sinusoidal Interference: In the presence of sinusoidal interference added to the input nominal signals of an MOS differential pair, (17) takes the form

I0 − g²
m
2β =2β

ω²

0C²
T
4g²

m + ω²

0 (CT +2Cgs)² V ²
cm,pk +

V ²
| d,pk
4

(24)
where ω0 =2πf0 , f0 is the interference frequency, while Vcm,pk and Vd,pk are, respectively, the peak value of the common- and the differential-mode interference.
From (24), with some algebraic passages follows

g²

m = −b
2 +

1
2
b² − 4c | (25)

in which
b = (CT +2Cgs)²
4 | ω²

0 − 2I0β + β²V ²
d,pk | (26)

c = β²ω²
0
C²

T V ²
cm,pk − (CT +2Cgs)

2

I0

2β − V ²
d,pk
4

(27)

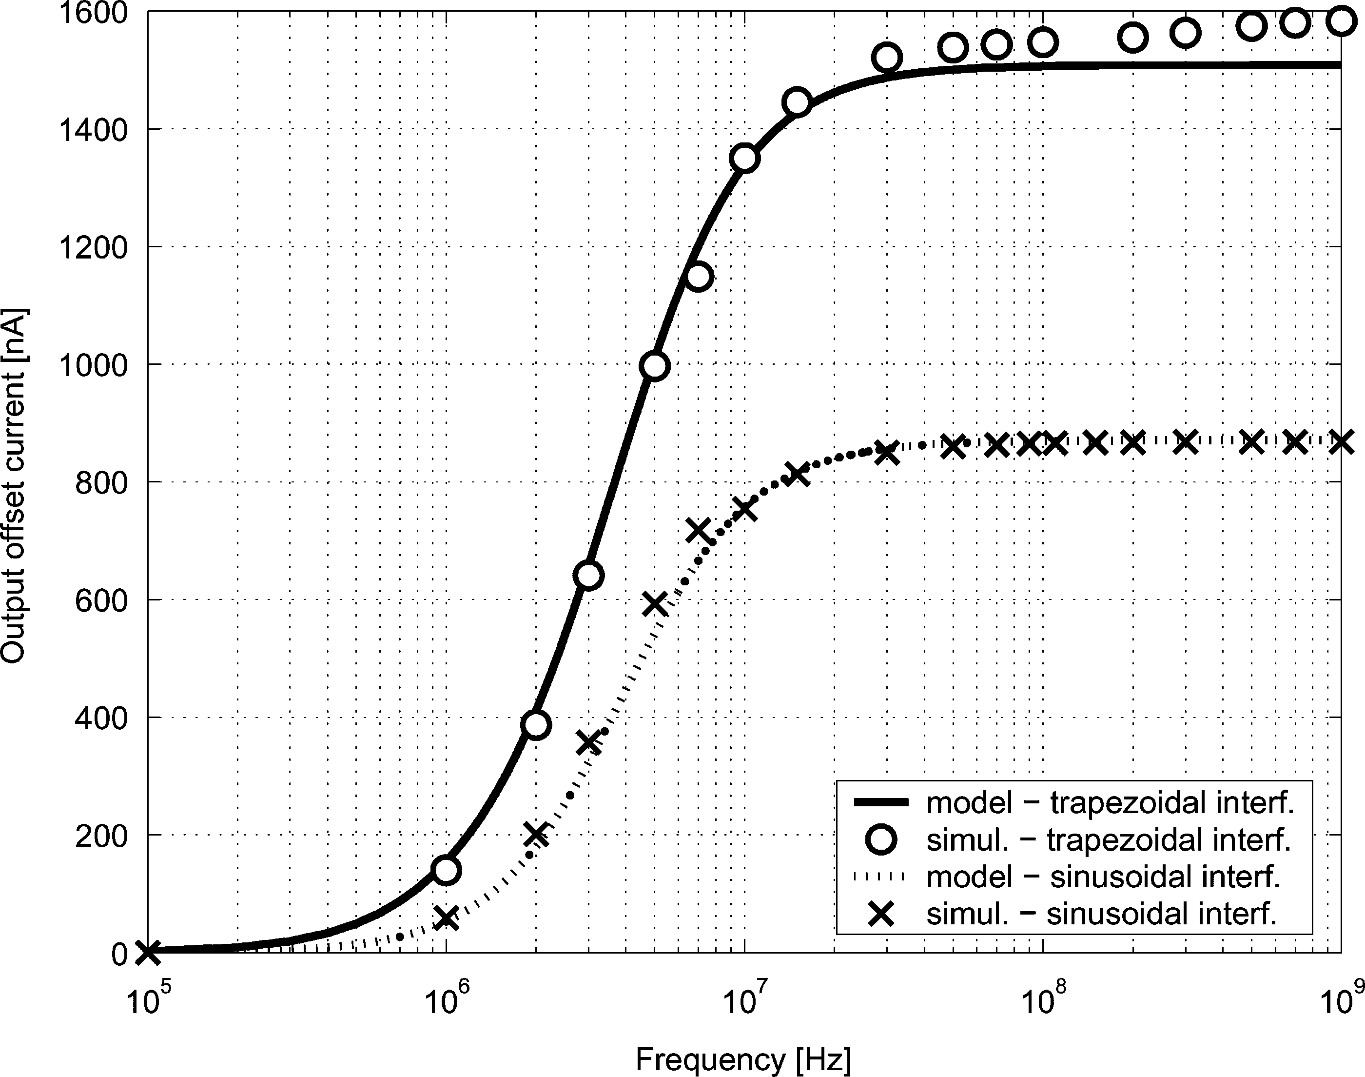
[picture p75: figure]

Fig. 3. Output offset current of a pMOS differential pair versus frequency. Continuous (dashed) line and circles (crosses) refer to trapezoidal (sinusoidal) interference, which were obtained by the new model and by computer simulations, respectively. In both cases, the peak amplitude of the differential mode is 200 mV while that of the common mode is 100 mV.

Furthermore, (18) can be written as

id = β
2

Vd,pkVcm,pk |H(ω0 )| cos( H + θ) (28)

and the evaluation of the RFI-induced offset becomes straightforward.
Let’s now consider a differential pair made up by two pMOS transistors of a 0.8-µm CMOS technology process [7], with aspect ratio (W/L) = 100/10 µm, bias current I0 = 20 µA, and parasitic capacitance CT =2.1 pF, is considered. It is powered by VDD =5 V, its input nominal voltages are Vcm−nom =3 V and Vd−nom =0 V, and furthermore, its input terminals are driven simultaneously by sinusoidal differential-mode and common-mode interference whose amplitudes are Vd,pk = 200 mV and Vcm,pk = 100 mV, respectively. The effect of these signals on the mean value of the differential output current (id ) is evaluated in the frequency range 100 kHz–1 GHz, and the results are plotted in Fig. 3. In this figure the continuous line refers to model predictions, while circles show the results of time-domain simulations, which were obtained by Spectre, a SPICE-like simulator. In addition, Fig. 4 shows the influence of CW interference on (gm ), the transistors’ transconductance, for frequencies in the range 100 kHz–1 GHz.
2) Differential Pair Susceptibility to Trapezoidal-Shaped Interference: Most of the modern electronic equipment includes processing units and/or switching power transistors that behave as primary sources of interference. Trapezoidal waveforms describe these disturbances quite well, and for this reason, they are considered here as possible interference, which can affect the nominal operation of a MOS differential stage. In the following, differential- and common-mode disturbances having the same period T, the same risetime and falltime that also equal each others (τr = τf ), and zero mean value are

FIORI: DESIGN OF AN OPERATIONAL AMPLIFIER INPUT STAGE IMMUNE TO EMI | 837

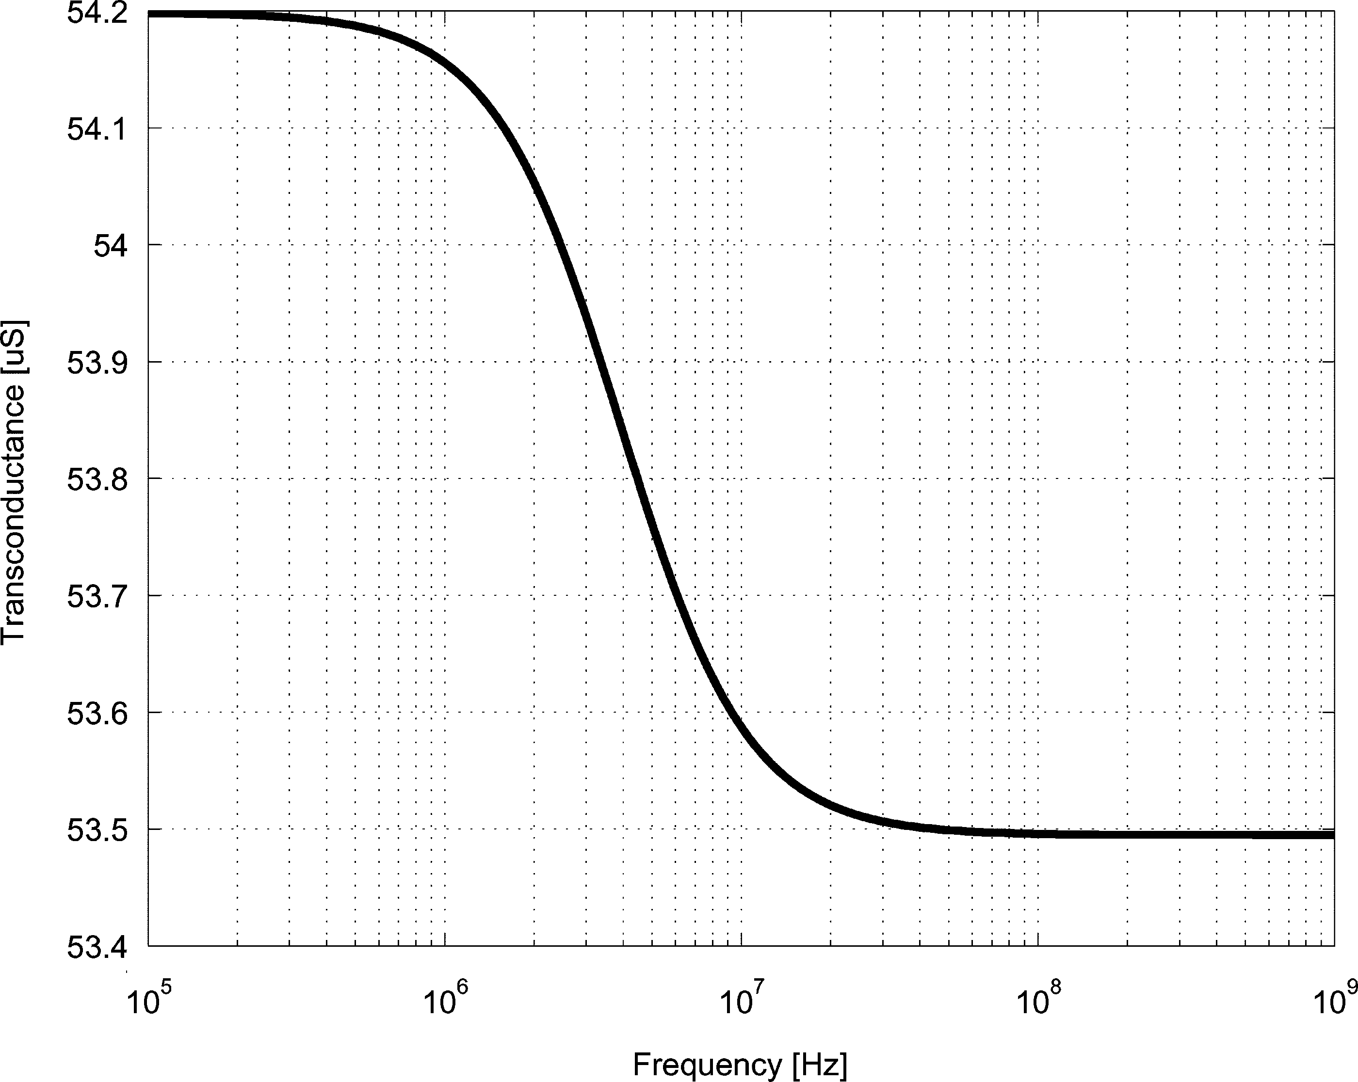
[picture p76: figure]

Fig. 4. | Transconductance of the transistors of a pMOS differential pair versus
frequency. Sinusoidal interference of constant amplitude 2Vcm ,pk = Vd,pk = 200 mV are considered.

considered. Nonetheless, these signals differ in amplitude and in phase.
On the basis of these assumptions, the coefficients of their Fourier series expansion can be written as

µcm−sq = −j

Acm−sq
2πn

sin( nπτ
T )

nπτ
T

sin nπτ r
T

nπτ r
T

× exp

−j

nπ(τ + τr )
T
(29)

µd−sq = −j

Ad−sq
2πn

sin( nπτ
T )

nπτ
T

sin( nπτ r
T )

nπτ r
T

× exp

−j

nπ(τ + τr )

T + θsq (30)

where θsq is the phase shift between trapezoidal waveforms. In addition, these expressions include the peak-to-peak amplitude of the common- and differential-mode voltages (Acm−sq , Ad−sq ), and the time between the 50% points of the waveform amplitude (τ ) [8].
On the basis of these expressions, and assuming that f0 (gm /(2π(CT +2Cgs)) and that infinity sums are truncated to the Nth harmonic, (21) and (22) can be easily evaluated, obtaining gm and id , respectively. For instance, let us now consider the same differential pair, which has been employed in Section II-A1, with the same nominal input voltages, while sinusoidal disturbances are replaced by trapezoidal ones. Such interfering signals have amplitudes Acm−sq = 200 mV and Ad−sq = 400 mV (the same as the sinusoidal disturbances), fundamental frequency f0 in the range 100 kHz–1 GHz, duty cycle of 50% (τ = T/2), risetime (falltime) τr = T/10, while the phase shift between them is null (θsq = 0). Therefore, running the new model with these parameters and considering ten

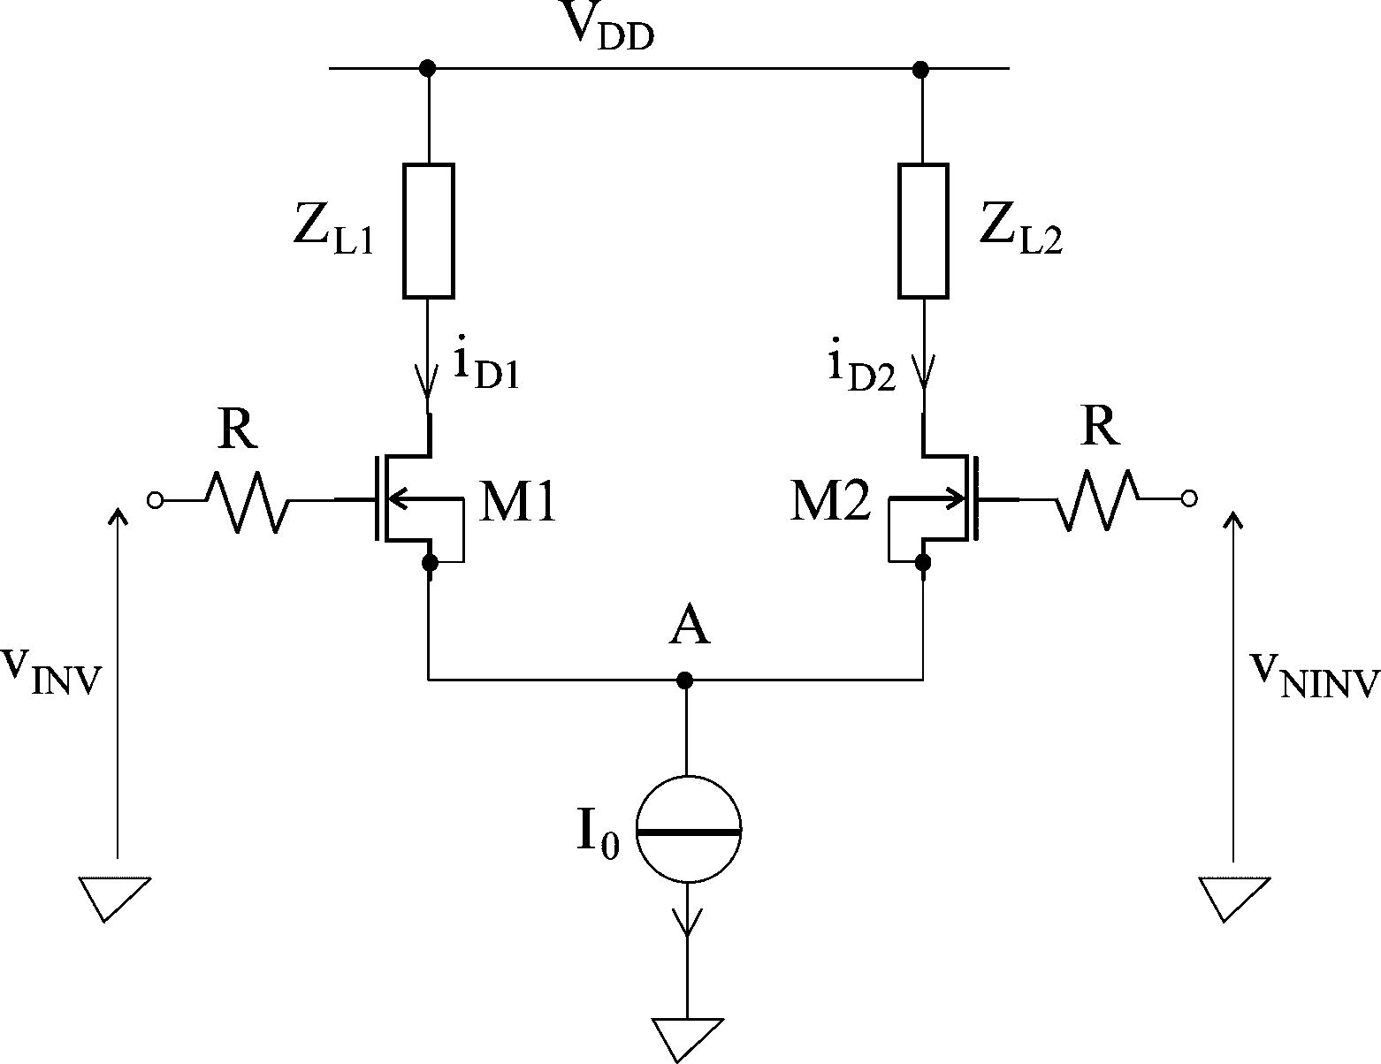
[picture p77: figure]

Fig. 5. nMOS differential stage including two resistors at the input terminals. Such resistors, together with the input capacitances of the differential stage, behave as input low-pass filters that improve the immunity to EMI.

harmonics of the interfering signals (N = 10), the results of Fig. 3 (dashed line) can be obtained, and the comparison with the results of time-domain simulations (crosses) becomes straightforward. To this purpose, it should be noticed that the agreement between the model predictions and the simulation results is quite good, but it is worse than that obtained with sinusoidal interference. This fact can be ascribed to the aforementioned approximations and to the frequency limitation of the model, which can be enhanced if a more accurate small signal equivalent circuit of the differential pair is employed (see Fig. 2).
In the following sections, it is shown how the new model can be employed to design an opamp input differential stage immune to EMI.

III. DOUBLE DIFFERENTIAL PAIR

Over the last few years, a few possible solutions to make opamps immune to EMI have been presented. Some of them are aimed to attenuate the amplitude of the interference reaching sensitive nonlinear devices. For instance, Fig. 5 shows a simple filtering solution, where two resistors (R) together with the input parasitic capacitances of a CMOS opamp behave as low-pass filters. Such integrated filters are critical for what concerns noise and circuit stability. Other circuits, like that shown in [9], are based on the compensation of EMI-induced upsets by means of proper circuit topologies. Such compensation networks usually require a silicon area larger than that of basic functional circuits (doubled at least), and in some cases, they affect some of the base-band circuit parameters, like the common-mode input voltage swing [10].
The following part of the paper shows a new differential stage that includes two cross-connected MOS differential pairs (see Fig. 6). In this circuit, the upset, which is induced by EMI in the primary differential stage (M1-M2), is compensated by that generated in the auxiliary differential pair (M3-M4). Unlike previous solutions, this compensation network provides high immunity to EMI, minimum silicon area, and almost no effect on the circuit base-band performance. More in detail, the total output current of the overall differential stage can be

838 | IEEE TRANSACTIONS ON ELECTROMAGNETIC COMPATIBILITY, VOL. 49, NO. 4, NOVEMBER 2007

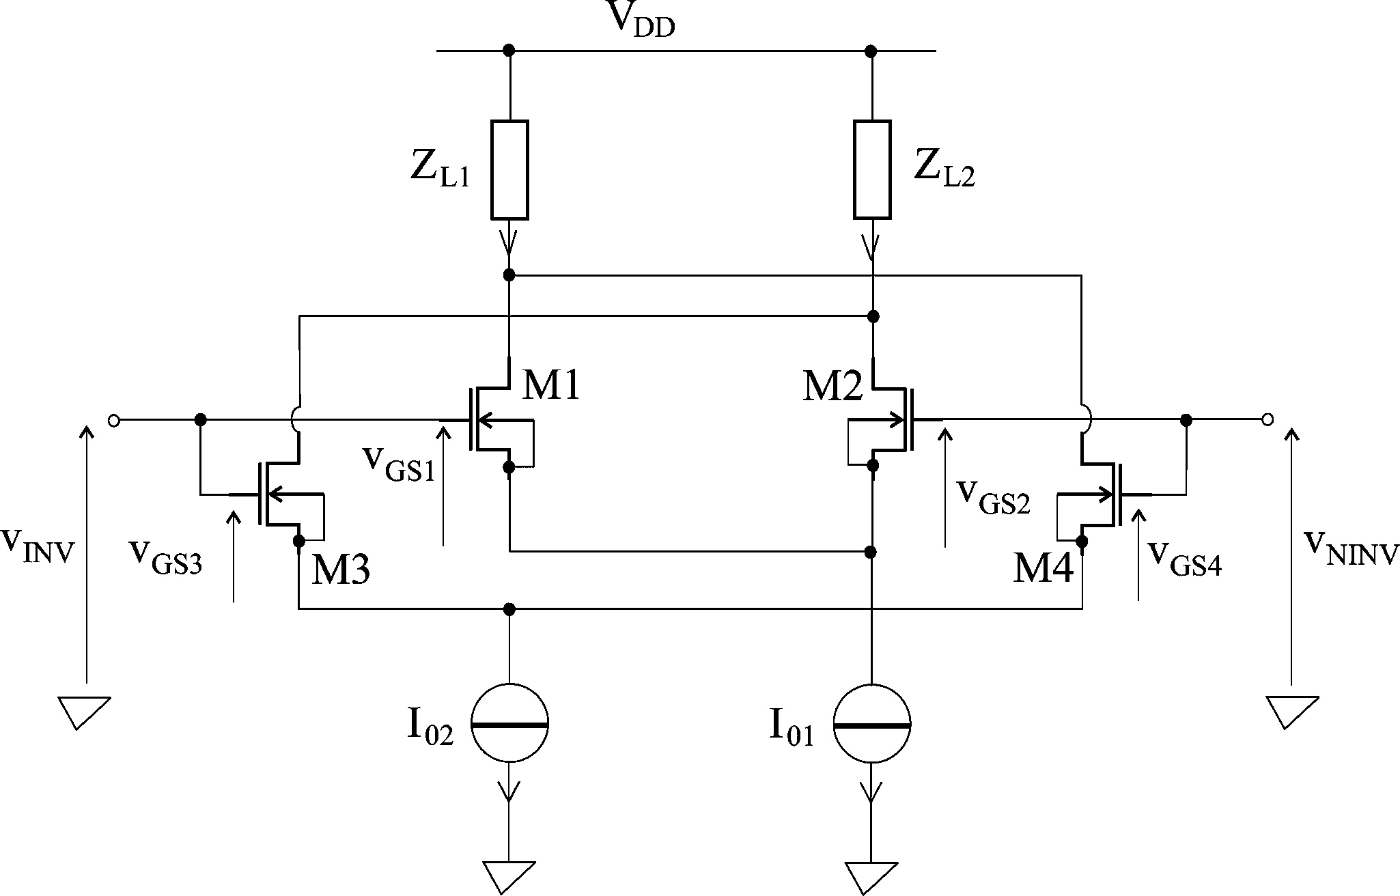
[picture p78: figure]

Fig. 6. | Schematic view of the double differential pair.

written as

id = id1−2 − id3−4 | (31)

that becomes

id =

+∞

−∞

{[β1H1 (ω) − β2H2 (ω)]VCM (ω)VD (ω)}dω

(32)
if (18) is employed. In (32)

βi = µnCox
2

Wi
Li
, | i =1, 2 | (33)
Hi(ω)= | jωCTi
2gmi + jω(CTi +2Cgsi)
, | i =1, 2. | (34)

Looking at (32) it can be easily noticed that the output offset current becomes null (id =0) if

β1H1 (ω)= β2H2 (ω). | | (35)

Equation (35) is always verified if two identical differential pairs are considered, but this case is not of practical interest because the total output current is always null, even when nominal input signals are provided. For this reason, (35) has to be satisfied under the constraint gm1 = gm2 .
Furthermore, from (35), it follows

β1CT 1

CT 1 +2Cgs1

= β2CT 2

CT 2 +2Cgs2

| | (36)

gm1

CT 1 +2Cgs1

= gm2 CT 2 +2Cgs2
(37)

and

β1

CT 1

CT 2

2
v²

gs3 + v²

gs4

−

v² | gs1 + v² gs2

= I01 − β1
β2

CT 1

CT 2

2
I02 (38)

in which v²
gsi is the mean-square value of the ith gate-source voltage, while I01 and I02 are, respectively, the bias currents of the differential pairs M1-M2 and M3-M4.

The left hand of (38) depends on the mean-square value of the gate-source voltages; hence, on the PSD of the common- and the differential-mode voltages, while the right hand includes constant design parameters. As a consequence, (38) must be solved referring to the worst case, i.e., the maximum amplitude of interference that could reach the differential pair input ports. As a result

2

|H2 (ω)|

2

CT 1

CT 2

2
−|H1 (ω)|

2

V ²
cm,pk

+

CT 1

CT 2

2
− 1
V ²
d,pk

2 = I01 β1
−

CT 1

CT 2

2 I02

β2

(39)

which becomes

2

C²
T 1
(CT 2 +2Cgs2 )² − | C²
T 1
(CT 1 +2Cgs1 )²
V ²
cm,pk

+

CT 1

CT 2

2
− 1
V ²
d,pk

2 = I01
β1

−

CT 1

CT 2

2 I02

β2

(40)

under the assumption ω max(gm1 /(CT 1 +2Cgs1 ),(gm2 / (CT 2 +2Cgs2 )).
The design of the double differential pair is now performed in order to fulfill both base-band and EMI specifications. In particular, the primary differential pair (M1-M2) is sized on the basis of base-band specifications, while the design of the auxiliary transistor pair (M3-M4) is performed through (36) and (40). As a consequence, the ratio CT 2 /CT 1 can be written as

CT 2

CT 1

2
=

I02
β2 +

V ²
d , pk
2 +

1
1+2 C gs2
CT 2

2
V ²
cm,pk

I01
β1 +

V ²
d , pk
2 +

1
1+2 C gs1
CT 1

2
V ²
cm,pk

(41)

which is kept at the minimum, if Cgs2 /CT 2 is negligible. Under this assumption, (36) is simplified and β2 takes the form

β2 = β1

CT 1

CT 1 +2Cgs1

(42)

while CT 2 is evaluated by (41). In (42), the maximum values of Vcm,pk and Vd,pk have to be considered and the maximum EMI-induced output offset current, which is induced by RFI in the differential pair M1-M2, is evaluated by (28). To avoid any upset compensation failure, the offset current in the primary differential pair should always be lower than the maximum M3-M4 output offset current, i.e., I02 . In Section III, the design of a double differential pair is shown, and its EMI performance is compared with that of other circuit topologies.

IV. DESIGN PROCEDURE AND SIMULATION RESULTS

This section describes a method to design a double differential pair immune to EMI. In particular, the same differential pair, which has been described in Section II-A1, is considered. It includes two pMOS transistors with aspect ratio (W/L)1,2 = 100/10 µm biased by the dc current source I01 = 20 µA, while its parasitic capacitance CT 1 =2.1 pF has been obtained from

FIORI: DESIGN OF AN OPERATIONAL AMPLIFIER INPUT STAGE IMMUNE TO EMI | 839

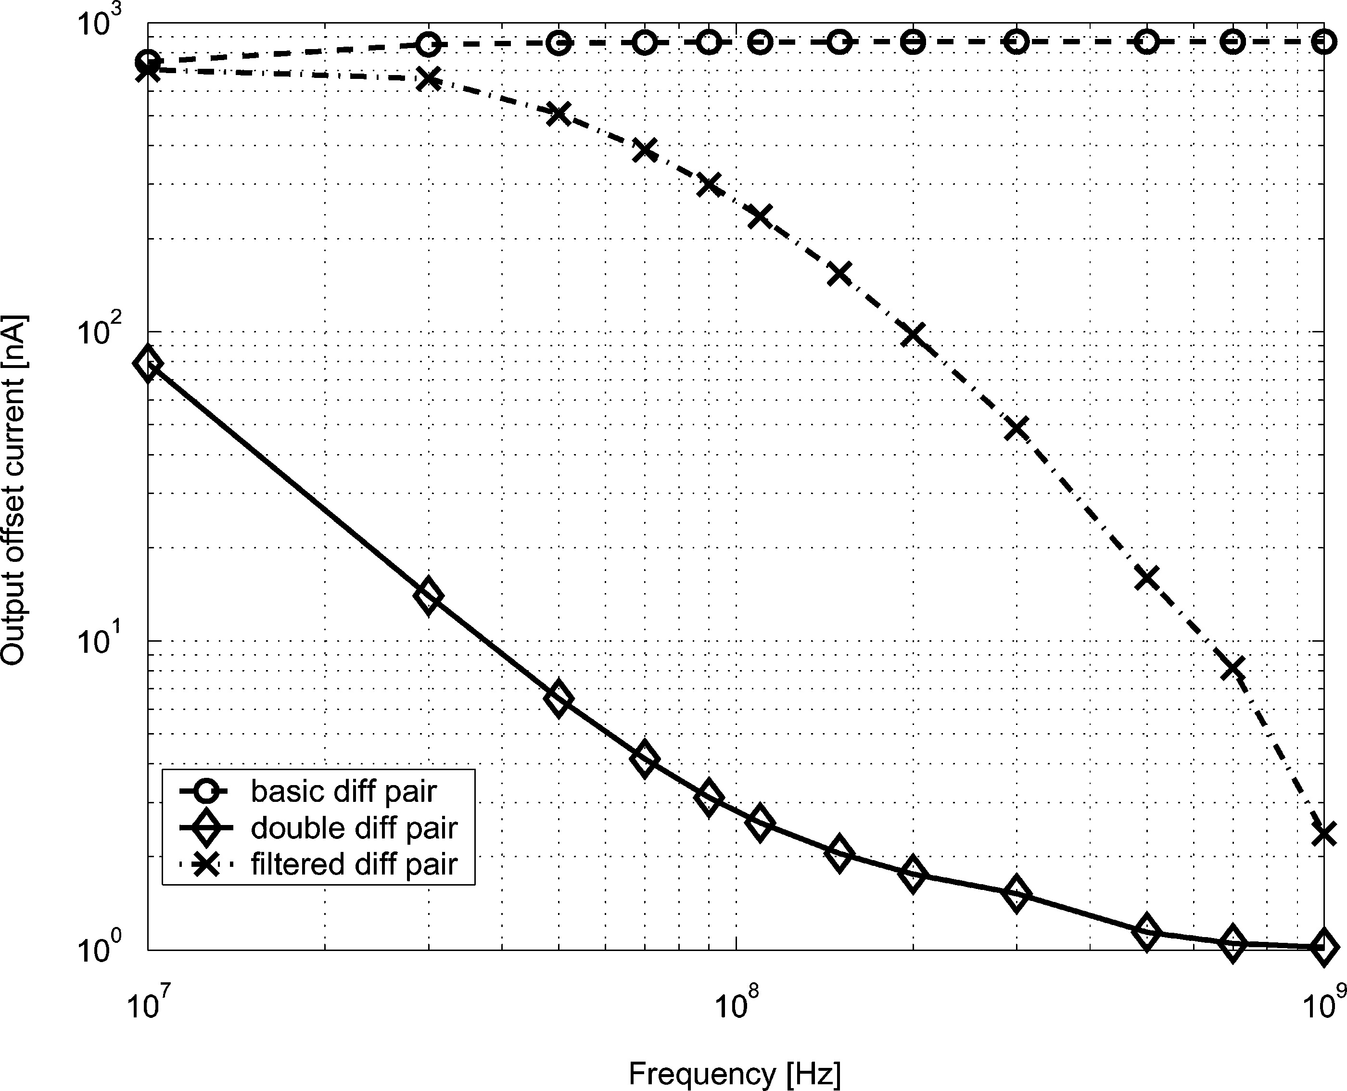
[picture p79: figure]

Fig. 7. | Output offset current of the double differential pair (diamonds over
continuous line), basic differential pair (circles over dashed line), and filtered differential pair (crosses over dashed-dotted lines) versus interference frequency. Sinusoidal interference of constant amplitude 2Vcm ,pk = Vd,pk = 200 mV are considered.

the analysis of its layout view. On the basis of these data and considering the case of sinusoidal interference of maximum amplitude 2Vcm,pk = Vd,pk = 200 mV, the maximum output offset current of M1-M2 is id1 =0.9 µA. Therefore, with a bias current I02 =3 µA, the aspect ratio of the transistor M3-M4 that minimize the total output offset current can be evaluated by (42); hence, (W/L)3,4 =5.5. Furthermore, assuming L3,4 =1 µm, and solving (41), it follows that CT 2 =1.24 pF.
These design parameters were employed to perform time-domain computer simulations with sinusoidal interference having amplitude of 2Vcm,pk = Vd,pk = 200 mV and frequency in the range 10 MHz–1 GHz. The results of these simulations are shown in Fig. 7 by diamonds over continuous line. In the same figure circles over dashed line show the output offset current of the basic differential pair M1-M2, while crosses over the dashed-dotted line refers to the circuit in Fig. 5, in which the low-pass filters have cutoff frequency of fp = 60 MHz. Concerning this last circuit, an opamp with gain-bandwidth product of GBW = 6 MHz and phase margin of PM = 70◦ has been considered, and the cutoff frequency fp has been selected in order to improve the opamp immunity and to fulfill the opamp stability constraints as well. Further reduction of this cutoff frequency under 60 MHz can be accomplished only with a proper design of the opamp compensation network. These results point out that the double differential stage is more immune to RFI than conventional differential pairs, and the output offset current decreases with frequency. This fact can be ascribed to the RFI distortion in the pair M3-M4, which becomes completely effective at higher frequencies, compensating that induced by RFI in the main differential pair (M1-M2).
V. CONCLUSION

In this paper, the effect of electromagnetic interference on the operation of MOS differential stages has been evaluated. To this purpose, general interfering signals, which have been expressed in terms of power spectral density, have been elaborated by a new analytical model to predict EMI-induced upsets. Furthermore, some examples that highlight the benefits deriving from this new model have been shown, and in the last two sections of the paper, this model has been successfully employed in the design of a new differential stage that shows high immunity to EMI. Finally, the performance of this new circuit has been compared with those of other circuit topologies.

REFERENCES

[1] B. Murari and F. Bertotti, Smart Power ICs. New York: Springer, 2002.
[2] S. Ben Dhia, M. Ramdani, and E. Sicard, Electromagnetic Compatibility of Integrated Circuits: Techniques for Low Emission and Susceptibility. New York: Springer, 2006.
[3] F. Fiori and P. S. Crovetti, “Nonlinear effects of radio-frequency interference in operational amplifiers,” in IEEE Trans. Circuits Syst. I, Fundam. Theory Appl., vol. 49, pp. 367–372, Mar. 2002.
[4] “Integrated circuit electromagnetic susceptibility handbook,” McDonnell Douglas Astronautic Co., St. Louis, MO, Tech. Rep. MDC E1929, 1978.
[5] J. G. Tront, J. J. Whalen, and C. E. Larson, “Computer aided analysis of RFI effect in operational amplifiers,” in IEEE Trans. Electromagn. Compat., vol. EMC-21, pp. 297–306, Nov. 1979.
[6] F. Fiori and P. S. Crovetti, “Prediction of EMI effects in operational amplifiers by a two input Volterra series model,” in Inst. Elect. Eng. Proc. Circuit, Devices Syst., vol. 150, no. 3, pp. 185–193, Jun. 2003.
[7] “BYQ 0.8 µm BiCMOS process parameters,” Rev. 3, AustriaMicroSystems, Schloss Premstaetten, Austria, Jul. 2002.
[8] C. R. Paul, Introduction to Electromagnetic Compatibility. New York: Wiley, 1992.
[9] F. Fiori, “Operational amplifier input stage robust to EMI,” in Electron. Lett., vol. 37, no. 15, pp. 930–931, Jul. 2001.
[10] F. Fiori and P. Crovetti, “Complementary differential pair with a high immunity to RF,” Electron. Lett., vol. 38, no. 25, pp. 1663–1664, Dec. 2002.

Franco Fiori (M’02) was born in Sassari in 1968. He received the Laurea and Ph.D degrees in electronic engineering from the politechnic University of Torino, Turin, Italy, in 1993 and 1997, respectively. From 1997 to 1998, he was with the R&D devision of STMicroelectronis as the Leader of the electromagnetic Compatibility (EMC) group. In 1999, he joined the Electronics Department of the politechnic University of Torino, where he is an Associate Professor of Electronics. His current research interests include analog circuit analysis and design, nonlinear circuits, device modeling and electromagnetic compatibility. In particular, he investigates nonlinear effects of radiofrequency and microwave signals on base-band analog, digital, and mixed signals integrated circuits. Also, he works on the control by design of microprocessors and microcontrollers electromagenetic emission.
He is the author or coauthor of more than 70 papers published in international journals and conference proceedings.
