13093053/barfmachine/products/measurement_reports/power_amplifier/readme.txt

In this folder:
- calculations power amplifier
- simulations power amplifier
- design power amplifier
- measurements power amplifier
