13093053/barfmachine/products/measurement_reports/balance_control/balance_control_group_1_PRO-Q2.pdf

## Measurement Report: Balance Control PRO-Q2

Daan Conijn, 13023217
Andrew Lau, 13058339
Kevin Oei,13090062
Koen van Vliet, 13093053
Group 1

EQ2.a
EQ2.c

May 29th, 2015

5 | Contents
1 The objective of the measurement | 3
2 Measurement setup | 3
3 Results | 5
4 Conclusion | 11
5 Appendix | 12

2

15 | 1 | The objective of the measurement

The objective of the measurement is to get more insight in how the balance control functions and to determine whether the balance control meets the specifications. The measurement is also a preparation for the assessment of the project.

20 | 2 | Measurement setup

Figure 1 shows the schematic of the balance control. The schematic of the balance control in figure 1 is slightly different from the balance control as de-scribed in the project manual. The capacitors C5 and C6 are included and these capacitors prevent direct current flowing through the potentiometer and 25 the wiper.


Figure 1: Balance control schematic

The balance control is soldered on a circuit board as seen in figure 2.

3


Figure 2: Balance control on a circuit board

The balance control is connected to the following equipment:

- The input of the balance amplifier is connected to a function generator,

4

’BK PRECISION 4052’. The input signal is a sine with an amplitude of
30 | | 200mVpk-pk.
| | • A power supply is connected to the positive (+15V) and negative (-15V)
| | terminals of the amplifier.
| | • The signals ’out’ and ’in’ are measured by using the oscilloscope, ’TEK-
| | TRONIX DPO2004B’.
35 | 3 | Results

### 3.1 Balance control specifications

- Range ±6 dB (within ±0.5 dB) difference between right and left channels
- In flat position +2 dB (within ±0.5 dB)
- Approximate logarithmic control function

40 • No DC current through the potentiometer nor the wiper

### 3.2 Calculations


Figure 3: Positions of RH and RL of the potentiometer

5

The formula for the gain of the balance control is equal to:

Gain =

R1//RH + RL + R2
RL + R2

= 1 +

R1//R
RL + R2

(1)

It is known that the gain must be 2dB in flat position. Therefore the gain can be derived:

20 · log(Af lat−position) = 2dB

log(Af lat−position) = 1
10

Af lat−position = 10

1
10 ≈ 1, 26 | (2)
45 | The gain must be 6dB if the balance control is in maximum position. Therefore
the gain can be derived with the potentiometer in maximum position:

20 · log(Ahigh) = 6dB

log(Ahigh) = 3
10

Ahigh = 10

3
10 ≈ 2 | (3)

Equation 2can be substituted in 1 and RH and RL are 5,000Ω.

1, 26 =

5, 000 · R1
(R1 + 5, 000) · (R2 + 5, 000)

R2 + 5000 =

5, 000 · R1
1.26 · (R1 + 5, 000)

R2 =

3, 700 · R1 − 6.5 · 10⁶
1.26 · R1 + 1, 300) | (4)

6

3can be substitute in 1, RH = 10,000Ω and RL = 0Ω. The value of RLis actually very small (±0,5Ω) but because the value is very small, RL can be omitted.

2 = 1 +

10, 000 · R1
(R1 + 10, 000) · R2

R2 =

10, 000 · R1
(R1 + 10, 000) | (5)
50 | 5can be substituted in 4 and therefore the value of R1 can be calculated.
| 3, 700 · R1 − 6.5 · 10⁶ 1.26 · R1 + 1, 300) = 10, 000 · R1 (R1 + 10, 000)

2, 600R

2

1 + 13 · 10⁶
- R1 = 3, 700 · R

2

1 + 30.5 · 10⁶

- R1 − 6.5 · 10¹⁰

1, 100R

2

1 + 17.5 · 10⁶

- R1 − 6.5 · 10¹⁰ = 0

R1R1 =

17.5 · 10⁶ ± 24, 336, 187
2, 200
R1 = 3, 107.35 ≈ 3, 107Ω | (6)
R1 = −19, 016Ω | (7)

A resistor can never have a negative value so therefore R1 is equal to 3,107Ω. To calculate R2 , 6 can be filled in in 4 or 5.

R2 =

10, 000 · 3, 107
(3, 107 + 10, 000) = 2, 370Ω | (8)

7

### 3.3 Simulations

The software ’Tina-TI’ is used for the simulation of the balance control.

55 Figure 4 shows the bode plot of the balance control in maximum position.

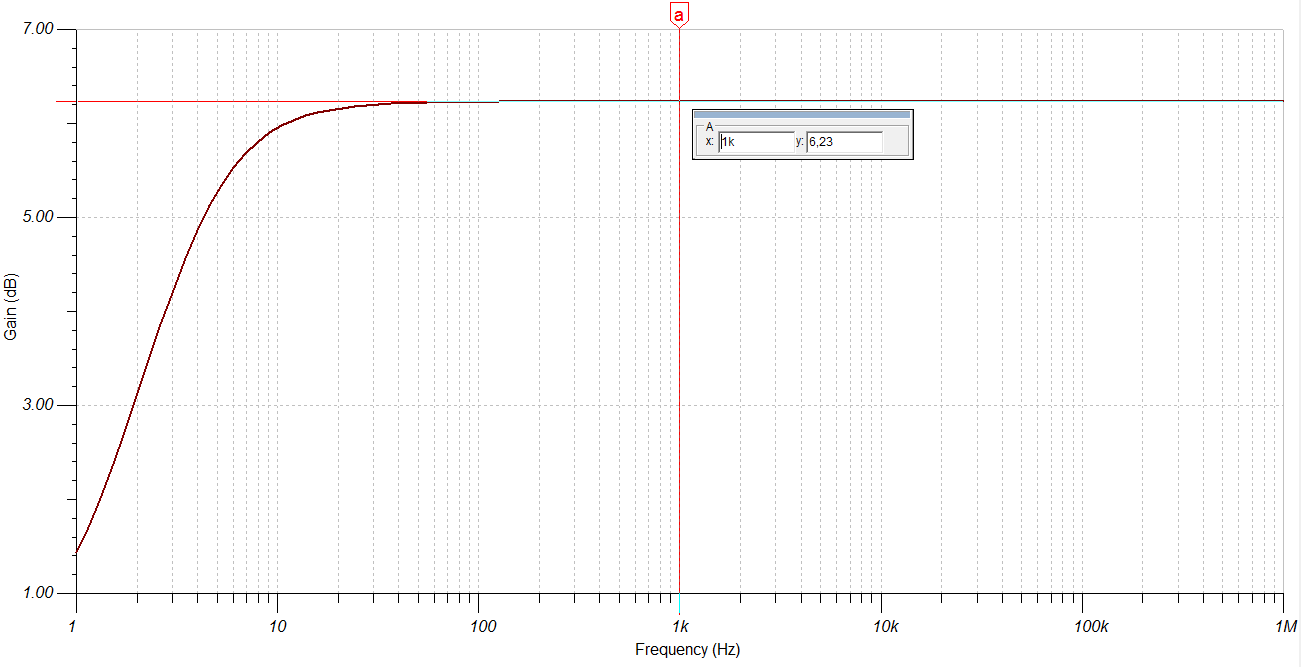
[picture p87: figure]

Figure 4: Simulation maximum position

Figure 5 gives the bode plot of the balancecontrol in flat position.

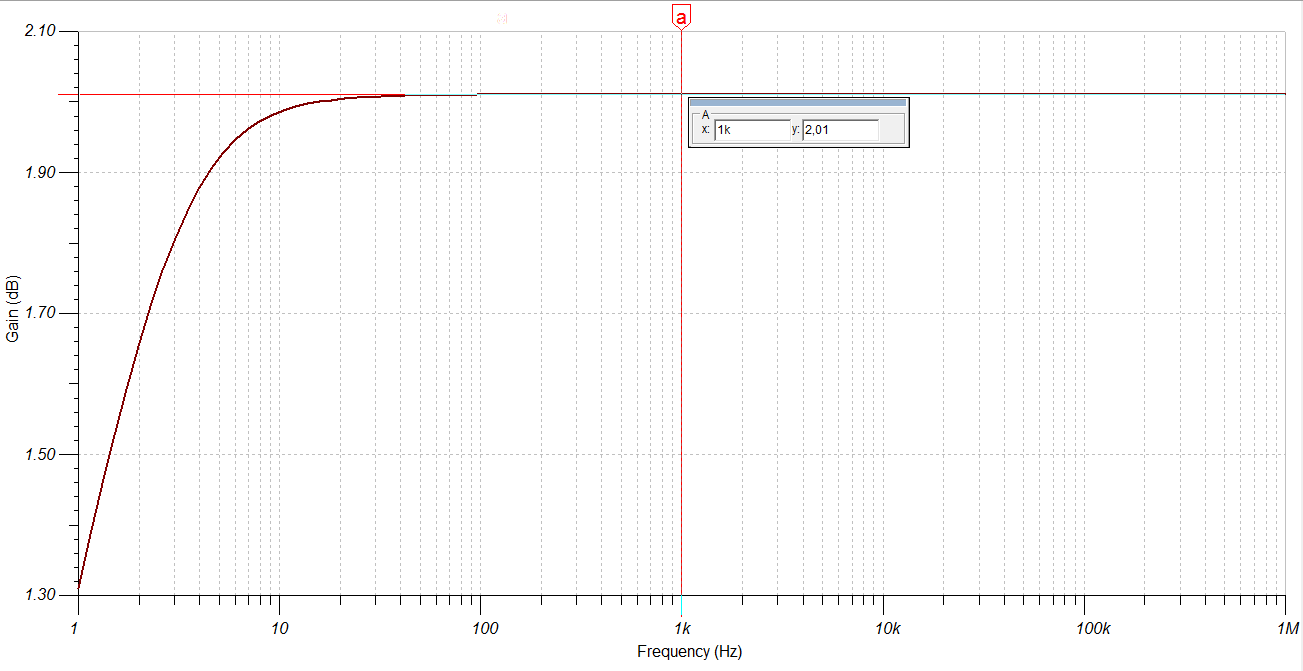
[picture p88: figure]

Figure 5: Simulation flat position

Figure 6 gives the bode plot of the balance control in minimum position.

8

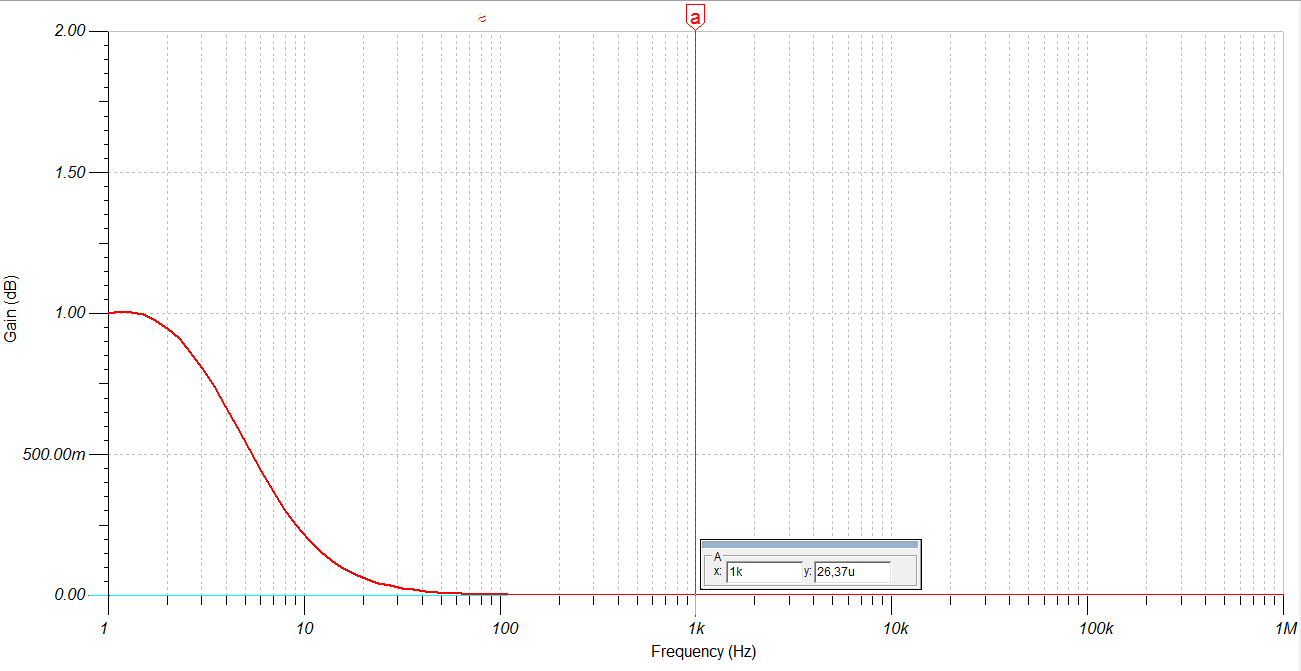
[picture p89: figure]

Figure 6: Simulation minimum position

### 3.4 Measurements

The results of the measurements can be found in the appendix.

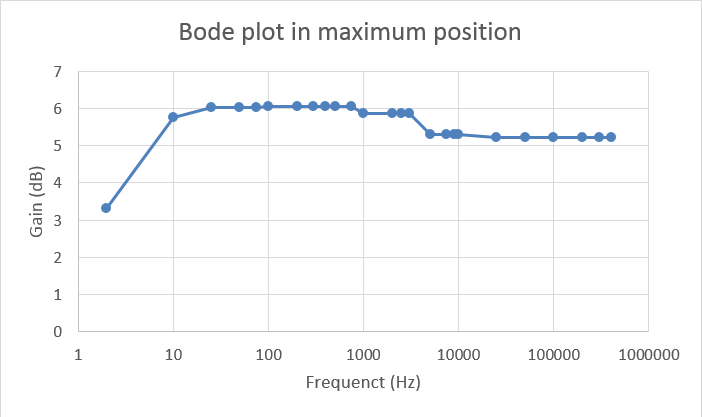
[picture p90: figure]

Figure 7: Bode plot of the measurement in maximum position

9

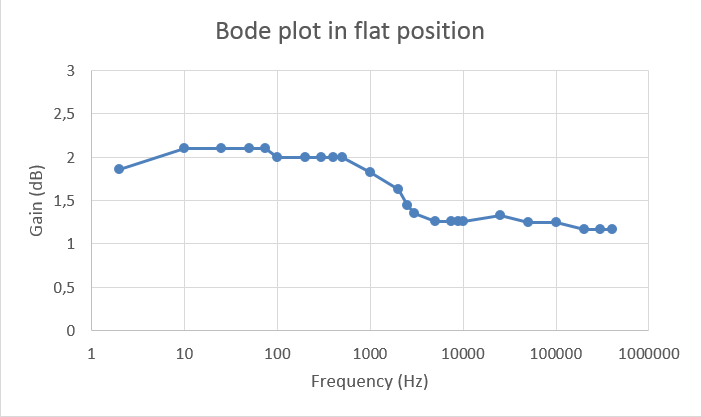
[picture p91: figure]

Figure 8: Bode plot of the measurement in flat position

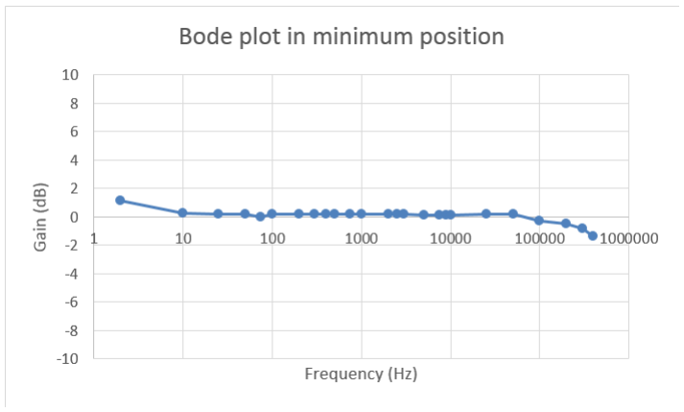
[picture p92: figure]

Figure 9: Bode plot of the measurement in minimum position

10

60 | 4 | Conclusion

The bode plot of the measurement in minimum position closely approaches the bode plot of the simulation in minimum position. There is however differences between the bode plots in flat position and maximum position.

The gain is not 2dB throughout the entire frequency range (2Hz-400kHz) in
65 | the measurement in flat position. In the simulation in flat position, the gain is approximately 2dB in the frequency range of 10Hz-400kHz.
| The gain is not 6dB throughout the entire frequency range (2Hz-400kHz) in the
| measurement in maximum position. In the simulation in maximum position, the gain is approximately 6dB in the frequency range of 10Hz-400kHz.
70 | The similarity between the bode plot of the measurement in flat position and the bode plot of the measurement in maximum position is that the gain decreases by approximately 1dB at a frequency of approximately 2kHz. Disturbances in the surrounding area of the circuit or noise are possible reasons why this phenomenon occurs.
75 | Despite the differences between the measurements and simulations, the balance control still meets the specifications.

11

## 5 Appendix

Table 1: Measurements balance control minimum position
Frequency (Hz) | Vin | Vout | Gain (dB)
2 | 0.088 | 0.1 | 1.110346557
10 | 0.088 | 0.092 | 0.287956414
25 | 0.088 | 0.09 | 0.195196746
50 | 0.088 | 0.09 | 0.195196746
75 | 0.088 | 0.088 | 0
100 | 0.088 | 0.09 | 0.195196746
200 | 0.088 | 0.09 | 0.195196746
300 | 0.088 | 0.09 | 0.195196746
400 | 0.088 | 0.09 | 0.195196746
500 | 0.088 | 0.09 | 0.195196746
750 | 0.088 | 0.09 | 0.195196746
1,000 | 0.088 | 0.09 | 0.195196746
2,000 | 0.088 | 0.09 | 0.195196746
2,500 | 0.088 | 0.09 | 0.195196746
3,000 | 0.088 | 0.09 | 0.195196746
5,000 | 0.088 | 0.089 | 0.09814669
7,500 | 0.088 | 0.089 | 0.09814669
9,000 | 0.088 | 0.089 | 0.09814669
10,000 | 0.088 | 0.089 | 0.09814669
25,000 | 0.088 | 0.09 | 0.195196746
50,000 | 0.088 | 0.09 | 0.195196746
100,000 | 0.088 | 0.085 | -0.301274929
200,000 | 0.088 | 0.083 | -0.508091595
300,000 | 0.088 | 0.08 | -0.827853703
400,000 | 0.088 | 0.075 | -1.388428175

12

Table 2: Measurements balance control flat position
Frequency (Hz) | Vin | Vout | Gain (dB)
2 | 0.088 | 0.109 | 1.858876516
10 | 0.088 | 0.112 | 2.09470701
25 | 0.088 | 0.112 | 2.09470701
50 | 0.088 | 0.112 | 2.09470701
75 | 0.088 | 0.112 | 2.09470701
100 | 0.089 | 0.112 | 1.996560321
200 | 0.089 | 0.112 | 1.996560321
300 | 0.089 | 0.112 | 1.996560321
400 | 0.089 | 0.112 | 1.996560321
500 | 0.089 | 0.112 | 1.996560321
1,000 | 0.09 | 0.111 | 1.821609387
2,000 | 0.092 | 0.111 | 1.630703029
2,500 | 0.094 | 0.111 | 1.443902504
3,000 | 0.095 | 0.111 | 1.35198747
5,000 | 0.096 | 0.111 | 1.261034915
7,500 | 0.096 | 0.111 | 1.261034915
9,000 | 0.096 | 0.111 | 1.261034915
10,000 | 0.096 | 0.111 | 1.261034915
25,000 | 0.097 | 0.113 | 1.326134184
50,000 | 0.097 | 0.112 | 1.248925768
100,000 | 0.097 | 0.112 | 1.248925768
200,000 | 0.097 | 0.111 | 1.17102489
300,000 | 0.097 | 0.111 | 1.17102489
400,000 | 0.097 | 0.111 | 1.17102489

13

Table 3: Measurements balance control maximum position
Frequency (Hz) | Vin | Vout | Gain (dB)
2 | 0.088 | 0.129 | 3.322140763
10 | 0.088 | 0.171 | 5.770268765
25 | 0.088 | 0.176 | 6.020599913
50 | 0.088 | 0.176 | 6.020599913
75 | 0.088 | 0.176 | 6.020599913
100 | 0.088 | 0.177 | 6.069811884
200 | 0.088 | 0.177 | 6.069811884
300 | 0.088 | 0.177 | 6.069811884
400 | 0.088 | 0.177 | 6.069811884
500 | 0.088 | 0.177 | 6.069811884
750 | 0.088 | 0.177 | 6.069811884
1,000 | 0.09 | 0.177 | 5.874615138
2,500 | 0.09 | 0.177 | 5.874615138
5,000 | 0.096 | 0.177 | 5.314040666
7,500 | 0.096 | 0.177 | 5.314040666
9,000 | 0.096 | 0.177 | 5.314040666
10,000 | 0.096 | 0.177 | 5.314040666
25,000 | 0.097 | 0.177 | 5.224030642
50,000 | 0.097 | 0.177 | 5.224030642
100,000 | 0.097 | 0.177 | 5.224030642
200,000 | 0.097 | 0.177 | 5.224030642
300,000 | 0.097 | 0.177 | 5.224030642
400,000 | 0.097 | 0.177 | 5.224030642

14
