13093053/barfmachine/products/measurement_reports/poweramp-measurements.xlsx

 | Schematics required
 | Imput impedance
 | f | infinite
 | Rin | 56kOhm
 | Frequency response no load
Test conditions | Vsupply | +15 -15V (30V total)
(Absolute values) | Rload | infinite
Test results | f(Hz) | Vin | Vout | Gain(dB)
(RMS values) | 5 | 0.4 | 4.97 | 21.88592795
 | 10 | 0.4 | 7.34 | 25.27272137
 | 50 | 0.4 | 9.33 | 27.35643305
 | 100 | 0.4 | 9.44 | 27.45824006
 | 500 | 0.4 | 9.48 | 27.49496692
 | 1000 | 0.41 | 9.46 | 27.26214559
 | 5000 | 0.44 | 9.4 | 26.59350354
 | 10000 | 0.44 | 9.38 | 26.57500324
 | 50000 | 0.44 | 9.25 | 26.45378113
 | 100000 | 0.44 | 9.07 | 26.28309221
 | 250000 | 0.45 | 7.7 | 24.66556423
 | 500000 | 0.45 | 4.5 | 20
 | 1000000 | 0.45 | 2.19 | 13.74463202
Conclusion | The required bandwidth of 10Hz to 100kHz with no load was achieved.
Test conditions | Frequency response 0.5W
(Absolute values) | Vsupply | +25 -25 (50v total)
 | Rload | 8Ohm
 | Pload | 0.5W
Test results | f(Hz) | Vin | Vout | Gain(dB)
(RMS values) | 5 | 0.17 | 1.38 | 18.1886033
 | 10 | 0.18 | 1.77 | 19.85401523
 | 50 | 0.18 | 2.02 | 21.00157729
 | 100 | 0.18 | 2.04 | 21.08715325
 | 500 | 0.18 | 2.04 | 21.08715325
 | 1000 | 0.18 | 2.05 | 21.12962712
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
