13093053/barfmachine/products/measurement_reports/balance_control/readme.txt

In this folder:
- calculations balance control
- simulations balance control
- design balance control
- measurements balance control
