13093053/barfmachine/products/measurement_reports/tone_control/readme.txt

In this folder:
- calculations tone control
- simulations tone control
- design tone control
- measurements tone control
