13093053/barfmachine/products/measurement_reports/volume_control/readme.txt

In this folder:
- calculations volume control
- simulations volume control
- design volume control
- measurements volume control
