13093053/barfmachine/products/measurement_reports/preamplifier/measurement/measurement_preamplifier.xlsx

Maximum attenuation |  |  |  |  | Maximum boost
frequency (Hz) | Vin (mV) | Vout (mV) | Gain (Vout/Vin) | Gain (dB) | frequency (Hz) | Vin (V) | Vout (V) | Gain (Vout/Vin) | Gain (dB)
2 | 90 | 12 | 0.1333333333 | -17.50122527 | 2 | 90 | 13.1 | 0.1455555556 | -16.73942428
3 | 89.8 | 13 | 0.144766147 | -16.78665969 | 10 | 90 | 23.4 | 0.26 | -11.70053304
5 | 90 | 13.1 | 0.1455555556 | -16.73942428 | 25 | 90 | 38.1 | 0.4233333333 | -7.466350675
7 | 90 | 12.5 | 0.1388888889 | -17.14664993 | 50 | 90 | 45.9 | 0.51 | -5.848596478
10 | 90 | 12 | 0.1333333333 | -17.50122527 | 75 | 90 | 45.9 | 0.51 | -5.848596478
25 | 90 | 9.5 | 0.1055555556 | -19.53037808 | 100 | 90 | 42.9 | 0.4766666667 | -6.435704345
50 | 90 | 9.3 | 0.1033333333 | -19.71519122 | 200 | 90 | 32.5 | 0.3611111111 | -8.847182969
75 | 90 | 9.5 | 0.1055555556 | -19.53037808 | 300 | 90 | 26.7 | 0.2966666667 | -10.55462496
100 | 90 | 9.8 | 0.1088888889 | -19.26032867 | 400 | 90 | 23.8 | 0.2644444444 | -11.55331105
200 | 90 | 11 | 0.1222222222 | -18.25699649 | 500 | 90 | 22.3 | 0.2477777778 | -12.11875293
300 | 90 | 12 | 0.1333333333 | -17.50122527 | 1000 | 90 | 20.4 | 0.2266666667 | -12.89224684
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
