13093053/barfmachine/products/measurement_reports/tone_control/measurement/measurement_tone_control.xlsx

Bass and Treble at -10dB |  |  |  |  | Bass and Treble at 0dB |  |  |  |  | Bass and Treble at 10dB
frequency (Hz) | Vin (V) | Vout (V) | Gain (Vout/Vin) | Gain (dB) | frequency (Hz) | Vin (V) | Vout (V) | Gain (Vout/Vin) | Gain (dB) | frequency (Hz) | Vin (V) | Vout (V) | Gain (Vout/Vin) | Gain (dB)
2 | 0.087 | 0.057 | 0.6551724138 | -3.672887939 | 2 | 0.088 | 0.062 | 0.7045454545 | -3.041819653 | 2 | 0.087 | 0.0664 | 0.7632183908 | -2.347023465
10 | 0.087 | 0.049 | 0.5632183908 | -4.986463452 | 10 | 0.088 | 0.087 | 0.9886363636 | -0.09926839063 | 10 | 0.087 | 0.133 | 1.528735632 | 3.686647767
25 | 0.088 | 0.036 | 0.4090909091 | -7.763603428 | 25 | 0.089 | 0.093 | 1.04494382 | 0.3818588382 | 25 | 0.086 | 0.223 | 2.593023256 | 8.276128236
50 | 0.088 | 0.034 | 0.3863636364 | -8.260075102 | 50 | 0.088 | 0.093 | 1.056818182 | 0.4800055281 | 50 | 0.085 | 0.271 | 3.188235294 | 10.0710073
75 | 0.087 | 0.035 | 0.4022988506 | -7.909024165 | 75 | 0.088 | 0.092 | 1.045454545 | 0.3861031039 | 75 | 0.085 | 0.265 | 3.117647059 | 9.876538964
100 | 0.087 | 0.04 | 0.4597701149 | -6.749185226 | 100 | 0.088 | 0.092 | 1.045454545 | 0.3861031039 | 100 | 0.085 | 0.246 | 2.894117647 | 9.230323628
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
