13093053/barfmachine/products/measurement_reports/balance_control/measurement/measurement_balance_control.xlsx

Low position |  |  |  |  | Middle position |  |  |  |  | High Position
frequency (Hz) | Vin (V) | Vout (V) | Gain (Vout/Vin) | Gain (dB) | frequency (Hz) | Vin (V) | Vout (V) | Gain (Vout/Vin) | Gain (dB) | frequency (Hz) | Vin (V) | Vout (V) | Gain (Vout/Vin) | Gain (dB)
2 | 0.088 | 0.1 | 1.136363636 | 1.110346557 | 2 | 0.088 | 0.109 | 1.238636364 | 1.858876516 | 2 | 0.088 | 0.129 | 1.465909091 | 3.322140763
10 | 0.089 | 0.092 | 1.033707865 | 0.287956414 | 10 | 0.088 | 0.112 | 1.272727273 | 2.09470701 | 10 | 0.088 | 0.171 | 1.943181818 | 5.770268765
25 | 0.088 | 0.09 | 1.022727273 | 0.1951967458 | 25 | 0.088 | 0.112 | 1.272727273 | 2.09470701 | 25 | 0.088 | 0.176 | 2 | 6.020599913
50 | 0.088 | 0.09 | 1.022727273 | 0.1951967458 | 50 | 0.088 | 0.112 | 1.272727273 | 2.09470701 | 50 | 0.088 | 0.176 | 2 | 6.020599913
75 | 0.088 | 0.088 | 1 | 0 | 75 | 0.088 | 0.112 | 1.272727273 | 2.09470701 | 75 | 0.088 | 0.176 | 2 | 6.020599913
100 | 0.088 | 0.09 | 1.022727273 | 0.1951967458 | 100 | 0.089 | 0.112 | 1.258426966 | 1.996560321 | 100 | 0.088 | 0.177 | 2.011363636 | 6.069811884
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
