13093053/barfmachine/products/measurement_reports/volume_control/measurement/measurement_volume_control.xlsx

Low position |  |  |  |  | Middle position |  |  |  |  | High position
frequency (Hz) | Vin (V) | Vout (V) | Gain (Vout/Vin) | Gain (dB) | frequency (Hz) | Vin (V) | Vout (V) | Gain (Vout/Vin) | Gain (dB) | frequency (Hz) | Vin (V) | Vout (V) | Gain (Vout/Vin) | Gain (dB)
2 | 0.088 | 0.007 | 0.07954545455 | -21.98769264 | 2 | 0.088 | 0.01 | 0.1136363636 | -18.88965344 | 2 | 0.088 | 0.012 | 0.1363636364 | -17.30602852
10 | 0.088 | 0.007 | 0.07954545455 | -21.98769264 | 10 | 0.088 | 0.014 | 0.1590909091 | -15.96709273 | 10 | 0.088 | 0.048 | 0.5454545455 | -5.264828695
25 | 0.088 | 0.0071 | 0.08068181818 | -21.86448647 | 25 | 0.088 | 0.014 | 0.1590909091 | -15.96709273 | 25 | 0.088 | 0.115 | 1.306818182 | 2.324303364
50 | 0.088 | 0.0071 | 0.08068181818 | -21.86448647 | 50 | 0.088 | 0.015 | 0.1704545455 | -15.36782826 | 50 | 0.082 | 0.206 | 2.512195122 | 8.00106736
75 | 0.088 | 0.0071 | 0.08068181818 | -21.86448647 | 75 | 0.088 | 0.015 | 0.1704545455 | -15.36782826 | 75 | 0.078 | 0.269 | 3.448717949 | 10.75315355
100 | 0.088 | 0.0071 | 0.08068181818 | -21.86448647 | 100 | 0.088 | 0.015 | 0.1704545455 | -15.36782826 | 100 | 0.074 | 0.316 | 4.27027027 | 12.60910726
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
