13093053/barfmachine/products/measurement_reports/balance_control/measurement/bode_plot_min_pos.png

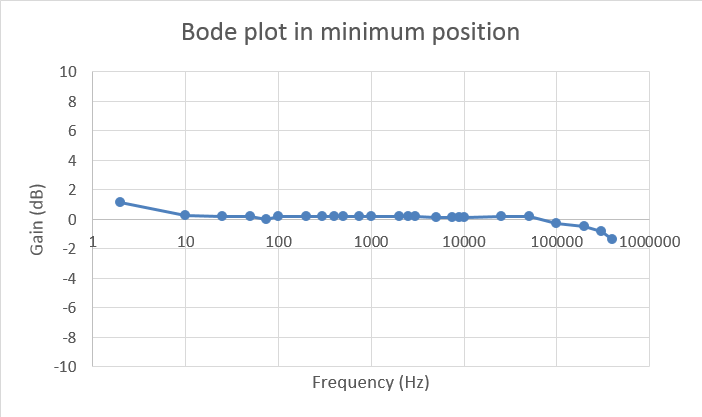
products/measurement_reports/balance_control/measurement/bode_plot_min_pos.png
