13093053/barfmachine/products/measurement_reports/power_amplifier/measurement/oscilloscope_full_power_1.png

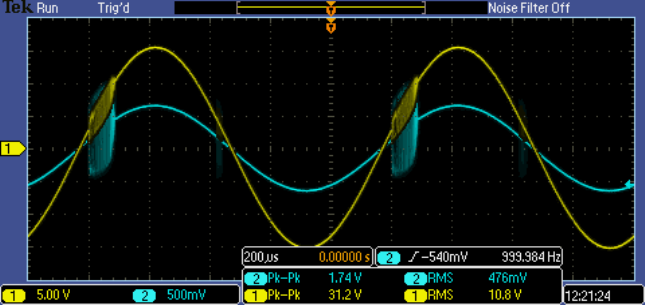
products/measurement_reports/power_amplifier/measurement/oscilloscope_full_power_1.png
