13093053/barfmachine/products/measurement_reports/power_amplifier/simulation/amp simulation.png

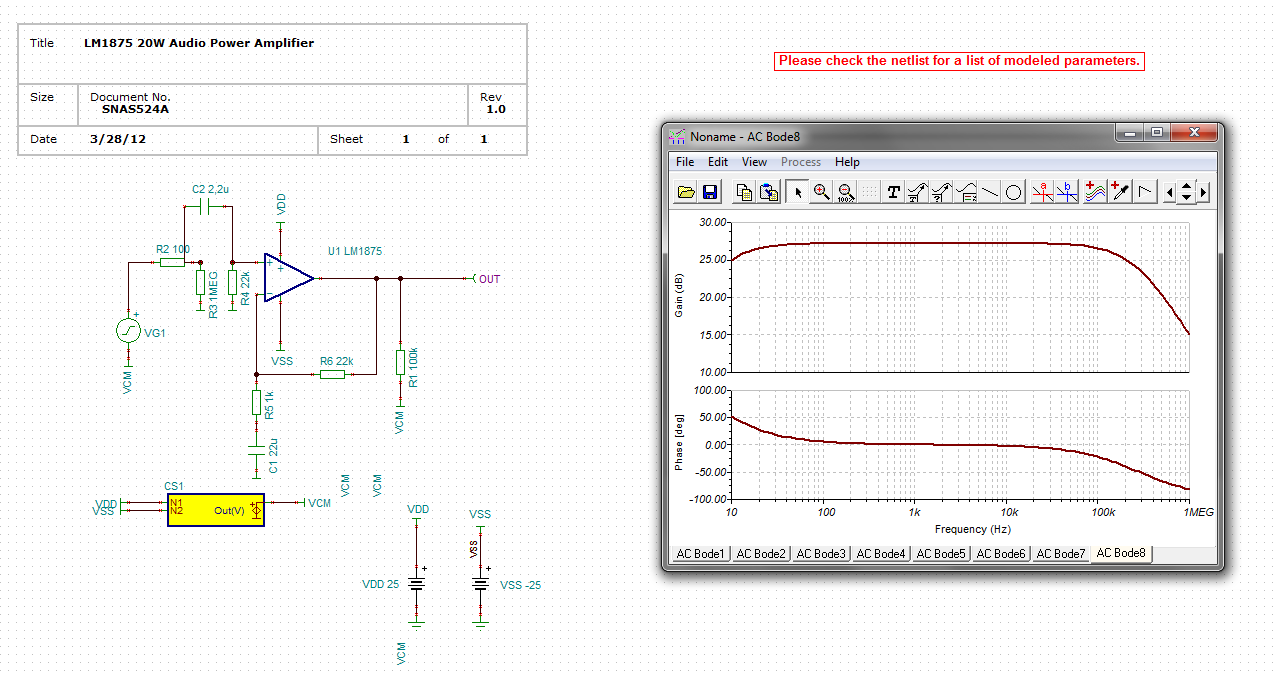
products/measurement_reports/power_amplifier/simulation/amp simulation.png
