13093053/barfmachine/products/measurement_reports/power_supply/psu.jpg

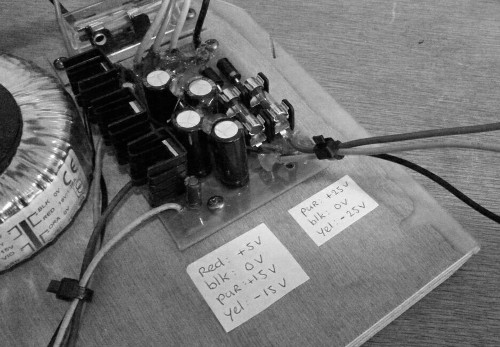
products/measurement_reports/power_supply/psu.jpg
