13093053/barfmachine/products/measurement_reports/tone_control/measurement/max_boost.png

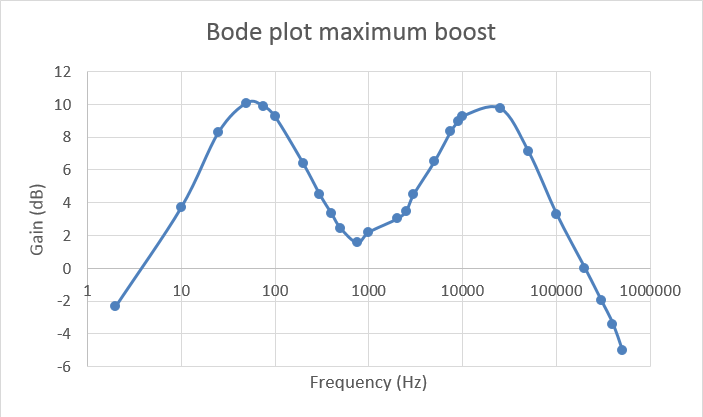
products/measurement_reports/tone_control/measurement/max_boost.png
