13093053/barfmachine/products/measurement_reports/volume_control/measurement/bode_plot_high.bmp

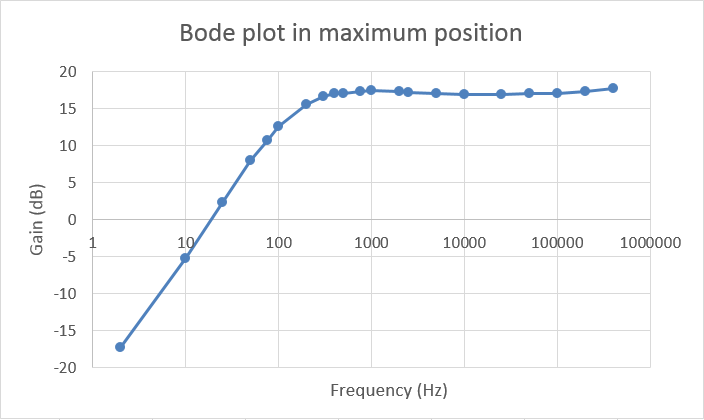
products/measurement_reports/volume_control/measurement/bode_plot_high.bmp
