13093053/barfmachine/products/measurement_reports/volume_control/measurement/bode_plot_low_position.png

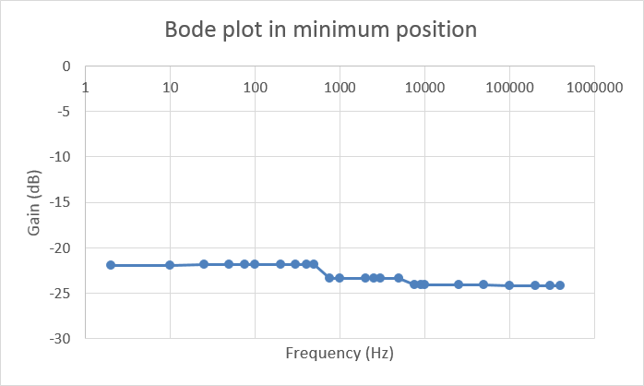
products/measurement_reports/volume_control/measurement/bode_plot_low_position.png
