13093053/barfmachine/products/measurement_reports/volume_control/measurement/bode_plot_middle_position.png

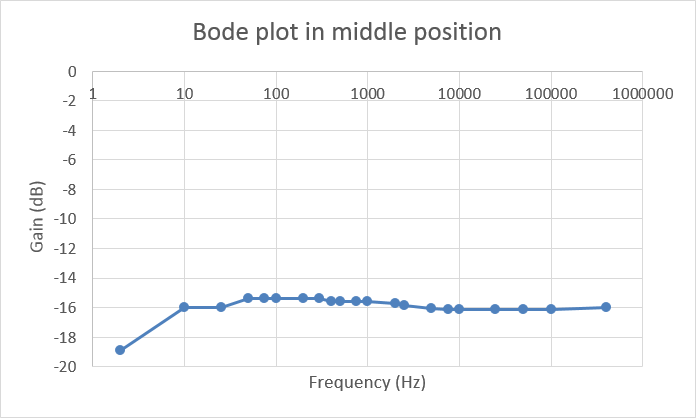
products/measurement_reports/volume_control/measurement/bode_plot_middle_position.png
