13093053/barfmachine/products/measurement_reports/volume_control/simulation/min_position_volume_control.png

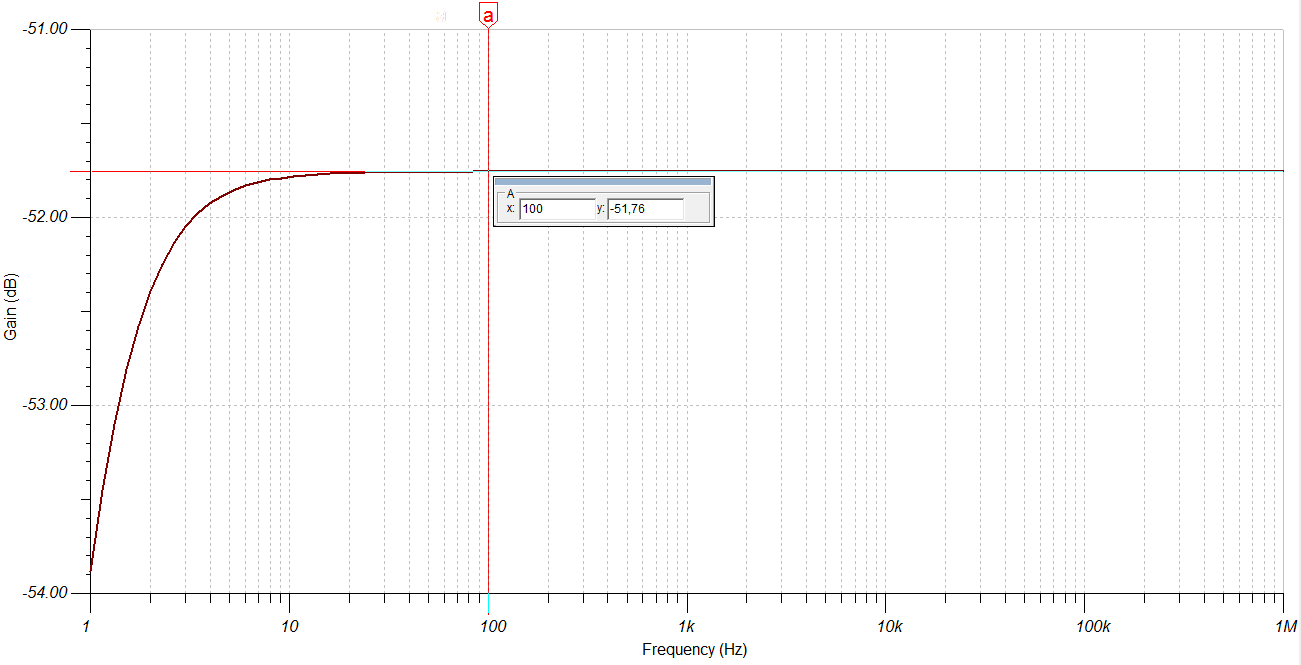
products/measurement_reports/volume_control/simulation/min_position_volume_control.png
