13093053/barfmachine/products/poster_presentation/result_table.png

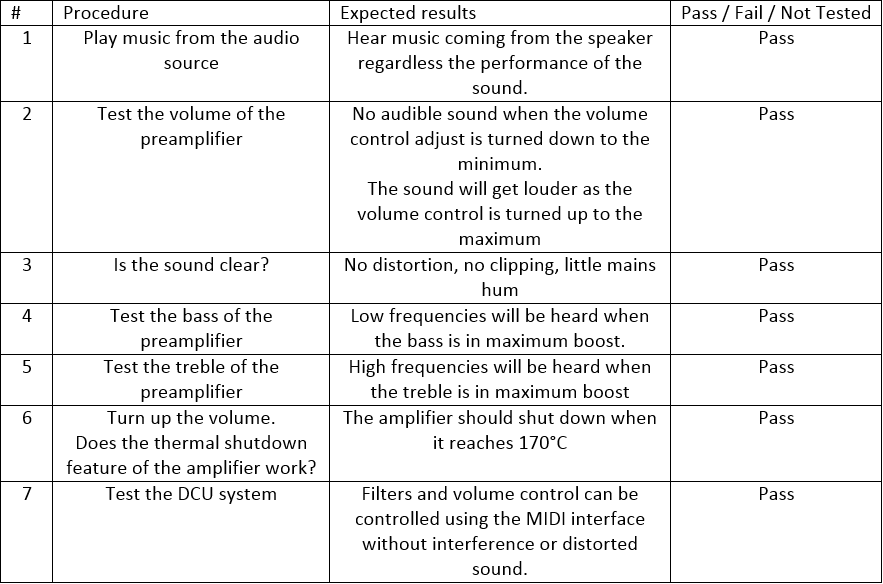
products/poster_presentation/result_table.png
