13093053/barfmachine/src/dcu_arduino/midi.h

/* TO-DO: fill in all correct values for CTRL numbers */
#ifndef MIDI_H
	#define CTRL_CH           0xB0  /* Midi controller value change */

	#define BALANCE_CTRL      0x00  /* Control number of knob used for balance control */
	#define BASS_CUT_CTRL     0x00  /* Control number of knob used for bass cut control */
	#define TREBLE_CUT_CTRL   0x00  /* Control number of knob used for treble cut control */
	#define BASS_BOOST_CTRL   0x00  /* Control number of knob used for bass boost control */
	#define TREBLE_BOOST_CTRL 0x00  /* Control number of knob used for treble boost control */
	#define VOLUME_CTRL       0x00  /* Control number of knob used for volume control */
#endif
