13093053/barfmachine/(commit log)

2015-02-16 One last fix to sort out the date
    Was printed twice due to LyX apparently putting a date on the first page
    automatically.
2015-02-22 Minutes week 3
    Sorry that the minutes are in Dutch. I was very tired at the moment and
    really didn't feel like translating the minutes. I'll translate them in
    English another day
2015-03-05 Start of project management assignment week 3
    Hey guys, I made a start of the assignment of week 3. We'll discuss it
    tomorrow.
    [project_management_week_3_planning.xlsx]
2015-03-08 Planning old version
    [project_management_week_3_planning.xlsx, project_management_week_3_planning_old.xls]
2015-03-08 Name change planning (week 3)
    [project_management_week_3_planning(editing).xlsx, project_management_week_3_planning.xlsx, project_management_week_3_planning_old.xls]
2015-03-08 Final planning
    [project_management_week_3_planning(editing).xlsx, project_management_week_3_planning.xls]
2015-04-02 Division of the Calculation Report.
    I divided the calculation report in three different reports.
    1. The monolithic power amplifier
    2. The heat sink power amplifier
    2. The power supply
    These three calculation reports has to be delivered separately.
2015-04-03 Finish Heatsink and power amplifier
    Just some checks later
2015-04-03 Power suppy
2015-04-03 Polished heat sink calc report
2015-04-03 Polished monolithic power amp calc report
2015-04-03 Last bits to mono pow amp n heat sink calc rep
    BEfore they were handed in
2015-04-03 power supply calc rep...
    not finished rip
2015-04-03 Fixed folder name of new power supply folder
2015-04-12 Answer to feedback (heat sink)
2015-04-13 New version of heat sink report
    Not sure of this is good but I want to discuss it with everyone before
    we send it. okay (y)
2015-04-14 Calculation report for power supply
2015-04-15 A picture of the heatsink
2015-04-15 Process feedback for power amp report
2015-04-15 Process feedback for power amp report #2
    For some reason the GitHub app didn't detect both files in one go..?
2015-04-15 Update power amp calc report
2015-04-15 Final changes heatsink report
2015-04-21 changed the power amplifier according to the feedback
2015-04-21 power amplifier changed according to feedback last was wrong i guess
2015-04-22 Start of the BOM (bill of materials)
    Since we got a mail from Jesse regarding the bill of materials, I
    started an excel file for it. Daan, add this as an agenda point so we
    can discuss it in the meeting with Jesse.
    [bill_of_materials_group_1.xlsx]
2015-04-23 Chosen heatsink for heatsink calculation report
2015-04-23 change in calculation of power amplifie
2015-04-23 minor changes in the heatsink and power supply
2015-05-02 Proposed bill of materials - no farnell codes yet
2015-05-04 A few additions to the BOM
2015-05-09 Final Bill of Materials and added source files for DCU
2015-05-18 Actual BOM
    [ProQ2-group1-BOM.xlsx, bill_of_materials_group_1.xlsx]
2015-05-20 More minor polishing to current DCU src
    Mostly making comments compatible with all revisions of C
2015-05-26 More minor additions to FDR I didn't push yet
    + minor commenting to DCU src to make things clearer for myself
    [dcu.c]
2015-05-27 Preperation measurement for the preamp
    preperations has been made for the measurement of the preamplifier.
    Kevin. I also added a design of the preamp in the folder
    "final_design_report" Have a check
    [measurement_balance_control.xlsx, measurement_tone_control.xlsx, measurement_volume_control.xlsx]
2015-05-28 More progress on FDR. Added Koen's measurements.
    [poweramp-measurements.xlsx]
2015-05-29 More progress preamp
    [measurement_balance_control.xlsx, measurement_tone_control.xlsx, measurement_volume_control.xlsx]
2015-05-29 Progress on FDR. Added images of power amp.
2015-05-29 Here preamp
    [measurement_tone_control.xlsx]
2015-05-29 Changes in the tone control
    [measurement_tone_control.xlsx]
2015-05-29 tone control finish
    [measurement_tone_control.xlsx]
2015-05-29 Emergency power amp measurement report base
2015-06-02 simulation and measurement preamplifier
    [measurement_preamplifier.xlsx]
2015-06-09 more work on poster presentation
    [measurement_preamplifier.xlsx]
2015-06-11 Intermediate update
    DCU part in FDR, new DCU schematic
2015-06-11 Added power supply design and minor changes to intro in final design report
2015-06-11 added appendix and measurements preamp
    [measurement_preamplifier.xlsx]
2015-06-11 Added a lot of items to the BOM
    [ProQ2-group1-BOM.xlsx]
2015-06-12 Some more todo items and BOM components
    [ProQ2-group1-BOM.xlsx]
2015-06-12 Bom done
    [ProQ2-group1-BOM.xlsx]
2015-06-12 Bill of materials
    [ProQ2-group1-BOM.xlsx]
2015-06-12 Changes of the schematics
2015-06-12 Finished DCU in FDR and made small fix in DCU src
    [dcu.c]
2015-06-12 DCU schematic
2015-06-12 Fixes power supply section FDR
2015-06-12 Bom fixed and dcu fixed
    [ProQ2-group1-BOM.xlsx]
2015-06-12 Included schematic of the DCU
2015-06-12 Power supply design added intro
2015-06-20 Porting dcu to arduino
